sparkfun/SparkFun_Pro_Micro_RP2350/.github/README.md

SparkFun Pro Micro - RP2350
========================================

SparkFun Pro Micro - RP2350 (https://www.sparkfun.com/products/24870)

[*SparkFun Pro Micro - RP2350 (DEV-28470)*](https://www.sparkfun.com/products/24870)

The SparkFun Pro Micro - RP2350 provides a powerful development platform in SparkFun's compact Pro Micro form factor built around the RP2350 from the Raspberry Pi Foundation. This board uses the updated Pro Micro form factor and includes a USB-C connector, Qwiic connector, WS2812B addressable RGB LED, Boot and Reset buttons, resettable PTC fuse as well as PTH and castellated solder pads. The board includes two expanded memory options with 16MB of external Flash and 8MB PSRAM connected to the RP2350's QSPI controller. The RP2350 also features 520kB SRAM in ten banks, a host of peripherals including 2 UARTs, 2 SPI and 2 I<sup>2</sup>C controllers, as well as a USB 1.1 controller that allows for both host and device support. The Pro Micro - RP2350 works with C/C++ using the Pico SDK along with MicroPython development environments. 

Repository Contents
-------------------

* **/Documents** - Data sheets, additional product information 
* **/Examples** - Example code 
* **/Hardware** - Eagle design files (.brd, .sch)
* **/Production** - Production panel files (.brd)
* **/docs** - GitHub Pages documentation files

Documentation
--------------
* **[Hookup Guide](https://sparkfun.github.io/SparkFun_Pro_Micro_RP2350)** - Basic hookup guide for the Pro Micro - RP2350.
* [PSRAM Library and Examples](https://github.com/sparkfun/sparkfun-pico) - A cmake library and examples to use the on-board PSRAM when developing in the Raspberry Pi [pico-sdk](https://github.com/raspberrypi/pico-sdk).

Product Versions
----------------
* [DEV-28470](https://www.sparkfun.com/products/24870) - SparkFun Pro Micro - RP2350 development board.

License Information
-------------------

This product is _**open source**_! 

Please review the LICENSE.md file for license information. 

If you have any questions or concerns on licensing, please contact technical support on our [SparkFun forums](https://forum.sparkfun.com/viewforum.php?f=152).

Distributed as-is; no warranty is given.

- Your friends at SparkFun.
