sparkfun/SparkFun_Pro_Micro_RP2350/docs/hardware_overview.md

---
icon: material/cog
---

Let's take a closer look at the RP2350 and other hardware on this Pro Micro.

## Raspberry Pi RP2350

The RP2350 from Raspberry Pi packs a whole lot of computing punch in a tiny package. The RP2350 is a unique dual-core microcontroller that has <i>four</i> internal processors (two Arm Cortex-M33 and two Hazard3 RISC-V processors @150 MHz), though you can only select any two of these four to run at the same time. 

<figure markdown>
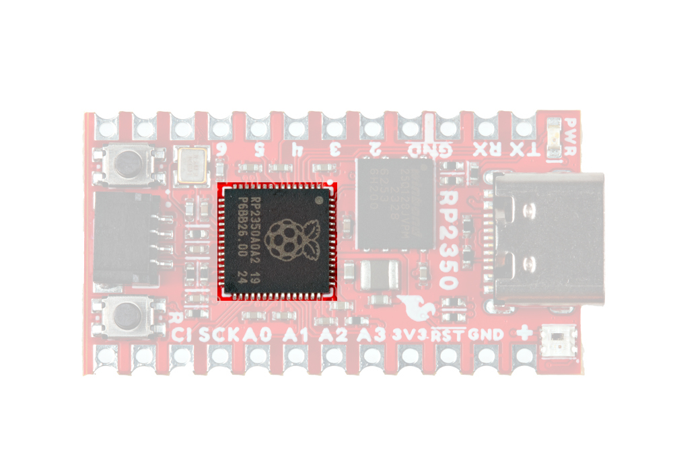
[picture p1: docs/assets/img/Pro_Micro_RP2350-RP2350.jpg]
Photo highlighting RP2350.

</figure>

This internal configuration allows users to customize the chip to their preferred architecture or to use one of each! The RP2350 includes 520kB of on-chip SRAM in ten independent banks and 8kB of one-time-programmable (OTP) storage. It also has an impressive set of security features including optional boot signing with protected OTP storage for the boot decryption key, global bus filtering (based on either Arm or RISC-V security and privilege levels) and more. For a complete overview of the RP2350, refer to the [datasheet](./assets/component_documentation/rp2350-datasheet.pdf).

The Pro Micro - RP2350 uses the "A" version of the microcontroller which has 30 3.3V-tolerant GPIO with 4 analog inputs and also includes the following peripheral options:

* 2x UART
* 2x SPI
* 2x I<sup>2</sup>C
* 24 PWM
* USB 1.1 Controller
* 12 PIO State Machines
* 1x High-Speed Transmit (HSTX) Peripheral for DVI/DSI support (not available on Pro Micro)

!!! note "Pro Micro Footprint Constraints"
	Due to size constraints on the Pro Micro footprint, only 18 GPIO are broken out, including all four analog inputs. Unfortunately, this means HSTX is <b>not</b> supported on the Pro Micro - RP2350.

The RP2350 uses five separate power supplies though this board (and most applications) combines several of them into a single regulated 3.3V supply voltage provided either over the USB-C connector or to the RAW pin. If using the RAW pin, max input voltage is <b>5.3V</b> as RAW connects directly to the WS2812 LED. 

## Memory

### W25Q128 Flash

The W25Q128 Flash IC adds 16MB of extra programming space on the Pro Micro. This connects to the RP2350 over QSPI. 

<figure markdown>
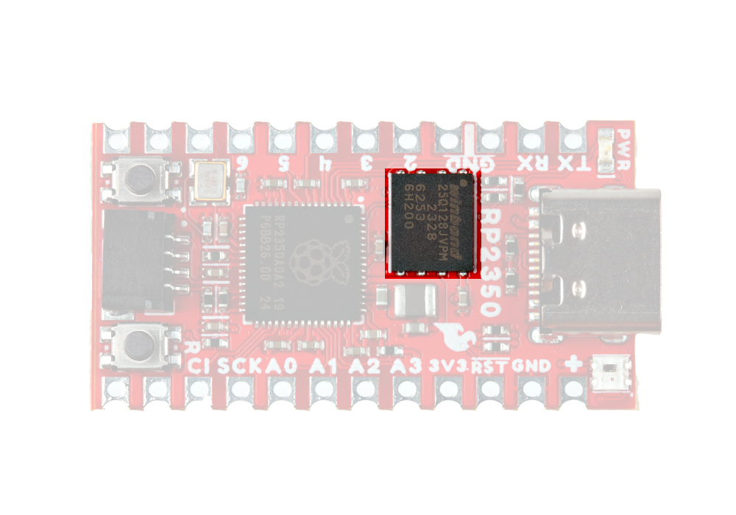
[picture p2: docs/assets/img/Pro_Micro_RP2350-Flash_IC.jpg]
Photo highlighting Flash IC.

</figure>

### PSRAM

The Pro Micro also includes an 8MB PSRAM IC for dynamic storage. This also connects to the RP2350 over QSPI. PSRAM support is included in the SparkFun MicroPython "early release" firmware found later in this guide and on the product page, but is not natively supported in the Pico SDK as of release. Refer to the Arducam Demo section of this guide for information on how to enable and set up PSRAM using the Pico SDK.

<figure markdown>
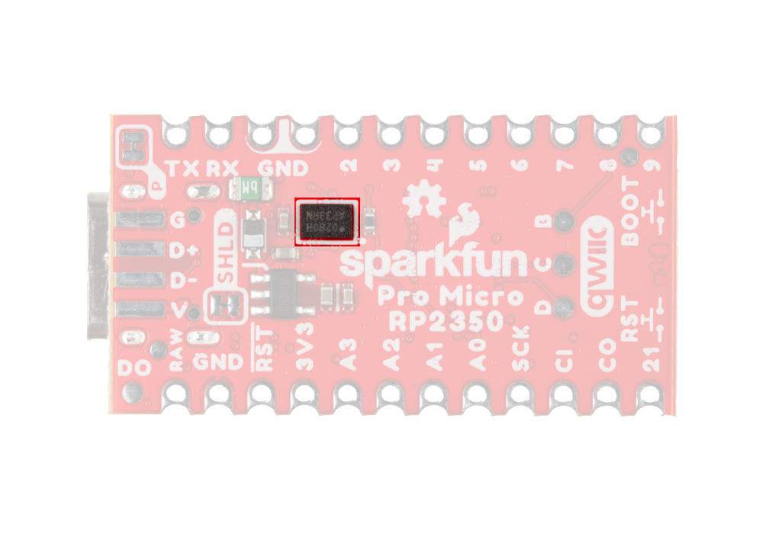
[picture p3: docs/assets/img/Pro_Micro_RP2350-IC_Back.jpg]
Photo highlighting PSRAM IC.

</figure>

For a complete overview of the PSRAM IC, refer to the [datasheet](./assets/component_documentation/APS6404L_3SQR_Datasheet.pdf).

## Connectors & Pinout

### USB-C Connector

The USB-C connector on the board acts as the primary power and programming interface. It also has surface mount solder pads on the bottom of the board for connections to the USB data lines and USB voltage. The USB-C voltage is regulated down to <b>3.3V</b> which powers all components on the board. The board also has a <b>RAW</b> PTH pin to provide a dedicated supply voltage. If using this pin, the maximum voltage allowed is <b>5.3V</b> as RAW connects directly to the WS2812.

<figure markdown>
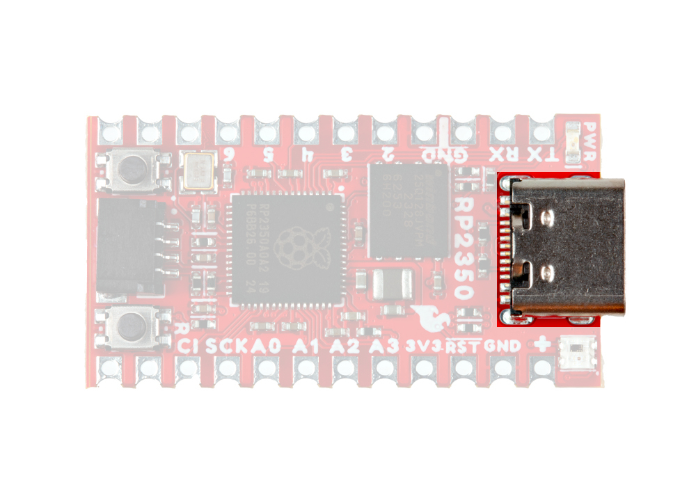
[picture p4: docs/assets/img/Pro_Micro_RP2350-USB.jpg]
Photo highlighting USB-C connector.

</figure>

### Qwiic Connector

The board includes a Qwiic connector connected to GPIO 16 (SCL) and GPIO 17 (SDA) with pull-up resistors to 3.3V.

<figure markdown>
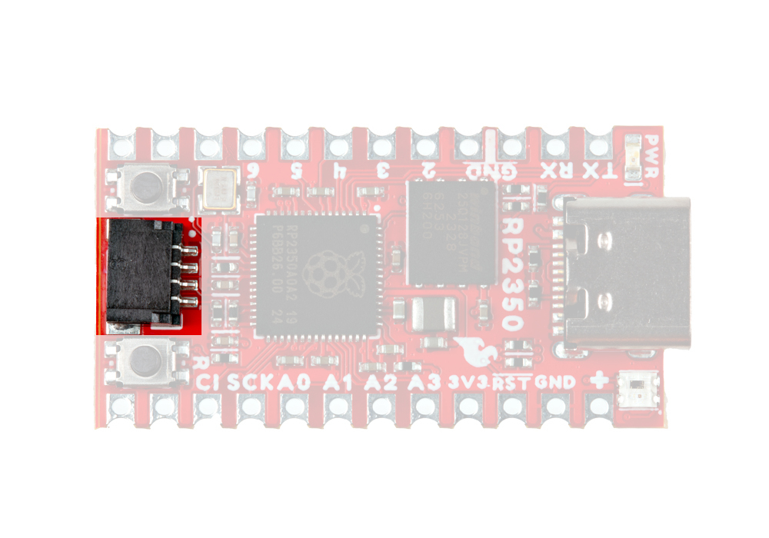
[picture p5: docs/assets/img/Pro_Micro_RP2350-Qwiic.jpg]
Photo highlighting Qwiic connector.

</figure>

### Pinout

This Pro Micro breaks out a total of 28 pins from the RP2350 including four analog pins, two UART interfaces, SPI, and six GPIO. All I/O pins are <b>3.3V</b> tolerant.

<figure markdown>
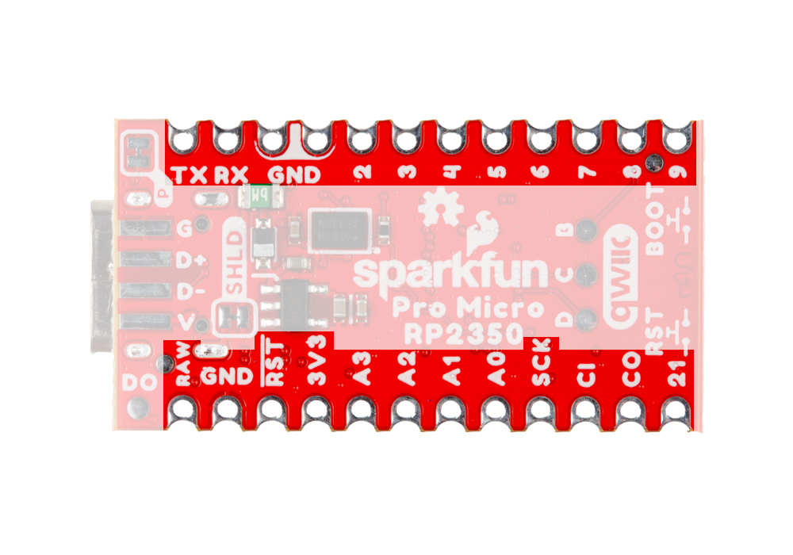
[picture p6: docs/assets/img/Pro_Micro_RP2350-GPIO_Back.jpg]
Photo highlighting PTH pinout.

</figure>

## LEDs

This Pro Micro has two LEDs; a red Power LED tied to the 3.3V line and a a WS2812 RGB LED connected to pin 25 on the RP2350.

<figure markdown>
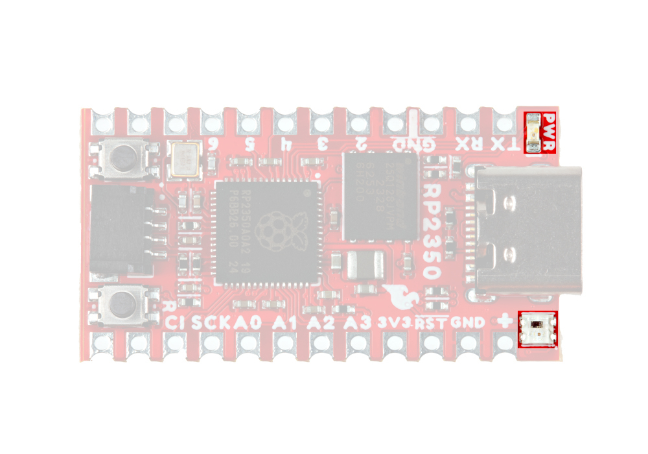
[picture p7: docs/assets/img/Pro_Micro_RP2350-LEDs.jpg]
Photo highlighting LEDs.

</figure>

The board also has a solder pad on the bottom of the board labeled <b>D0</b> that users can solder to if they would like to daisy chain more WS2812 LEDs to the one on the board.

## Buttons

The board has two push buttons connected to the RP2350's Reset and Boot lines.

<figure markdown>
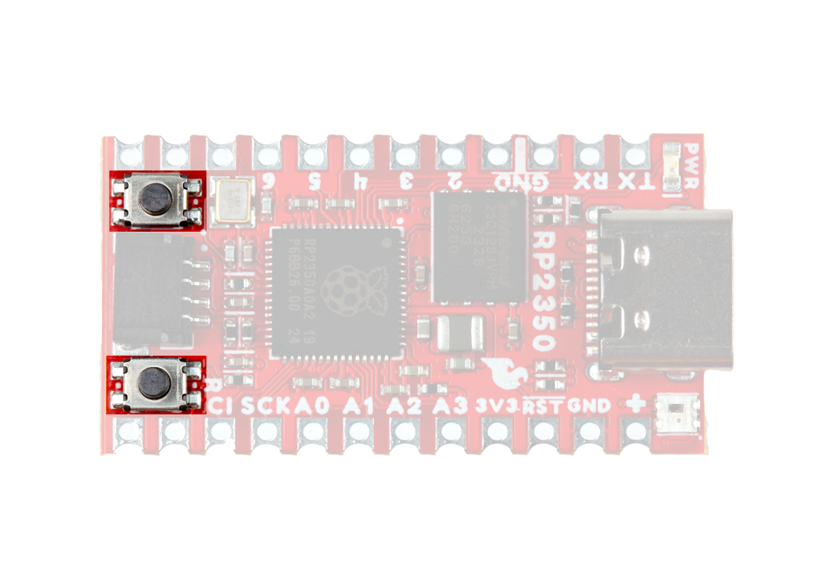
[picture p8: docs/assets/img/Pro_Micro_RP2350-Buttons.jpg]
Photo highlighting Reset and Boot buttons.

</figure>

Holding down the BOOT button during power-up or reset bypasses Flash boot mode and forces the RP2350 into USB boot mode. The buttons are labeled on the back side of the board. If you are looking at them in the orientation of the image above, the BOOT button is on top and the RESET button is on bottom.

## Solder Jumpers

??? note "Never modified a jumper before?"
	Check out our <a href="https://learn.sparkfun.com/tutorials/664">Jumper Pads and PCB Traces tutorial</a> for a quick introduction!
	<p align="center">
		<a href="https://learn.sparkfun.com/tutorials/664">
		Tutorial's thumbnail<br>
        How to Work with Jumper Pads and PCB Traces</a>
	</p>

There are two solder jumpers on the Pro Micro labeled PWR and SHLD.

<figure markdown>
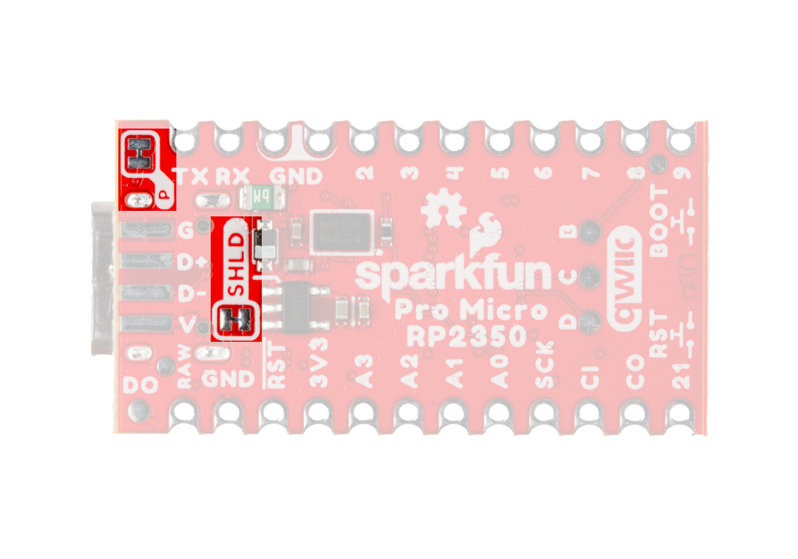
[picture p9: docs/assets/img/Pro_Micro_RP2350-Jumpers_Back.jpg]
Photo highlighting the solder jumpers.

</figure>

The PWR jumper completes the Power LED circuit and is closed by default. Open it to disable the power LED when trying to minimize the total current draw of the board. The SHLD jumper ties the USB-C connector's shield pin to the Pro Micro's ground plane and is closed by default. Open it to isolate this pin from the board's ground.

## Board Dimensions

This board matches the Pro Micro footprint and measures 1.3in x 0.7in (33.02mm x 17.78mm).

<figure markdown>
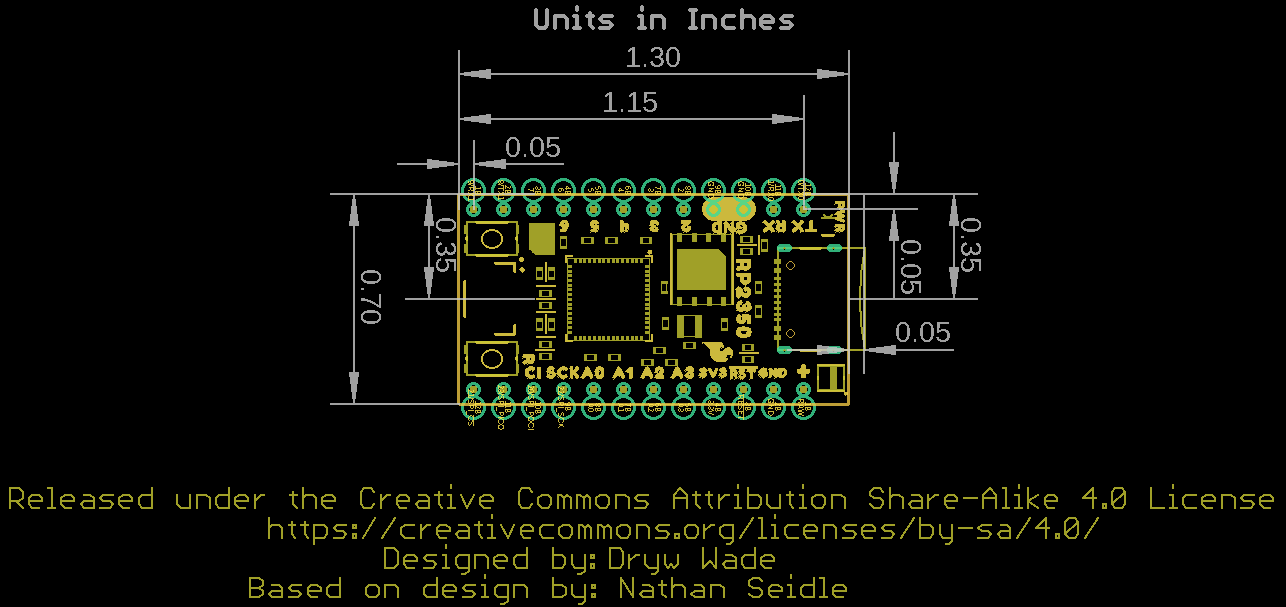
[picture p10: docs/assets/board_files/SparkFun_ProMicro_RP2350-Dimensions.png]
Board Dimensions

</figure>

??? tip "Need more measurements?"
	For more information about the board's dimensions, users can download the [Eagle files](../assets/board_files/eagle_files.zip) for the board. These files can be opened in Eagle and additional measurements can be made with the dimensions tool.

	??? info ":octicons-download-16:{ .heart } Eagle - Free Download!"
		Eagle is a [CAD]("computer-aided design") program for electronics that is free to use for hobbyists and students. However, it does require an account registration to utilize the software.

		<center>
		[Download from<br>:autodesk-primary:{ .autodesk }](https://www.autodesk.com/products/eagle/free-download "Go to downloads page"){ .md-button .md-button--primary width="250px" }
		</center>
	
	??? info ":straight_ruler: Dimensions Tool"
		This video from Autodesk demonstrates how to utilize the dimensions tool in Eagle, to include additional measurements:

		<center>
		<div class="video">
		<iframe src="https://www.youtube.com/embed/dZLNd1FtNB8" title="EAGLE Dimension Tool" frameborder="0" allow="accelerometer; autoplay; clipboard-write; encrypted-media; gyroscope; picture-in-picture" allowfullscreen></iframe>
		</div>
		</center>
