sparkfun/SparkFun_Pro_Micro_RP2350/docs/single_page.md

---
hide:
  - navigation
  - toc
icon: fontawesome/solid/scroll
---

--8<-- "./docs/introduction.md:5"

# Hardware Overview
--8<-- "./docs/hardware_overview.md:5"

# Hardware Assembly

## Basic Assembly
--8<-- "./docs/basic_assembly.md:5"

## Arducam Demo Assembly
--8<-- "./docs/camera_assembly.md:5"

# Software Setup

## UF2 Bootloader
--8<-- "./docs/uf2.md:5"

## Pico SDK
--8<-- "./docs/picoSDK_setup.md:5"

## MicroPython
--8<-- "./docs/micropython_setup.md:5"

## CircuitPython
--8<-- "./docs/circuitpython_setup.md:5"

## Arduino
--8<-- "./docs/arduino_setup.md:5"

# Examples

## Arducam Demo
--8<-- "./docs/camera_demo.md:5"

## MicroPython Examples
--8<-- "./docs/micropython_examples.md:5"

# Troubleshooting
--8<-- "./docs/troubleshooting.md:5"

# Resources:
--8<-- "./docs/resources.md"
