sparkfun/SparkFun_Pro_Micro_RP2350/docs/resources.md

For more resources related to the SparkFun Pro Micro RP2350, check out the links listed here: 

* [Product Page](https://www.sparkfun.com/products/28470)
* [Schematic](./assets/board_files/SparkFun_ProMicro_RP2350.pdf) (PDF)
* [Eagle Files](./assets/board_files/SparkFun_ProMicro_RP2350.zip) (ZIP)
* [Board Dimensions](./assets/board_files/SparkFun_ProMicro_RP2350-Dimensions.png) (PDF)
* [RP2350 Datasheet](./assets/component_documentation/rp2350-datasheet.pdf) (PDF)
* [APS6404L PRSAM Datasheet](./assets/component_documentation/APS6404L_3SQR_Datasheet.pdf) (PDF)
* [RP2350 MicroPython Firmware (Beta)](https://github.com/sparkfun/micropython-rp2350/releases)
* [SparkFun Pico SDK Library](https://github.com/sparkfun/sparkfun-pico)
* [Arduino Pico Arduino Core](https://github.com/earlephilhower/arduino-pico)
* [Raspberry Pi RP2350 Microcontroller Documentation](https://www.raspberrypi.com/documentation/microcontrollers/silicon.html#rp2350)
* [Hardware GitHub Respository](https://github.com/sparkfun/SparkFun_Pro_Micro_RP2350)
* [SFE Product Showcase](https://www.youtube.com/watch?v=UnIa2jbEHRk)
