sparkfun/SparkFun_Pro_Micro_RP2350/docs/introduction.md

---
icon: material/book-open-page-variant
---

<div class="grid cards desc" markdown>

-    <a href="https://www.sparkfun.com/products/24870">
    **SparkFun Pro Micro - RP2350**<br>
    **SKU:** DEV-24870

    ---

    <figre markdown>
    Product Thumbnail
    </figure></a>

    <center>
    <article class="video_desc">
    <iframe src="https://www.youtube.com/embed/UnIa2jbEHRk?si=XnEA8HMVTOBFbfAe" title="Product Showcase: Sparkfun Pro Micro - RP2350" frameborder="0" allow="accelerometer; autoplay; clipboard-write;encrypted-media; gyroscope; picture-in-picture" allowfullscreen></iframe>
    </article>
    </center>

-    The SparkFun Pro Micro - RP2350 provides a powerful development platform in SparkFun's compact Pro Micro form factor built around the RP2350 from the Raspberry Pi Foundation. This board uses the updated Pro Micro form factor and includes a USB-C connector, Qwiic connector, WS2812B addressable RGB LED, Boot and Reset buttons, resettable PTC fuse as well as PTH and castellated solder pads. This board also includes external memory for the RP2350 with 16MB Flash and 8MB PSRAM both tied to the RP2350's QSPI controller. <br><br>
    The RP2350 is a unique dual-core microcontroller with two ARM<sup>&reg;</sup> Cortex<sup>&reg;</sup> M33 processors and two Hazard3 RISC-V processors, all running at up to 150 MHz! Now, this doesn't mean the RP2350 is a quad-core microcontroller. Instead, users can select which two processors to run on boot instead. You can run two processors of the same type or one of each. The RP2350 also features 520kB SRAM in ten banks, a host of peripherals including two UARTs, two SPI and two I<sup>2</sup>C controllers, and a USB 1.1 controller for host and device support.

    <center>
    [Purchase from SparkFun :fontawesome-solid-cart-plus:{ .heart }](https://www.sparkfun.com/products/24870){ .md-button .md-button--primary }
    </center>

</div>

## Required Materials

For basic use of the Pro Micro - RP2350 all you'll need is a USB-C cable like the ones listed below:

<div class="grid cards" markdown>

-   <a href="https://www.sparkfun.com/products/14743">

    <figure markdown>
    USB 3.1 Cable A to C - 3 Foot
    </figure>
    </a>
    ---
    <a href="https://www.sparkfun.com/products/14743">
    **USB 3.1 Cable A to C - 3 Foot**<br>
    CAB-14743
    </a>

-   <a href="https://www.sparkfun.com/products/15424">
    
    <figure markdown>
    Reversible USB A to C Cable - 2m
    </figure>
    </a>
    ---
    <a href="https://www.sparkfun.com/products/15424">
    **Reversible USB A to C Cable - 2m**<br>
    CAB-15424
    </a>
</div>

You may also want to get a Qwiic cable or kit to connect the Pro Micro - RP2350 to other Qwiic devices:

<div class="grid cards" markdown>

-   <a href="https://www.sparkfun.com/products/17260">
    
    <figure markdown>
    Qwiic Cable - 50mm
    </figure>
    </a>
    ---
    <a href="https://www.sparkfun.com/products/17260">
    **Flexible Qwiic Cable - 50mm**<br>
    PRT-17260
    </a>

-   <a href="https://www.sparkfun.com/products/17257">
    
    <figure markdown>
    Flexible Qwiic Cable - 500mm
    </figure>
    </a>
    ---
    <a href="https://www.sparkfun.com/products/17257">
    **Flexible Qwiic Cable - 500mm**<br>
    PRT-17257
    </a>

-   <a href="https://www.sparkfun.com/products/17261">

    <figure markdown>
    Flexible Qwiic Cable - Female Jumper (4-pin)
    </figure>
    </a>
    ---
    <a href="https://www.sparkfun.com/products/17261">**Flexible Qwiic Cable - Female Jumper (4-pin)**<br>
    CAB-17261
    </a>

-   <a href="https://www.sparkfun.com/products/15081">

    <figure markdown>
    SparkFun Qwiic Cable Kit
    </figure>
    </a>
    ---
    <a href="https://www.sparkfun.com/products/15081">
    **SparkFun Qwiic Cable Kit**<br>
    PRT-15081
    </a>

</div>

### Tools

If you prefer a soldered connection or want to modify the solder jumpers on this board, you may need some of the products listed below:

<div class="grid cards" markdown align="center">

-   <a href="https://www.sparkfun.com/products/9507">
    
    <figure markdown>
    PINECIL - Smart Mini Portable Soldering Iron
    </figure>
    </a>
    ---
    <a href="https://www.sparkfun.com/products/23913">
    **PINECIL - Smart Mini Portable Soldering Iron**<br>
    TOL-23913
    </a>

-   <a href="https://www.sparkfun.com/products/9200">
    
    <figure markdown>
    Hobby Knife
    </figure>
    </a>
    ---
    <a href="https://www.sparkfun.com/products/9200">
    **Hobby Knife**<br>
    TOL-09200
    </a>

-   <a href="https://www.sparkfun.com/products/14579">

    <figure markdown>
    Chip Quik No-Clean Flux Pen - 10mL
    </figure>
    </a>
    ---
    <a href="https://www.sparkfun.com/products/14579">**Chip Quik No-Clean Flux Pen - 10mL**<br>
    TOL-14579
    </a>
</div>

### Camera PSRAM Example Materials

This guide includes a detailed example on how to use the PSRAM included on the Pro Micro - RP2350 using a camera connected to the board. If you'd like to follow along with that example, you'll need the following materials. You'll certainly need the camera linked below along with optionaly headers, a breadboard, and jumper wire for prototyping the circuit.

<div class="grid cards" markdown>

-   <a href="https://www.sparkfun.com/products/18440">
    <figure markdown>
    Product Thumbnail
    </figure>

    ---

    **Arducam 5MP Plus OV5642 Mini Camera Module**</br>
    DEV-18440</a>

-   <a href="https://www.sparkfun.com/products/116">
    <figure markdown>
    Product Thumbnail
    </figure>

    ---

    **Break Away Headers - Straight**</br>
    PRT-00116</a>

-   <a href="https://www.sparkfun.com/products/12615">
    <figure markdown>
    Product Thumbnail
    </figure>

    ---

    **Breadboard - Full-Size (Bare)**</br>
    PRT-12615</a>

-   <a href="https://www.sparkfun.com/products/124">
    <figure markdown>
    Product Thumbnail
    </figure>

    ---

    **Jumper Wire Kit - 140pcs**</br>
    PRT-00124</a>

</div>

## Suggested Reading

We designed this board for integration into SparkFun's Qwiic connect system.  Click on the banner below to learn more about the [SparkFun Qwiic Connect System](https://www.sparkfun.com/qwiic).

<div style="text-align: center">
<table>
  <tr>
   <td>
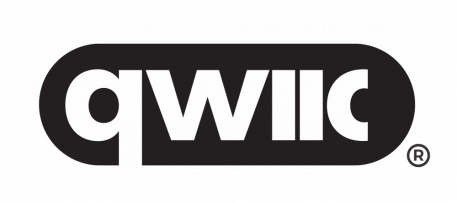
[picture p11: docs/assets/img/Qwiic-registered-updated.png]
Qwiic Connect System Click to learn more about the Qwiic Connect System!
   <div style="text-align: center"></div>
   </td>
  </tr>
  <tr>
    <td><div style="text-align: center"><i><a href="https://www.sparkfun.com/qwiic">Qwiic Connect System</a></i></div></td>
  </tr>
</table>
</div>

Before getting started with this Hookup Guide, you may want to read through the tutorials below if you are not familiar with the concepts covered in them or want a refresher. If you are using either of the Qwiic Shields linked above, we recommend reading through their respective Hookup Guides before continuing with this tutorial:

<div class="grid cards hide col-4" markdown align="center">

-   <a href="https://learn.sparkfun.com/tutorials/8">
    <figure markdown>
    Serial Communication
    </figure>
    </a>
    <a href="https://learn.sparkfun.com/tutorials/8">**Serial Communication**
    </a>

-   <a href="https://learn.sparkfun.com/tutorials/82">
    <figure markdown>
    I2C
    </figure>
    </a>
    <a href="https://learn.sparkfun.com/tutorials/82">**I2C**
    </a>

-   <a href="https://learn.sparkfun.com/tutorials/62">
    <figure markdown>
    Logic Levels
    </figure>
    </a>
    <a href="https://learn.sparkfun.com/tutorials/62">**Logic Levels**
    </a>

-   <a href="https://learn.sparkfun.com/tutorials/112">
    <figure markdown>
    Serial Terminal Basics
    </figure>
    </a>
    <a href="https://learn.sparkfun.com/tutorials/112">**Serial Terminal Basics**
    </a>

-   <a href="https://learn.sparkfun.com/tutorials/664">
    <figure markdown>
    How to Work with Jumper Pads and PCB Traces
    </figure>
    </a>
    <a href="https://learn.sparkfun.com/tutorials/664">**How to Work with Jumper Pads and PCB Traces**
    </a>
</div>
