sparkfun/SparkFun_Pro_Micro_RP2350/docs/assets/img/DEV-24870-Pro-Micro-RP2350-Feature.jpg

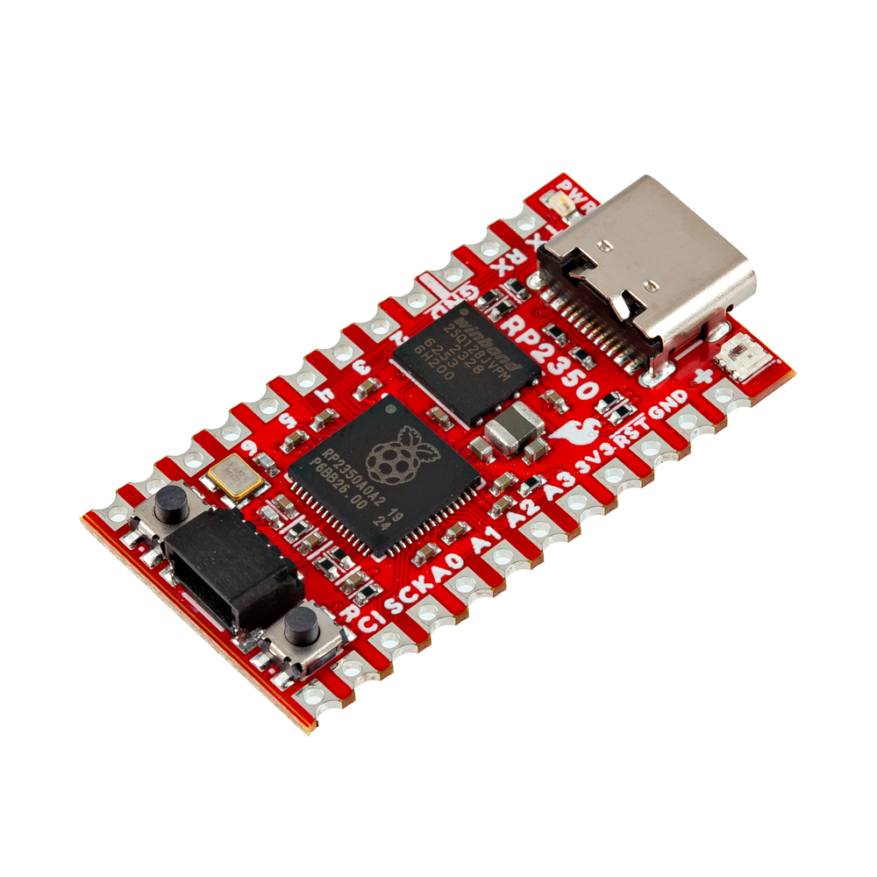
docs/assets/img/DEV-24870-Pro-Micro-RP2350-Feature.jpg
