sparkfun/SparkFun_Pro_Micro_RP2350/docs/assets/img/Pro_Micro_Boot3.jpg

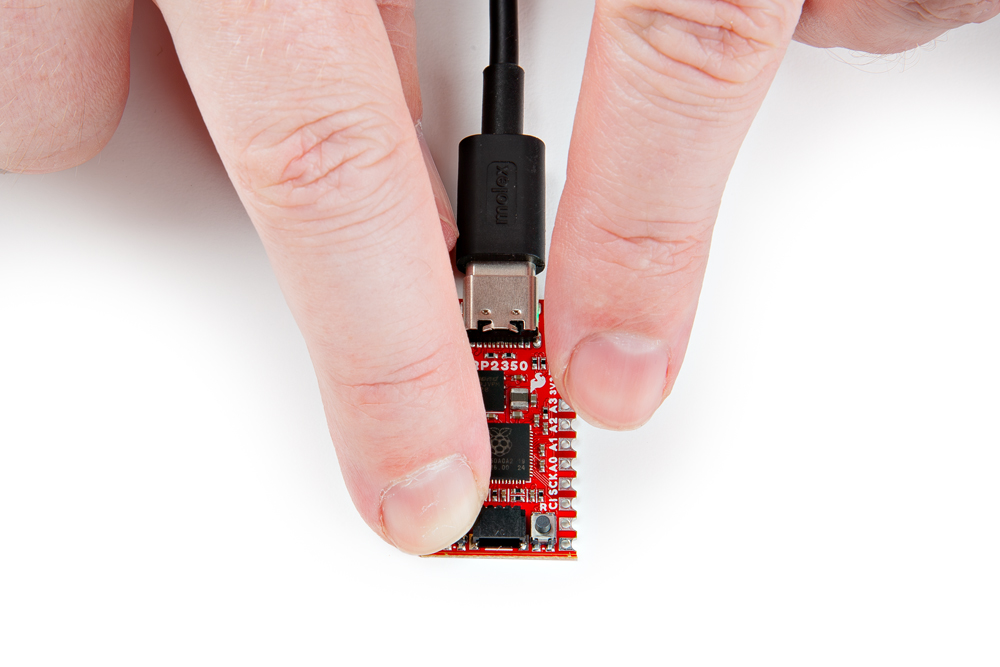
docs/assets/img/Pro_Micro_Boot3.jpg
