sparkfun/SparkFun_Pro_Micro_RP2350/docs/assets/img/Pro_Micro_RP2350-Power.jpg

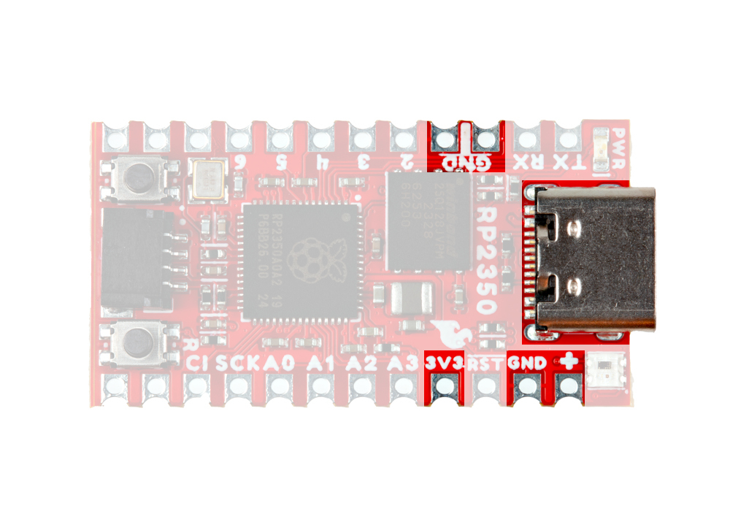
docs/assets/img/Pro_Micro_RP2350-Power.jpg
