sparkfun/SparkFun_Pro_Micro_RP2350/docs/circuitpython_setup.md

## Setup

The Pro Micro - RP2350 is included in the [latest release](https://github.com/adafruit/circuitpython/releases/tag/9.2.1) of CircuitPython. If you've never used CircuitPython before, take a read through their tutorial [here](https://learn.adafruit.com/welcome-to-circuitpython) or click the button below:

<center>
    [Welcome to CircuitPython](https://learn.adafruit.com/welcome-to-circuitpython){ .md-button .md-button--primary}
</center>

## Thing Plus - RP2350 Firmware

Download the latest firmware for the Pro Micro - RP2350 from the [CircuitPython downloads page](https://circuitpython.org/downloads) and search for "Pro Micro RP2350".
