sparkfun/SparkFun_Pro_Micro_RP2350/docs/picoSDK_setup.md

## Raspberry Pi Pico SDK

The Pico C SDK is a C/C++ development kit for Raspberry Pi microcontrollers including the RP2350. Click on the links below for complete documentation on installing and using the SDK.

<center>
    [Pico C SDK Documentation](https://www.raspberrypi.com/documentation/pico-sdk/){ .md-button .md-button--primary }
</center>

<center>
    [Pico C SDK GitHub Repository](https://github.com/raspberrypi/pico-sdk){ .md-button .md-button--primary }
</center>

### Pro Micro - RP2350 Board Definition

With the release of Pico SDK v2.1, the Pro Micro - RP2350 is included with it's on board definition. When uploading, select `sparkfun_promicro_rp2350`.
