sparkfun/SparkFun_Pro_Micro_RP2350/Production/ordering_instructions.txt

panel size, 201x138mm
PCB thickness, 0.8mm
number of layers, 4
controlled impedance, JLC7628
soldermask color, Red
silkscreen color, White
oz copper, 1oz
finish, HASL lead free
stencils, top+bottom
pcs per panel, 24
min trace width, 0.1270mm / 0.0050in
min drill size, 0.2000mm / 0.0079in
filename to layer stackup 1/2/3/4: GTL, GL2, GL3, GBL
