sparkfun/SparkFun_Pro_Micro_RP2350/docs/troubleshooting.md

!!! info
    <p><span class="glyphicon glyphicon-question-sign" aria-hidden="true"></span> <strong>Not working as expected and need help? </strong></p>
    <p>If you need technical assistance and more information on a product that is not working as you expected, we recommend heading on over to the <a href="https://www.sparkfun.com/technical_assistance">SparkFun Technical Assistance</a> page for some initial troubleshooting.</p>
    <center>
    [SparkFun Technical Assistance Page](https://www.sparkfun.com/technical_assistance){ .md-button .md-button--primary }
    </center>
    <p>If you can't find what you need there, head over to the <a href="https://community.sparkfun.com/">SparkFun Support Forum</a> to create an account, search product forums, and post questions.<p>
