sparkfun/SparkFun_Pro_Micro_RP2350/(threads)

Thread 1 (2024-08-13):

HSTX pins not available

leo60228, 2024-08-13:
The 8 HSTX pins are not included in the pinout, so the new HSTX functionality in the RP2350 cannot be used.

This is despite the HSTX peripheral being mentioned in the documentation, without a caveat that it isn't usable on this board: https://docs.sparkfun.com/SparkFun_Pro_Micro_RP2350/hardware_overview/#raspberry-pi-rp2350

sfe-SparkFro, 2024-08-19:
Thanks for pointing this out! We've updated that with a mention that it's not available on the Pro Micro.

Thread 2 (2024-08-17):

micropython example is wrong

vruumllc, 2024-08-17:
It should be:

led[0]=(255,0,0)
led.write()

not:

n[0]=(255,0,0)
n.write()

SFEMark, 2024-08-19:
Fixed in the latest commit. Thanks!

vruumllc, 2024-08-24:
Thank you!

Closed 2024-08-19.

Thread 3 (2024-08-17):

Please add example to restore shipping configuration

vruumllc, 2024-08-17:
Hi,
Could you please add the program that ships with the Pro_Micro_RP2350 to the examples (it cycles through all the neopixel colors).
Thanks

sfe-SparkFro, 2024-08-19:
Hi there, just pushed the compiled UF2 file for you. It's just a derivate of this example: https://github.com/raspberrypi/pico-examples/tree/master/pio/ws2812

vruumllc, 2024-08-24:
Thanks!

znmeb, 2024-08-25:
Where is the source for that? I can add it to my development environment. I have a script that builds all the examples for all the boards I have, including the SparkFun Pro Micro RP2350.

Closed 2024-08-19.
