sparkfun/SparkFun_Pro_Micro_RP2350/docs/assets/board_files/SparkFun_ProMicro_RP2350.pdf

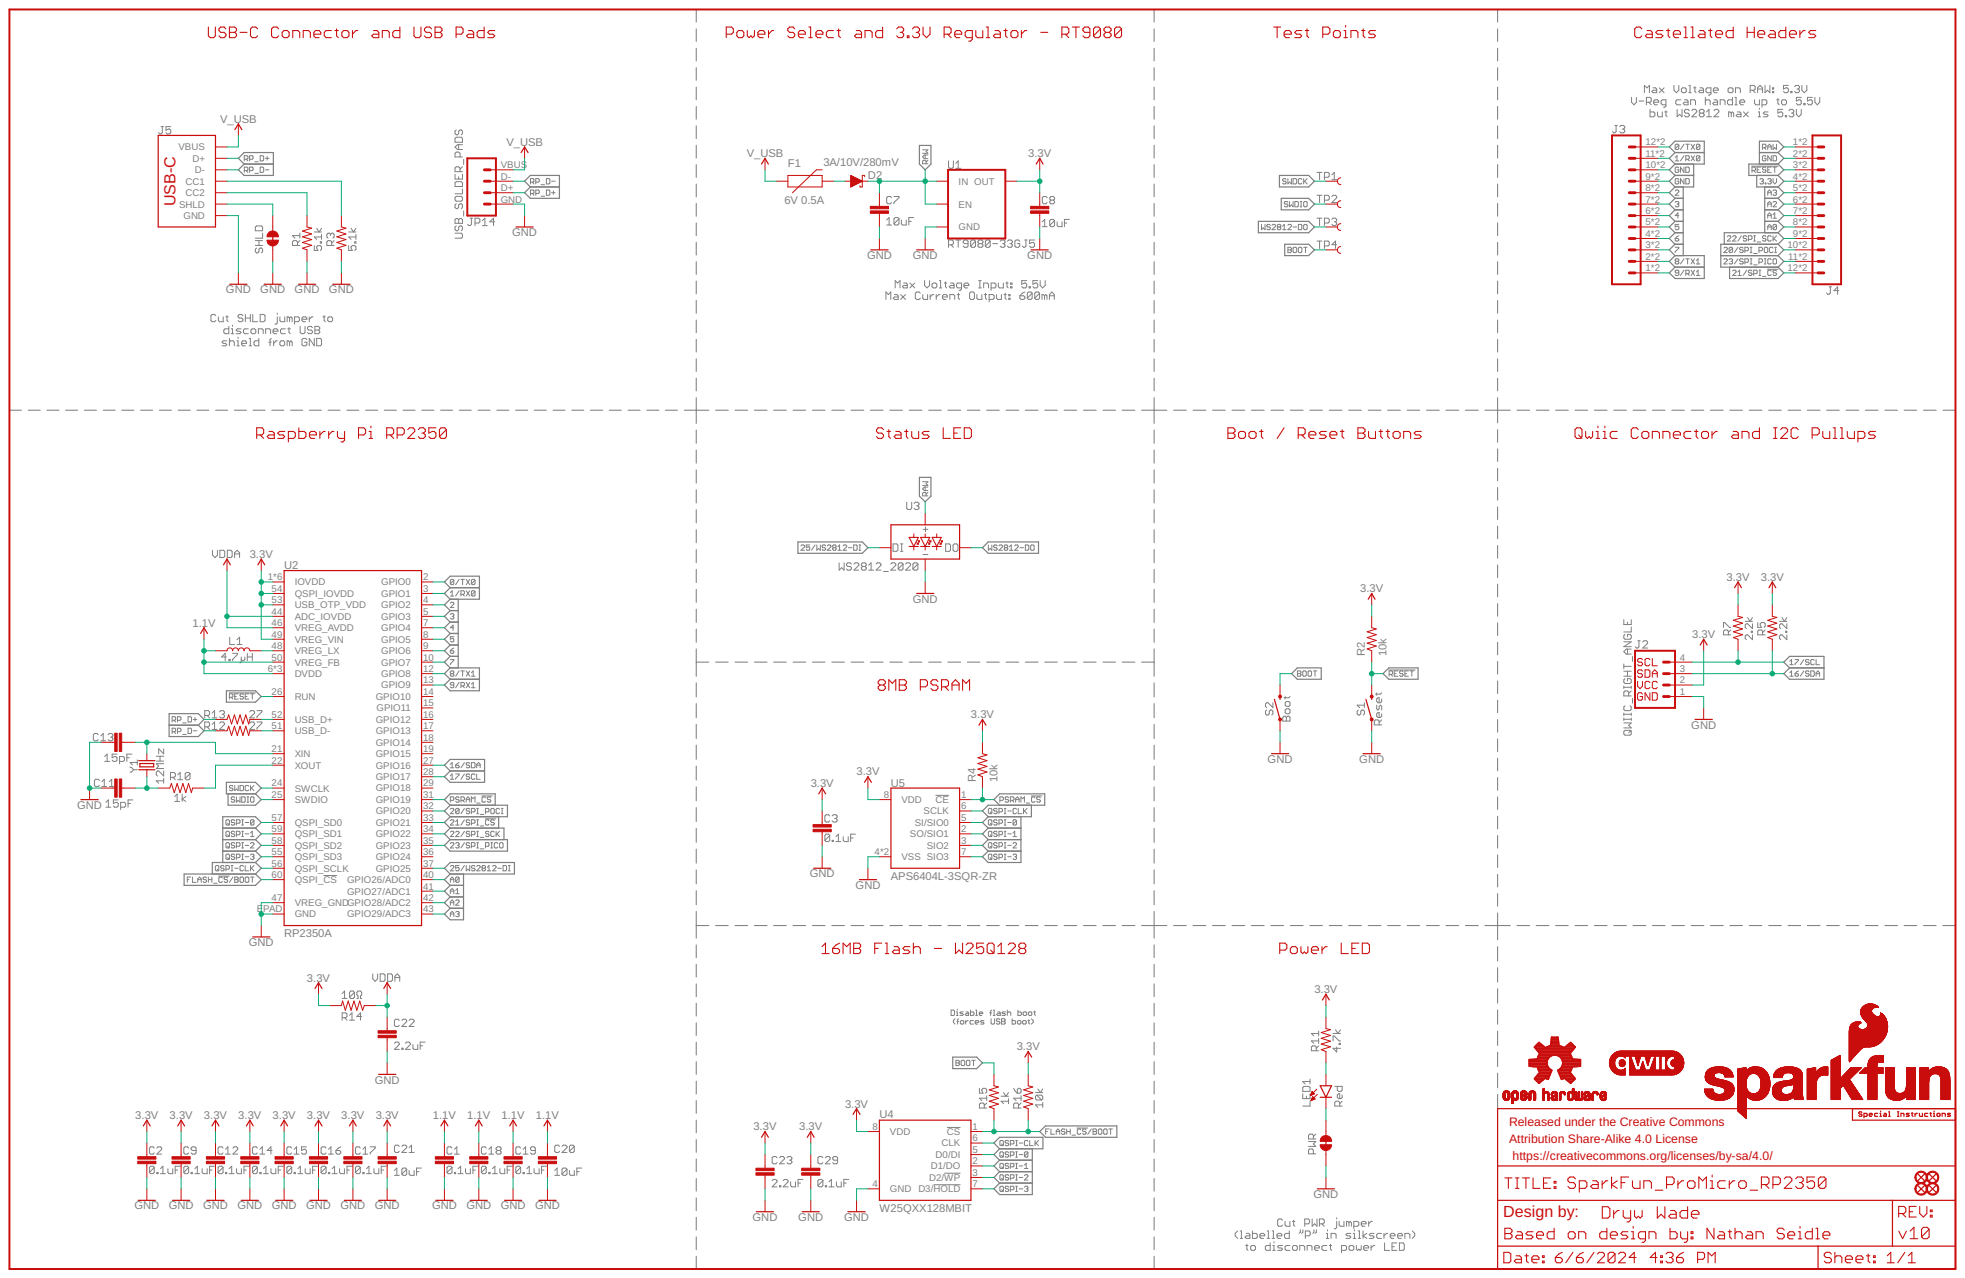
[picture p29: page 1]

10k 6V 0.5A3A/10V/280mV GND GND GND GND GND GND GND GND V_USB V_USB GND 3.3V 3.3V 3.3V 3.3V GND GND 3.3V GND 3.3V GND 3.3V GND 3.3V GND 3.3V GND 3.3V GND 3.3V GND GND 1.1V 3.3V 1.1V 1.1V 1.1V GND GND 3.3V GND GND GND W25QXX128MBIT GND 3.3V 3.3V 3.3V 3.3V GND 3.3V GND RP2350A GND 1.1V GND 3.3V GND V_USB GND 3.3V APS6404L-3SQR-ZR GND 3.3V 10k 3.3V GND 3.3V R2 F1 D2 INGNDOUT EN 1234 1*2 2*2 3*2 4*2 5*2 6*2 7*2 8*2 9*2 10*2 11*2 12*2 1*2 2*2 3*2 4*2 5*2 6*2 7*2 8*2 9*2 10*2 11*2 12*2 VBUS D- D+GND GND VBUS CC1 D+D- CC2 SHLD VDD 8 GND 4 D3/HOLD 7 D2/WP 3 D1/DO 2 D0/DI 5 CLK 6 CS 1 U4 RUN 26 DVDD 6*3 USB_D+ 52 USB_D- 51 GND EPAD USB_OTP_VDD 53 GPIO0 2 ADC_IOVDD 44 SWDIO 25 SWCLK 24 IOVDD 1*6 XIN 21 XOUT 22 GPIO1 3 GPIO2 4 GPIO3 5 GPIO4 7 GPIO5 8 GPIO6 9 GPIO7 10 GPIO8 12 GPIO9 13 GPIO10 14 GPIO11 15 GPIO12 16 GPIO13 17 GPIO14 18 GPIO15 19 GPIO16 27 GPIO17 28 GPIO18 29 GPIO19 31 GPIO20 32 GPIO21 33 GPIO22 34 GPIO23 35 GPIO24 36 GPIO25 37 GPIO26/ADC0 40 GPIO27/ADC1 41 GPIO28/ADC2 42 GPIO29/ADC3 43 VREG_VIN 49 VREG_AVDD 46 QSPI_SD3 55 QSPI_SCLK 56 QSPI_SD0 57 QSPI_SD2 58 QSPI_SD1 59 QSPI_CS 60 VREG_GND 47 VREG_LX 48 VREG_FB 50 QSPI_IOVDD 54 U2 VDD 8 VSS 4*2 CE 1 SCLK 6 SI/SIO0 5 SO/SIO1 2 SIO2 3 SIO3 7 U5 R4 USB-C Released under the Creative Commons Attribution Share-Alike 4.0 License https://creativecommons.org/licenses/by-sa/4.0/ Design by:
