sparkfun/SparkFun_Pro_Micro_RP2350/Hardware/SparkFun_ProMicro_RP2350.brd

## EAGLE design Hardware/SparkFun_ProMicro_RP2350.brd (2024-06-06)

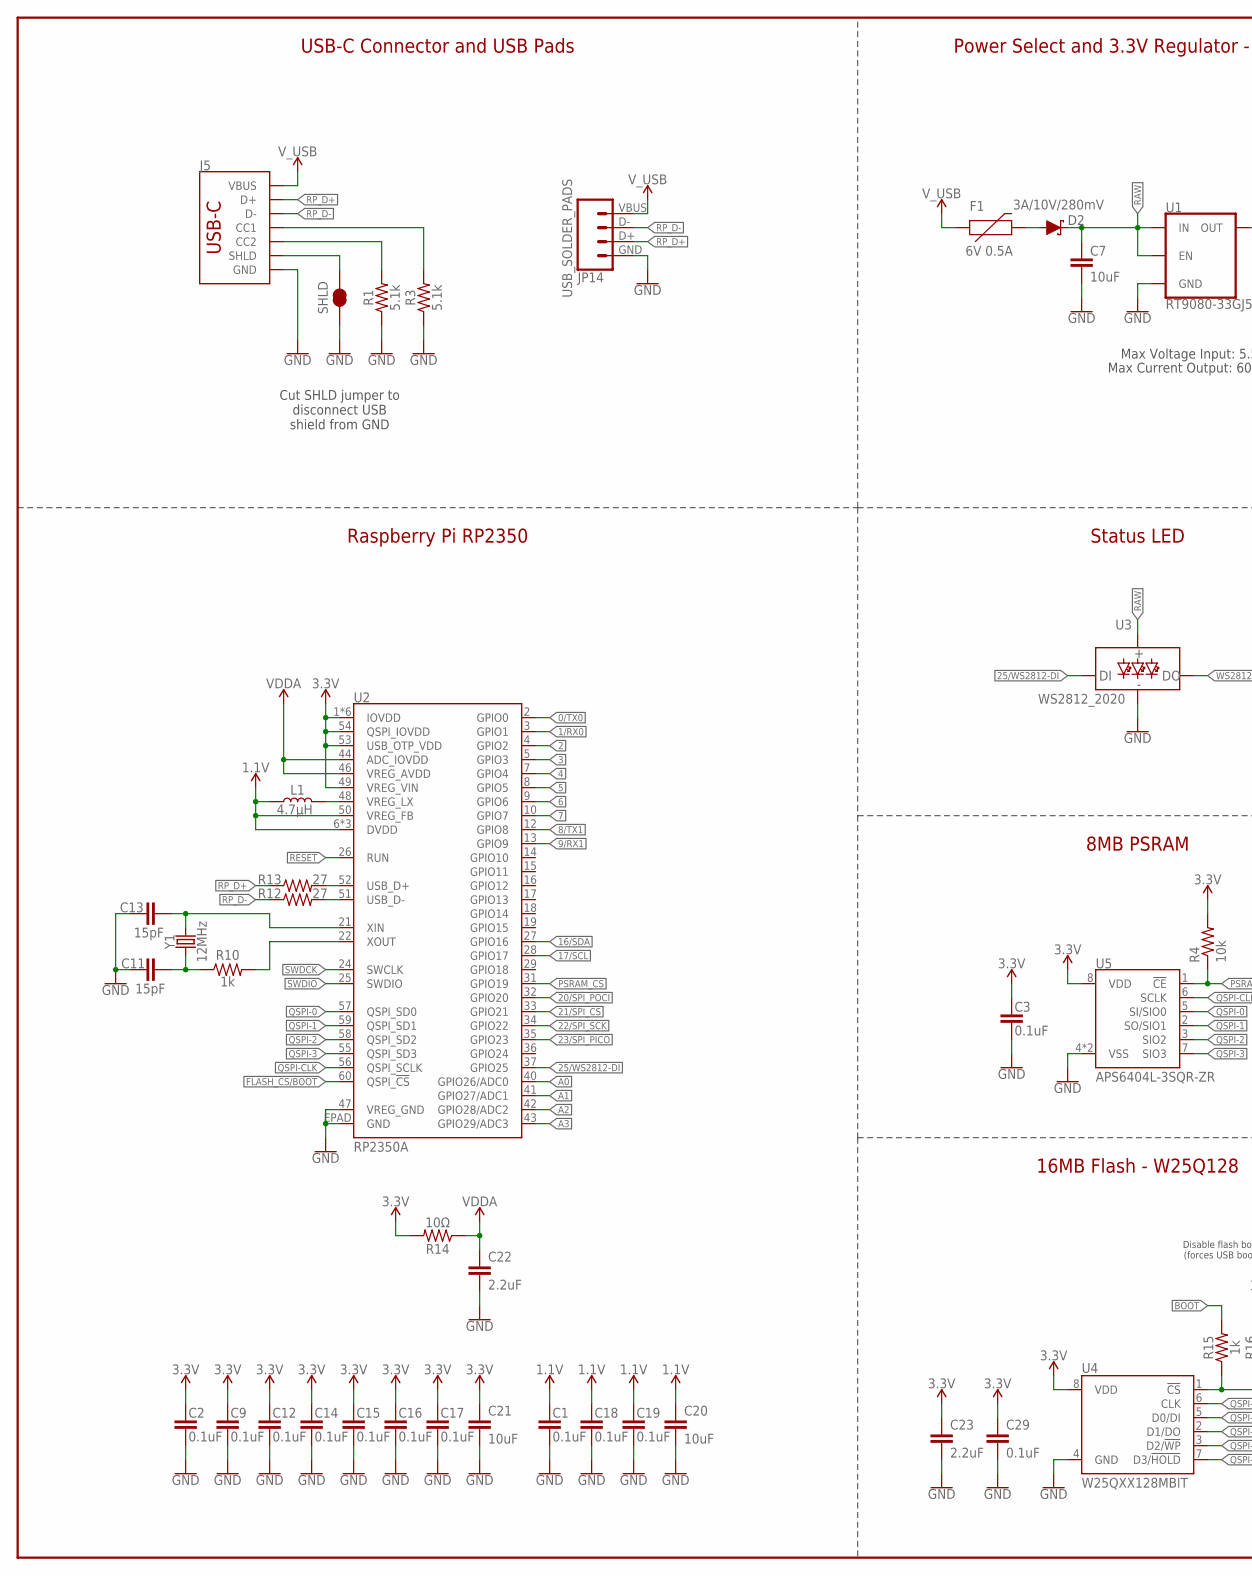
[picture p30: schematic SparkFun_ProMicro_RP2350.sch, part in row 1, column 1]

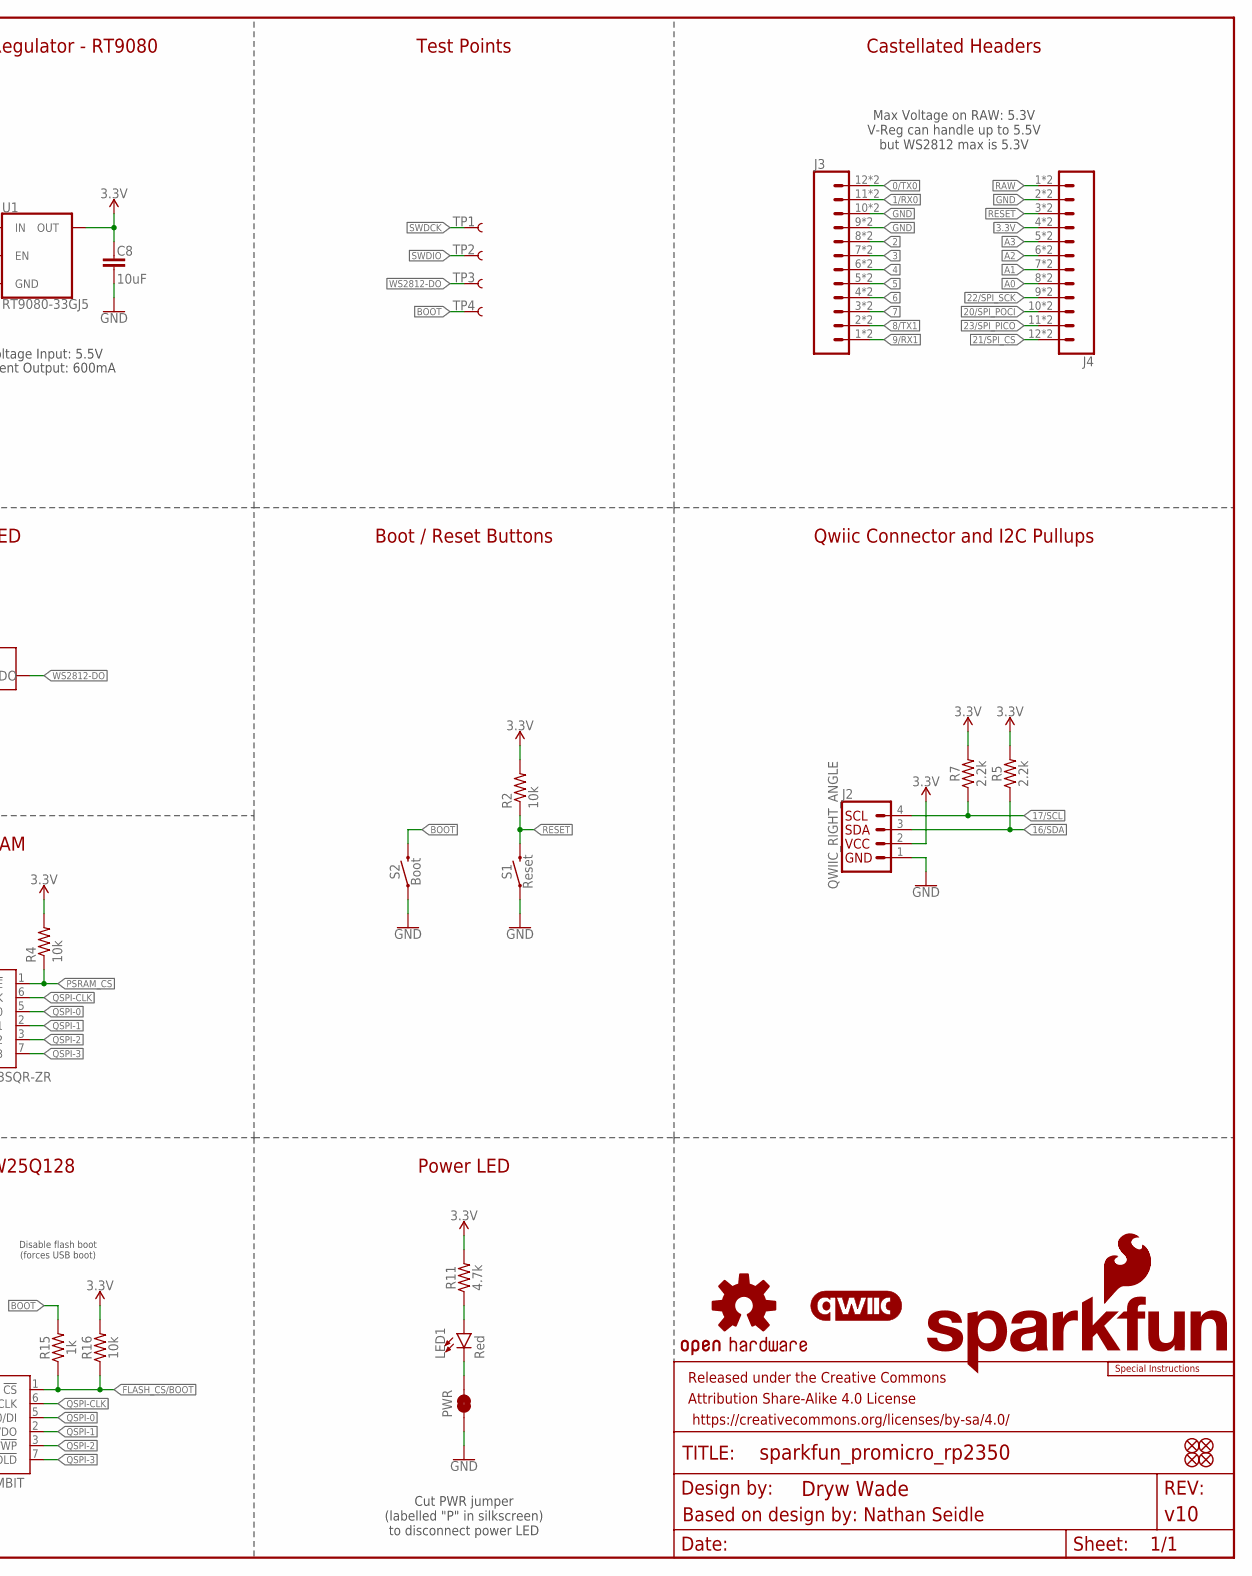
[picture p31: schematic SparkFun_ProMicro_RP2350.sch, part in row 1, column 2]

Parts:
C1, C2, C3, C9, C12, C14, C15, C16, C17, C18, C19, C29: 0.1uF; 0402-TIGHT
C7, C8, C20, C21: 10uF; 0402-TIGHT
C11, C13: 15pF; 0402-TIGHT
C22, C23: 2.2uF; 0402-TIGHT
D2: 3A/10V/280mV; SOD-323
F1: 6V 0.5A; 0805
FRAME2: FRAME-LEDGER; CREATIVE_COMMONS
J2: QWIIC_RIGHT_ANGLE; JST04_1MM_RA
J3, J4: CONN_12CASTELLATED; 1X12_CASTELLATED
J5: USB Female Type C Connector; USB-C-16P_4LAYER-PADS
JP1, JP2, JP3, JP4: FIDUCIAL1X2; FIDUCIAL-1X2
JP14: USB_SOLDER_PADS; USB-SOLDER-PADS
L1: 4.7μH; 1008(2520)
LED1: Red; LED-0603
LOGO1: SFE_LOGO_NAME_FLAME.1_INCH; SFE_LOGO_NAME_FLAME_.1
LOGO3: QWIIC_LOGO_6MM; QWIIC_6MM
LOGO4: SFE_LOGO_FLAME.1_INCH; SFE_LOGO_FLAME_.1
LOGO5: SPECIAL_INSTRUCTIONS-ORDERING; ORDERING_INSTRUCTIONS
PWR: JUMPER-SMT_2_NC_TRACE_SILK; SMT-JUMPER_2_NC_TRACE_SILK
R1, R3: 5.1k; 0402-TIGHT
R2, R4, R16: 10k; 0402-TIGHT
R5, R7: 2.2k; 0402-TIGHT
R10, R15: 1k; 0402-TIGHT
R11: 4.7k; 0402-TIGHT
R12, R13: 27; 0402-TIGHT
R14: 10Ω; 0402-TIGHT
S1: Reset; TACTILE_SWITCH_SMD_4.6X2.8MM
S2: Boot; TACTILE_SWITCH_SMD_4.6X2.8MM
SHLD: JUMPER-SMT_2_NC_TRACE_SILK; SMT-JUMPER_2_NC_TRACE_SILK
TP1, TP2, TP3, TP4: TEST-POINT3X5; PAD.03X.05
U1: RT9080-33GJ5; SOT23-5
U2: RP2350A
U3: WS2812_2020; WS2812-2020
U4: W25QXX128MBIT; WSON-8-6X5-SKINNY_CENTERPAD
U5: APS6404L-3SQR-ZR
U$3: OSHW-LOGOMINI; OSHW-LOGO-MINI
Y1: 12MHz; CRYSTAL-SMD-2X2.5MM

Connections:
0/TX0: J3.12, J3.12B (12), U2.2 (GPIO0)
1.1V: C1.1, C18.1, C19.1, C20.1, L1.1, U2.6 (DVDD), U2.23 (DVDD), U2.39 (DVDD), U2.50 (VREG_FB)
1/RX0: J3.11, J3.11B (11), U2.3 (GPIO1)
2: J3.8, J3.8B (8), U2.4 (GPIO2)
3: J3.7, J3.7B (7), U2.5 (GPIO3)
3.3V: C2.1, C3.1, C8.2, C9.1, C12.1, C14.1, C15.1, C16.1, C17.1, C21.1, C23.1, C29.1, J2.2, J4.4, J4.4B (4), R2.2, R4.2, R5.2, R7.2, R11.2, R14.2, R16.2, U1.5 (OUT), U2.1 (IOVDD), U2.11 (IOVDD), U2.20 (IOVDD), U2.30 (IOVDD), U2.38 (IOVDD), U2.45 (IOVDD), U2.49 (VREG_VIN), U2.53 (USB_OTP_VDD), U2.54 (QSPI_IOVDD), U4.8 (VDD), U5.8 (VDD)
4: J3.6, J3.6B (6), U2.7 (GPIO4)
5: J3.5, J3.5B (5), U2.8 (GPIO5)
6: J3.4, J3.4B (4), U2.9 (GPIO6)
7: J3.3, J3.3B (3), U2.10 (GPIO7)
8/TX1: J3.2, J3.2B (2), U2.12 (GPIO8)
9/RX1: J3.1, J3.1B (1), U2.13 (GPIO9)
16/SDA: J2.3, R5.1, U2.27 (GPIO16)
17/SCL: J2.4, R7.1, U2.28 (GPIO17)
20/SPI_POCI: J4.10, J4.10B (10), U2.32 (GPIO20)
21/SPI_!CS!: J4.12, J4.12B (12), U2.33 (GPIO21)
22/SPI_SCK: J4.9, J4.9B (9), U2.34 (GPIO22)
23/SPI_PICO: J4.11, J4.11B (11), U2.35 (GPIO23)
25/WS2812-DI: U2.37 (GPIO25), U3.DI
!RESET!: J4.3, J4.3B (3), R2.1, S1.3 (2), S1.4 (2), U2.26 (RUN)
A0: J4.8, J4.8B (8), U2.40 (GPIO26/ADC0)
A1: J4.7, J4.7B (7), U2.41 (GPIO27/ADC1)
A2: J4.6, J4.6B (6), U2.42 (GPIO28/ADC2)
A3: J4.5, J4.5B (5), U2.43 (GPIO29/ADC3)
BOOT: R15.2, S2.3 (2), S2.4 (2), TP4.1
FLASH_!CS!/BOOT: R15.1, R16.1, U2.60 (QSPI_!CS!), U4.1 (!CS!)
GND: C1.2, C2.2, C3.2, C7.1, C8.1, C9.2, C11.1, C12.2, C13.1, C14.2, C15.2, C16.2, C17.2, C18.2, C19.2, C20.2, C21.2, C22.2, C23.2, C29.2, J2.1, J3.9, J3.9B (9), J3.10, J3.10B (10), J4.2, J4.2B (2), J5.GND, J5.GND2 (GND), JP14.GND (4), PWR.1, R1.1, R3.1, S1.1, S1.2 (1), S2.1, S2.2 (1), SHLD.2, U1.2 (GND), U2.47 (VREG_GND), U2.EPAD (GND), U3.GND, U4.4 (GND), U5.4 (VSS), U5.9 (VSS)
unnamed: L1.2, U2.48 (VREG_LX)
unnamed: LED1.C, PWR.2
unnamed: J5.A5 (CC1), R3.2
unnamed: J5.B5 (CC2), R1.2
unnamed: LED1.A, R11.1
PSRAM_!CS!: R4.1, U2.31 (GPIO19), U5.1 (!CE!)
QSPI-0: U2.57 (QSPI_SD0), U4.5 (D0/DI), U5.5 (SI/SIO0)
QSPI-1: U2.59 (QSPI_SD1), U4.2 (D1/DO), U5.2 (SO/SIO1)
QSPI-2: U2.58 (QSPI_SD2), U4.3 (D2/!WP!), U5.3 (SIO2)
QSPI-3: U2.55 (QSPI_SD3), U4.7 (D3/!HOLD!), U5.7 (SIO3)
QSPI-CLK: U2.56 (QSPI_SCLK), U4.6 (CLK), U5.6 (SCLK)
RAW: C7.2, D2.C, J4.1, J4.1B (1), U1.1 (IN), U1.3 (EN), U3.VCC
RP_D1+: R13.2, U2.52 (USB_D+)
RP_D1-: R12.2, U2.51 (USB_D-)
RP_D+: J5.A6 (D+), J5.B6 (D+), JP14.D+ (3), R13.1
RP_D-: J5.A7 (D-), J5.B7 (D-), JP14.D- (2), R12.1
SHLD: J5.SHLD1 (SHLD), J5.SHLD2 (SHLD), J5.SHLD3 (SHLD), J5.SHLD4 (SHLD), SHLD.1
SWDCK: TP1.1, U2.24 (SWCLK)
SWDIO: TP2.1, U2.25 (SWDIO)
USB_RAW: D2.A, F1.2
VDDA: C22.1, R14.1, U2.44 (ADC_IOVDD), U2.46 (VREG_AVDD)
V_USB: F1.1, J5.VBUS1 (VBUS), J5.VBUS2 (VBUS), JP14.VBUS (1)
WS2812-DO: TP3.1, U3.DO
X1A: R10.2, U2.22 (XOUT)
X1B: C11.2, R10.1, Y1.P1 (1)
X2: C13.2, U2.21 (XIN), Y1.P3 (2)

Notes on the sheet:
Max Voltage Input: 5.5V
Max Current Output: 600mA
Raspberry Pi RP2350
16MB Flash - W25Q128
Disable flash boot (forces USB boot)
Status LED
Power Select and 3.3V Regulator - RT9080
USB-C Connector and USB Pads
Castellated Headers
Boot / Reset Buttons
Max Voltage on RAW: 5.3V V-Reg can handle up to 5.5V but WS2812 max is 5.3V
Based on design by: Nathan Seidle
Cut SHLD jumper to disconnect USB shield from GND
Cut PWR jumper (labelled "P" in silkscreen) to disconnect power LED
Power LED
Qwiic Connector and I2C Pullups
Test Points
8MB PSRAM

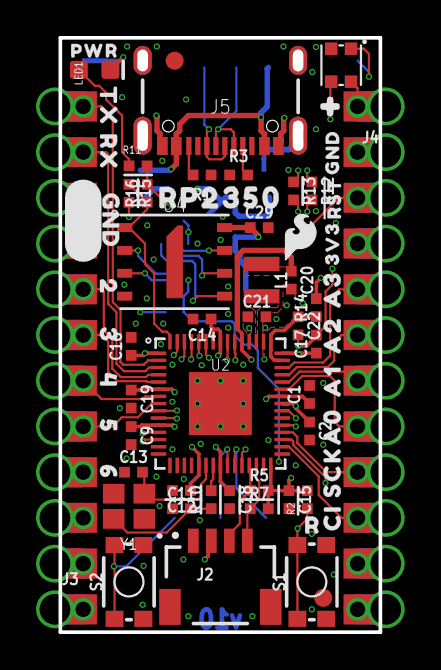
[picture p32: board SparkFun_ProMicro_RP2350.brd from above]

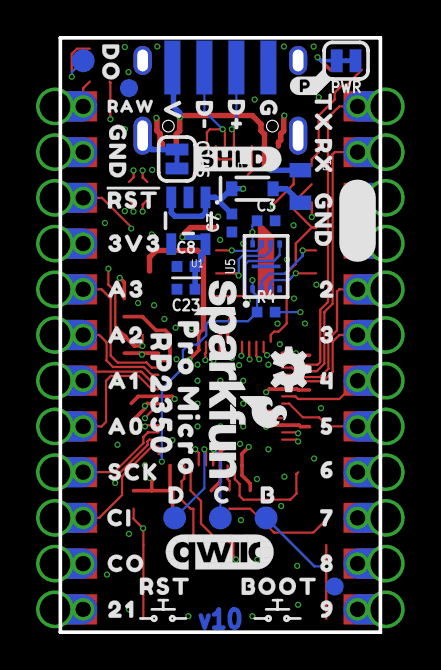
[picture p33: board SparkFun_ProMicro_RP2350.brd from below]

Board: 4 copper layers, 17.8 x 33.0 mm, 124 parts (58 on the bottom side), 53 nets.

Other parts of the board:
U$1, U$11: A00
U$2: GND_0
U$4: PRO_MICRO0
U$5: #0
U$6: 70
U$7: 81
U$8: 92
U$9, U$64: CI4
U$10, U$67: SCK3
U$12, U$20: A10
U$13, U$33: A21
U$14, U$39: A32
U$15, U$22, U$74: GND2
U$16: 3V3_0
U$17: RAW0
U$18: C0
U$19, U$76: TX0
U$21, U$75: RX1
U$23, U$53: 20
U$24, U$54: 31
U$25, U$55: 42
U$26, U$56: 53
U$27, U$57: 64
U$28: D#1
U$29: D#2
U$30: G0
U$31: V3
U$32: 210
U$34: #RST#0
U$35: D1
U$36: #P#0
U$37: R0
U$38: B0
U$40: DO0
U$41: BOOT0
U$42, U$45: RP23500
U$43: #SHLD#0
U$44: RST0
U$66: CO5
U$68: #RST#1
U$69: 3V30
U$73: PWR0
