sparkfun/SparkFun_Pro_Micro_RP2350/Production/SparkFun_ProMicro_RP2350-Panel.brd

## EAGLE design Production/SparkFun_ProMicro_RP2350-Panel.brd (2024-06-06)

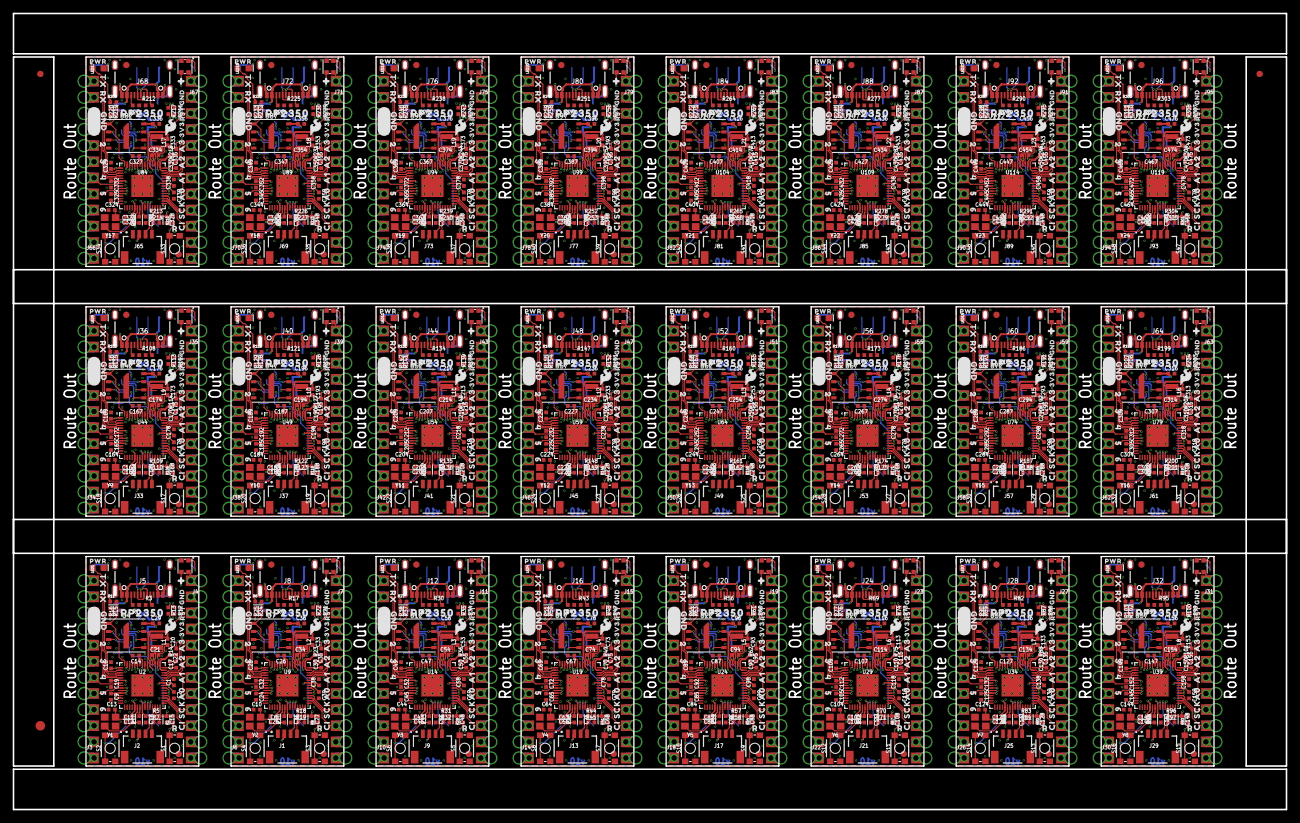
[picture p34: board SparkFun_ProMicro_RP2350-Panel.brd from above]

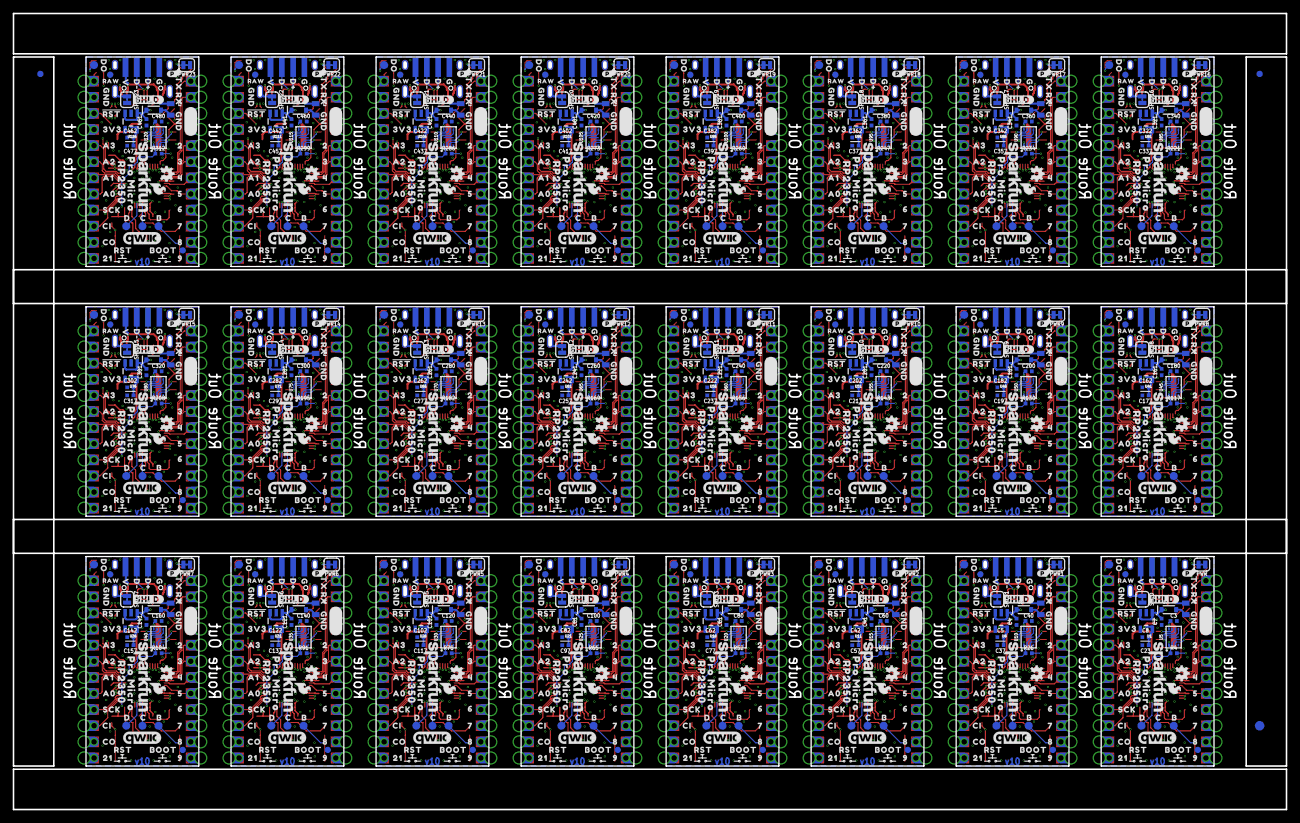
[picture p35: board SparkFun_ProMicro_RP2350-Panel.brd from below]

Board: 4 copper layers, 200.7 x 125.5 mm, 2934 parts (1395 on the bottom side), 1272 nets.

Parts:
C1, C2, C3, C9, C12, C14, C15, C16, C17, C18, C19, C24, C25, C26, C27, C28, C29, C30, C31, C32, C36, C38, C39, C40, C45, C46, C47, C48, C49, C50, C51, C52, C56, C58, C59, C60, C65, C66, C67, C68, C69, C70, C71, C72, C76, C78, C79, C80, C85, C86, C87, C88, C89, C90, C91, C92, C96, C98, C99, C100, C105, C106, C107, C108, C109, C110, C111, C112, C116, C118, C119, C120, C125, C126, C127, C128, C129, C130, C131, C132, C136, C138, C139, C140, C145, C146, C147, C148, C149, C150, C151, C152, C156, C158, C159, C160, C165, C166, C167, C168, C169, C170, C171, C172, C176, C178, C179, C180, C185, C186, C187, C188, C189, C190, C191, C192, C196, C198, C199, C200, C205, C206, C207, C208, C209, C210, C211, C212, C216, C218, C219, C220, C225, C226, C227, C228, C229, C230, C231, C232, C236, C238, C239, C240, C245, C246, C247, C248, C249, C250, C251, C252, C256, C258, C259, C260, C265, C266, C267, C268, C269, C270, C271, C272, C276, C278, C279, C280, C285, C286, C287, C288, C289, C290, C291, C292, C296, C298, C299, C300, C305, C306, C307, C308, C309, C310, C311, C312, C316, C318, C319, C320, C325, C326, C327, C328, C329, C330, C331, C332, C336, C338, C339, C340, C345, C346, C347, C348, C349, C350, C351, C352, C356, C358, C359, C360, C365, C366, C367, C368, C369, C370, C371, C372, C376, C378, C379, C380, C385, C386, C387, C388, C389, C390, C391, C392, C396, C398, C399, C400, C405, C406, C407, C408, C409, C410, C411, C412, C416, C418, C419, C420, C425, C426, C427, C428, C429, C430, C431, C432, C436, C438, C439, C440, C445, C446, C447, C448, C449, C450, C451, C452, C456, C458, C459, C460, C465, C466, C467, C468, C469, C470, C471, C472, C476, C478, C479, C480: 0.1uF; 0402-TIGHT
C4, C5, C7, C8, C20, C21, C33, C34, C41, C42, C53, C54, C61, C62, C73, C74, C81, C82, C93, C94, C101, C102, C113, C114, C121, C122, C133, C134, C141, C142, C153, C154, C161, C162, C173, C174, C181, C182, C193, C194, C201, C202, C213, C214, C221, C222, C233, C234, C241, C242, C253, C254, C261, C262, C273, C274, C281, C282, C293, C294, C301, C302, C313, C314, C321, C322, C333, C334, C341, C342, C353, C354, C361, C362, C373, C374, C381, C382, C393, C394, C401, C402, C413, C414, C421, C422, C433, C434, C441, C442, C453, C454, C461, C462, C473, C474: 10uF; 0402-TIGHT
C6, C10, C11, C13, C43, C44, C63, C64, C83, C84, C103, C104, C123, C124, C143, C144, C163, C164, C183, C184, C203, C204, C223, C224, C243, C244, C263, C264, C283, C284, C303, C304, C323, C324, C343, C344, C363, C364, C383, C384, C403, C404, C423, C424, C443, C444, C463, C464: 15pF; 0402-TIGHT
C22, C23, C35, C37, C55, C57, C75, C77, C95, C97, C115, C117, C135, C137, C155, C157, C175, C177, C195, C197, C215, C217, C235, C237, C255, C257, C275, C277, C295, C297, C315, C317, C335, C337, C355, C357, C375, C377, C395, C397, C415, C417, C435, C437, C455, C457, C475, C477: 2.2uF; 0402-TIGHT
D1, D2, D3, D4, D5, D6, D7, D8, D9, D10, D11, D12, D13, D14, D15, D16, D17, D18, D19, D20, D21, D22, D23, D24: 3A/10V/280mV; SOD-323
E$1, E$2, E$3, E$4: FIDUCIAL-1X2
E$5, E$6: FIDUCIAL-1.5X3
F1, F2, F3, F4, F5, F6, F7, F8, F9, F10, F11, F12, F13, F14, F15, F16, F17, F18, F19, F20, F21, F22, F23, F24: 6V 0.5A; 0805
J1, J2, J9, J13, J17, J21, J25, J29, J33, J37, J41, J45, J49, J53, J57, J61, J65, J69, J73, J77, J81, J85, J89, J93: QWIIC_RIGHT_ANGLE; JST04_1MM_RA
J3, J4, J6, J7, J10, J11, J14, J15, J18, J19, J22, J23, J26, J27, J30, J31, J34, J35, J38, J39, J42, J43, J46, J47, J50, J51, J54, J55, J58, J59, J62, J63, J66, J67, J70, J71, J74, J75, J78, J79, J82, J83, J86, J87, J90, J91, J94, J95: 1X12_CASTELLATED
J5, J8, J12, J16, J20, J24, J28, J32, J36, J40, J44, J48, J52, J56, J60, J64, J68, J72, J76, J80, J84, J88, J92, J96: USB Female Type C Connector; USB-C-16P_4LAYER-PADS
JP1, JP2, JP3, JP4, JP5, JP6, JP8, JP9, JP10, JP11, JP13, JP15, JP16, JP17, JP19, JP20, JP21, JP22, JP24, JP25, JP26, JP27, JP29, JP30, JP31, JP32, JP34, JP35, JP36, JP37, JP39, JP40, JP41, JP42, JP44, JP45, JP46, JP47, JP49, JP50, JP51, JP52, JP54, JP55, JP56, JP57, JP59, JP60, JP61, JP62, JP64, JP65, JP66, JP67, JP69, JP70, JP71, JP72, JP74, JP75, JP76, JP77, JP79, JP80, JP81, JP82, JP84, JP85, JP86, JP87, JP89, JP90, JP91, JP92, JP94, JP95, JP96, JP97, JP99, JP100, JP101, JP102, JP104, JP105, JP106, JP107, JP109, JP110, JP111, JP112, JP114, JP115, JP116, JP117, JP119, JP120: FIDUCIAL1X2; FIDUCIAL-1X2
JP7, JP12, JP14, JP18, JP23, JP28, JP33, JP38, JP43, JP48, JP53, JP58, JP63, JP68, JP73, JP78, JP83, JP88, JP93, JP98, JP103, JP108, JP113, JP118: USB_SOLDER_PADS; USB-SOLDER-PADS
L1, L2, L3, L4, L5, L6, L7, L8, L9, L10, L11, L12, L13, L14, L15, L16, L17, L18, L19, L20, L21, L22, L23, L24: 4.7μH; 1008(2520)
LED1, LED2, LED3, LED4, LED5, LED6, LED7, LED8, LED9, LED10, LED11, LED12, LED13, LED14, LED15, LED16, LED17, LED18, LED19, LED20, LED21, LED22, LED23, LED24: Red; LED-0603
LOGO1, LOGO2, LOGO7, LOGO10, LOGO13, LOGO16, LOGO19, LOGO22, LOGO25, LOGO28, LOGO31, LOGO34, LOGO37, LOGO40, LOGO43, LOGO46, LOGO49, LOGO52, LOGO55, LOGO58, LOGO61, LOGO64, LOGO67, LOGO70: SFE_LOGO_NAME_FLAME.1_INCH; SFE_LOGO_NAME_FLAME_.1
LOGO3, LOGO5, LOGO8, LOGO11, LOGO14, LOGO17, LOGO20, LOGO23, LOGO26, LOGO29, LOGO32, LOGO35, LOGO38, LOGO41, LOGO44, LOGO47, LOGO50, LOGO53, LOGO56, LOGO59, LOGO62, LOGO65, LOGO68, LOGO71: QWIIC_LOGO_6MM; QWIIC_6MM
LOGO4, LOGO6, LOGO9, LOGO12, LOGO15, LOGO18, LOGO21, LOGO24, LOGO27, LOGO30, LOGO33, LOGO36, LOGO39, LOGO42, LOGO45, LOGO48, LOGO51, LOGO54, LOGO57, LOGO60, LOGO63, LOGO66, LOGO69, LOGO72: SFE_LOGO_FLAME.1_INCH; SFE_LOGO_FLAME_.1
PWR, PWR1, PWR2, PWR3, PWR4, PWR5, PWR6, PWR7, PWR8, PWR9, PWR10, PWR11, PWR12, PWR13, PWR14, PWR15, PWR16, PWR17, PWR18, PWR19, PWR20, PWR21, PWR22, PWR23: JUMPER-SMT_2_NC_TRACE_SILK; SMT-JUMPER_2_NC_TRACE_SILK
R1, R3, R9, R17, R29, R30, R42, R43, R55, R56, R68, R69, R81, R82, R94, R95, R107, R108, R120, R121, R133, R134, R146, R147, R159, R160, R172, R173, R185, R186, R198, R199, R211, R212, R224, R225, R237, R238, R250, R251, R263, R264, R276, R277, R289, R290, R302, R303: 5.1k; 0402-TIGHT
R2, R4, R8, R16, R25, R26, R28, R38, R39, R41, R51, R52, R54, R64, R65, R67, R77, R78, R80, R90, R91, R93, R103, R104, R106, R116, R117, R119, R129, R130, R132, R142, R143, R145, R155, R156, R158, R168, R169, R171, R181, R182, R184, R194, R195, R197, R207, R208, R210, R220, R221, R223, R233, R234, R236, R246, R247, R249, R259, R260, R262, R272, R273, R275, R285, R286, R288, R298, R299, R301, R311, R312: 10k; 0402-TIGHT
R5, R7, R18, R19, R31, R32, R44, R45, R57, R58, R70, R71, R83, R84, R96, R97, R109, R110, R122, R123, R135, R136, R148, R149, R161, R162, R174, R175, R187, R188, R200, R201, R213, R214, R226, R227, R239, R240, R252, R253, R265, R266, R278, R279, R291, R292, R304, R305: 2.2k; 0402-TIGHT
R6, R11, R27, R40, R53, R66, R79, R92, R105, R118, R131, R144, R157, R170, R183, R196, R209, R222, R235, R248, R261, R274, R287, R300: 4.7k; 0402-TIGHT
R10, R15, R20, R24, R33, R37, R46, R50, R59, R63, R72, R76, R85, R89, R98, R102, R111, R115, R124, R128, R137, R141, R150, R154, R163, R167, R176, R180, R189, R193, R202, R206, R215, R219, R228, R232, R241, R245, R254, R258, R267, R271, R280, R284, R293, R297, R306, R310: 1k; 0402-TIGHT
R12, R13, R21, R22, R34, R35, R47, R48, R60, R61, R73, R74, R86, R87, R99, R100, R112, R113, R125, R126, R138, R139, R151, R152, R164, R165, R177, R178, R190, R191, R203, R204, R216, R217, R229, R230, R242, R243, R255, R256, R268, R269, R281, R282, R294, R295, R307, R308: 27; 0402-TIGHT
R14, R23, R36, R49, R62, R75, R88, R101, R114, R127, R140, R153, R166, R179, R192, R205, R218, R231, R244, R257, R270, R283, R296, R309: 10Ω; 0402-TIGHT
S1, S3, S5, S7, S9, S11, S13, S15, S17, S19, S21, S23, S25, S27, S29, S31, S33, S35, S37, S39, S41, S43, S45, S47: Reset; TACTILE_SWITCH_SMD_4.6X2.8MM
S2, S4, S6, S8, S10, S12, S14, S16, S18, S20, S22, S24, S26, S28, S30, S32, S34, S36, S38, S40, S42, S44, S46, S48: Boot; TACTILE_SWITCH_SMD_4.6X2.8MM
SHLD, SHLD1, SHLD2, SHLD3, SHLD4, SHLD5, SHLD6, SHLD7, SHLD8, SHLD9, SHLD10, SHLD11, SHLD12, SHLD13, SHLD14, SHLD15, SHLD16, SHLD17, SHLD18, SHLD19, SHLD20, SHLD21, SHLD22, SHLD23: JUMPER-SMT_2_NC_TRACE_SILK; SMT-JUMPER_2_NC_TRACE_SILK
TP1, TP2, TP3, TP4, TP5, TP6, TP7, TP8, TP9, TP10, TP11, TP12, TP13, TP14, TP15, TP16, TP17, TP18, TP19, TP20, TP21, TP22, TP23, TP24, TP25, TP26, TP27, TP28, TP29, TP30, TP31, TP32, TP33, TP34, TP35, TP36, TP37, TP38, TP39, TP40, TP41, TP42, TP43, TP44, TP45, TP46, TP47, TP48, TP49, TP50, TP51, TP52, TP53, TP54, TP55, TP56, TP57, TP58, TP59, TP60, TP61, TP62, TP63, TP64, TP65, TP66, TP67, TP68, TP69, TP70, TP71, TP72, TP73, TP74, TP75, TP76, TP77, TP78, TP79, TP80, TP81, TP82, TP83, TP84, TP85, TP86, TP87, TP88, TP89, TP90, TP91, TP92, TP93, TP94, TP95, TP96: TEST-POINT3X5; PAD.03X.05
U1, U6, U11, U16, U21, U26, U31, U36, U41, U46, U51, U56, U61, U66, U71, U76, U81, U86, U91, U96, U101, U106, U111, U116: RT9080-33GJ5; SOT23-5
U2, U9, U14, U19, U24, U29, U34, U39, U44, U49, U54, U59, U64, U69, U74, U79, U84, U89, U94, U99, U104, U109, U114, U119: RP2350A
U3, U8, U13, U18, U23, U28, U33, U38, U43, U48, U53, U58, U63, U68, U73, U78, U83, U88, U93, U98, U103, U108, U113, U118: WS2812_2020; WS2812-2020
U4, U7, U12, U17, U22, U27, U32, U37, U42, U47, U52, U57, U62, U67, U72, U77, U82, U87, U92, U97, U102, U107, U112, U117: W25QXX128MBIT; WSON-8-6X5-SKINNY_CENTERPAD
U5, U10, U15, U20, U25, U30, U35, U40, U45, U50, U55, U60, U65, U70, U75, U80, U85, U90, U95, U100, U105, U110, U115, U120: APS6404L-3SQR-ZR
U$1, U$11, U$47, U$85, U$120, U$144, U$179, U$203, U$238, U$262, U$297, U$321, U$356, U$380, U$415, U$439, U$474, U$498, U$533, U$557, U$592, U$616, U$651, U$675, U$710, U$734, U$769, U$793, U$828, U$852, U$887, U$911, U$946, U$970, U$1005, U$1029, U$1064, U$1088, U$1123, U$1147, U$1182, U$1206, U$1241, U$1265, U$1300, U$1324, U$1359, U$1383: A00
U$2, U$79, U$138, U$197, U$256, U$315, U$374, U$433, U$492, U$551, U$610, U$669, U$728, U$787, U$846, U$905, U$964, U$1023, U$1082, U$1141, U$1200, U$1259, U$1318, U$1377: GND_0
U$3, U$46, U$119, U$178, U$237, U$296, U$355, U$414, U$473, U$532, U$591, U$650, U$709, U$768, U$827, U$886, U$945, U$1004, U$1063, U$1122, U$1181, U$1240, U$1299, U$1358: OSHW-LOGOMINI; OSHW-LOGO-MINI
U$4, U$108, U$167, U$226, U$285, U$344, U$403, U$462, U$521, U$580, U$639, U$698, U$757, U$816, U$875, U$934, U$993, U$1052, U$1111, U$1170, U$1229, U$1288, U$1347, U$1406: PRO_MICRO0
U$5, U$107, U$166, U$225, U$284, U$343, U$402, U$461, U$520, U$579, U$638, U$697, U$756, U$815, U$874, U$933, U$992, U$1051, U$1110, U$1169, U$1228, U$1287, U$1346, U$1405: #0
U$6, U$80, U$139, U$198, U$257, U$316, U$375, U$434, U$493, U$552, U$611, U$670, U$729, U$788, U$847, U$906, U$965, U$1024, U$1083, U$1142, U$1201, U$1260, U$1319, U$1378: 70
U$7, U$81, U$140, U$199, U$258, U$317, U$376, U$435, U$494, U$553, U$612, U$671, U$730, U$789, U$848, U$907, U$966, U$1025, U$1084, U$1143, U$1202, U$1261, U$1320, U$1379: 81
U$8, U$82, U$141, U$200, U$259, U$318, U$377, U$436, U$495, U$554, U$613, U$672, U$731, U$790, U$849, U$908, U$967, U$1026, U$1085, U$1144, U$1203, U$1262, U$1321, U$1380: 92
U$9, U$51, U$64, U$83, U$124, U$142, U$183, U$201, U$242, U$260, U$301, U$319, U$360, U$378, U$419, U$437, U$478, U$496, U$537, U$555, U$596, U$614, U$655, U$673, U$714, U$732, U$773, U$791, U$832, U$850, U$891, U$909, U$950, U$968, U$1009, U$1027, U$1068, U$1086, U$1127, U$1145, U$1186, U$1204, U$1245, U$1263, U$1304, U$1322, U$1363, U$1381: CI4
U$10, U$58, U$67, U$84, U$126, U$143, U$185, U$202, U$244, U$261, U$303, U$320, U$362, U$379, U$421, U$438, U$480, U$497, U$539, U$556, U$598, U$615, U$657, U$674, U$716, U$733, U$775, U$792, U$834, U$851, U$893, U$910, U$952, U$969, U$1011, U$1028, U$1070, U$1087, U$1129, U$1146, U$1188, U$1205, U$1247, U$1264, U$1306, U$1323, U$1365, U$1382: SCK3
U$12, U$20, U$48, U$86, U$121, U$145, U$180, U$204, U$239, U$263, U$298, U$322, U$357, U$381, U$416, U$440, U$475, U$499, U$534, U$558, U$593, U$617, U$652, U$676, U$711, U$735, U$770, U$794, U$829, U$853, U$888, U$912, U$947, U$971, U$1006, U$1030, U$1065, U$1089, U$1124, U$1148, U$1183, U$1207, U$1242, U$1266, U$1301, U$1325, U$1360, U$1384: A10
U$13, U$33, U$49, U$87, U$122, U$146, U$181, U$205, U$240, U$264, U$299, U$323, U$358, U$382, U$417, U$441, U$476, U$500, U$535, U$559, U$594, U$618, U$653, U$677, U$712, U$736, U$771, U$795, U$830, U$854, U$889, U$913, U$948, U$972, U$1007, U$1031, U$1066, U$1090, U$1125, U$1149, U$1184, U$1208, U$1243, U$1267, U$1302, U$1326, U$1361, U$1385: A21
U$14, U$39, U$50, U$88, U$123, U$147, U$182, U$206, U$241, U$265, U$300, U$324, U$359, U$383, U$418, U$442, U$477, U$501, U$536, U$560, U$595, U$619, U$654, U$678, U$713, U$737, U$772, U$796, U$831, U$855, U$890, U$914, U$949, U$973, U$1008, U$1032, U$1067, U$1091, U$1126, U$1150, U$1185, U$1209, U$1244, U$1268, U$1303, U$1327, U$1362, U$1386: A32
U$15, U$22, U$72, U$74, U$91, U$104, U$135, U$150, U$163, U$194, U$209, U$222, U$253, U$268, U$281, U$312, U$327, U$340, U$371, U$386, U$399, U$430, U$445, U$458, U$489, U$504, U$517, U$548, U$563, U$576, U$607, U$622, U$635, U$666, U$681, U$694, U$725, U$740, U$753, U$784, U$799, U$812, U$843, U$858, U$871, U$902, U$917, U$930, U$961, U$976, U$989, U$1020, U$1035, U$1048, U$1079, U$1094, U$1107, U$1138, U$1153, U$1166, U$1197, U$1212, U$1225, U$1256, U$1271, U$1284, U$1315, U$1330, U$1343, U$1374, U$1389, U$1402: GND2
U$16, U$103, U$162, U$221, U$280, U$339, U$398, U$457, U$516, U$575, U$634, U$693, U$752, U$811, U$870, U$929, U$988, U$1047, U$1106, U$1165, U$1224, U$1283, U$1342, U$1401: 3V3_0
U$17, U$105, U$164, U$223, U$282, U$341, U$400, U$459, U$518, U$577, U$636, U$695, U$754, U$813, U$872, U$931, U$990, U$1049, U$1108, U$1167, U$1226, U$1285, U$1344, U$1403: RAW0
U$18, U$109, U$168, U$227, U$286, U$345, U$404, U$463, U$522, U$581, U$640, U$699, U$758, U$817, U$876, U$935, U$994, U$1053, U$1112, U$1171, U$1230, U$1289, U$1348, U$1407: C0
U$19, U$76, U$78, U$89, U$137, U$148, U$196, U$207, U$255, U$266, U$314, U$325, U$373, U$384, U$432, U$443, U$491, U$502, U$550, U$561, U$609, U$620, U$668, U$679, U$727, U$738, U$786, U$797, U$845, U$856, U$904, U$915, U$963, U$974, U$1022, U$1033, U$1081, U$1092, U$1140, U$1151, U$1199, U$1210, U$1258, U$1269, U$1317, U$1328, U$1376, U$1387: TX0
U$21, U$75, U$77, U$90, U$136, U$149, U$195, U$208, U$254, U$267, U$313, U$326, U$372, U$385, U$431, U$444, U$490, U$503, U$549, U$562, U$608, U$621, U$667, U$680, U$726, U$739, U$785, U$798, U$844, U$857, U$903, U$916, U$962, U$975, U$1021, U$1034, U$1080, U$1093, U$1139, U$1152, U$1198, U$1211, U$1257, U$1270, U$1316, U$1329, U$1375, U$1388: RX1
U$23, U$53, U$59, U$92, U$127, U$151, U$186, U$210, U$245, U$269, U$304, U$328, U$363, U$387, U$422, U$446, U$481, U$505, U$540, U$564, U$599, U$623, U$658, U$682, U$717, U$741, U$776, U$800, U$835, U$859, U$894, U$918, U$953, U$977, U$1012, U$1036, U$1071, U$1095, U$1130, U$1154, U$1189, U$1213, U$1248, U$1272, U$1307, U$1331, U$1366, U$1390: 20
U$24, U$54, U$60, U$93, U$128, U$152, U$187, U$211, U$246, U$270, U$305, U$329, U$364, U$388, U$423, U$447, U$482, U$506, U$541, U$565, U$600, U$624, U$659, U$683, U$718, U$742, U$777, U$801, U$836, U$860, U$895, U$919, U$954, U$978, U$1013, U$1037, U$1072, U$1096, U$1131, U$1155, U$1190, U$1214, U$1249, U$1273, U$1308, U$1332, U$1367, U$1391: 31
U$25, U$55, U$61, U$94, U$129, U$153, U$188, U$212, U$247, U$271, U$306, U$330, U$365, U$389, U$424, U$448, U$483, U$507, U$542, U$566, U$601, U$625, U$660, U$684, U$719, U$743, U$778, U$802, U$837, U$861, U$896, U$920, U$955, U$979, U$1014, U$1038, U$1073, U$1097, U$1132, U$1156, U$1191, U$1215, U$1250, U$1274, U$1309, U$1333, U$1368, U$1392: 42
U$26, U$56, U$62, U$95, U$130, U$154, U$189, U$213, U$248, U$272, U$307, U$331, U$366, U$390, U$425, U$449, U$484, U$508, U$543, U$567, U$602, U$626, U$661, U$685, U$720, U$744, U$779, U$803, U$838, U$862, U$897, U$921, U$956, U$980, U$1015, U$1039, U$1074, U$1098, U$1133, U$1157, U$1192, U$1216, U$1251, U$1275, U$1310, U$1334, U$1369, U$1393: 53
U$27, U$57, U$63, U$96, U$131, U$155, U$190, U$214, U$249, U$273, U$308, U$332, U$367, U$391, U$426, U$450, U$485, U$509, U$544, U$568, U$603, U$627, U$662, U$686, U$721, U$745, U$780, U$804, U$839, U$863, U$898, U$922, U$957, U$981, U$1016, U$1040, U$1075, U$1099, U$1134, U$1158, U$1193, U$1217, U$1252, U$1276, U$1311, U$1335, U$1370, U$1394: 64
U$28, U$97, U$156, U$215, U$274, U$333, U$392, U$451, U$510, U$569, U$628, U$687, U$746, U$805, U$864, U$923, U$982, U$1041, U$1100, U$1159, U$1218, U$1277, U$1336, U$1395: D#1
U$29, U$98, U$157, U$216, U$275, U$334, U$393, U$452, U$511, U$570, U$629, U$688, U$747, U$806, U$865, U$924, U$983, U$1042, U$1101, U$1160, U$1219, U$1278, U$1337, U$1396: D#2
U$30, U$99, U$158, U$217, U$276, U$335, U$394, U$453, U$512, U$571, U$630, U$689, U$748, U$807, U$866, U$925, U$984, U$1043, U$1102, U$1161, U$1220, U$1279, U$1338, U$1397: G0
U$31, U$100, U$159, U$218, U$277, U$336, U$395, U$454, U$513, U$572, U$631, U$690, U$749, U$808, U$867, U$926, U$985, U$1044, U$1103, U$1162, U$1221, U$1280, U$1339, U$1398: V3
U$32, U$101, U$160, U$219, U$278, U$337, U$396, U$455, U$514, U$573, U$632, U$691, U$750, U$809, U$868, U$927, U$986, U$1045, U$1104, U$1163, U$1222, U$1281, U$1340, U$1399: 210
U$34, U$102, U$161, U$220, U$279, U$338, U$397, U$456, U$515, U$574, U$633, U$692, U$751, U$810, U$869, U$928, U$987, U$1046, U$1105, U$1164, U$1223, U$1282, U$1341, U$1400: #RST#0
U$35, U$110, U$169, U$228, U$287, U$346, U$405, U$464, U$523, U$582, U$641, U$700, U$759, U$818, U$877, U$936, U$995, U$1054, U$1113, U$1172, U$1231, U$1290, U$1349, U$1408: D1
U$36, U$115, U$174, U$233, U$292, U$351, U$410, U$469, U$528, U$587, U$646, U$705, U$764, U$823, U$882, U$941, U$1000, U$1059, U$1118, U$1177, U$1236, U$1295, U$1354, U$1413: #P#0
U$37, U$106, U$165, U$224, U$283, U$342, U$401, U$460, U$519, U$578, U$637, U$696, U$755, U$814, U$873, U$932, U$991, U$1050, U$1109, U$1168, U$1227, U$1286, U$1345, U$1404: R0
U$38, U$113, U$172, U$231, U$290, U$349, U$408, U$467, U$526, U$585, U$644, U$703, U$762, U$821, U$880, U$939, U$998, U$1057, U$1116, U$1175, U$1234, U$1293, U$1352, U$1411: B0
U$40, U$111, U$170, U$229, U$288, U$347, U$406, U$465, U$524, U$583, U$642, U$701, U$760, U$819, U$878, U$937, U$996, U$1055, U$1114, U$1173, U$1232, U$1291, U$1350, U$1409: DO0
U$41, U$116, U$175, U$234, U$293, U$352, U$411, U$470, U$529, U$588, U$647, U$706, U$765, U$824, U$883, U$942, U$1001, U$1060, U$1119, U$1178, U$1237, U$1296, U$1355, U$1414: BOOT0
U$42, U$45, U$112, U$118, U$171, U$177, U$230, U$236, U$289, U$295, U$348, U$354, U$407, U$413, U$466, U$472, U$525, U$531, U$584, U$590, U$643, U$649, U$702, U$708, U$761, U$767, U$820, U$826, U$879, U$885, U$938, U$944, U$997, U$1003, U$1056, U$1062, U$1115, U$1121, U$1174, U$1180, U$1233, U$1239, U$1292, U$1298, U$1351, U$1357, U$1410, U$1416: RP23500
U$43, U$114, U$173, U$232, U$291, U$350, U$409, U$468, U$527, U$586, U$645, U$704, U$763, U$822, U$881, U$940, U$999, U$1058, U$1117, U$1176, U$1235, U$1294, U$1353, U$1412: #SHLD#0
U$44, U$117, U$176, U$235, U$294, U$353, U$412, U$471, U$530, U$589, U$648, U$707, U$766, U$825, U$884, U$943, U$1002, U$1061, U$1120, U$1179, U$1238, U$1297, U$1356, U$1415: RST0
U$52, U$66, U$125, U$184, U$243, U$302, U$361, U$420, U$479, U$538, U$597, U$656, U$715, U$774, U$833, U$892, U$951, U$1010, U$1069, U$1128, U$1187, U$1246, U$1305, U$1364: CO5
U$65, U$68, U$132, U$191, U$250, U$309, U$368, U$427, U$486, U$545, U$604, U$663, U$722, U$781, U$840, U$899, U$958, U$1017, U$1076, U$1135, U$1194, U$1253, U$1312, U$1371: #RST#1
U$69, U$70, U$133, U$192, U$251, U$310, U$369, U$428, U$487, U$546, U$605, U$664, U$723, U$782, U$841, U$900, U$959, U$1018, U$1077, U$1136, U$1195, U$1254, U$1313, U$1372: 3V30
U$71, U$73, U$134, U$193, U$252, U$311, U$370, U$429, U$488, U$547, U$606, U$665, U$724, U$783, U$842, U$901, U$960, U$1019, U$1078, U$1137, U$1196, U$1255, U$1314, U$1373: PWR0
Y1, Y2, Y3, Y4, Y5, Y6, Y7, Y8, Y9, Y10, Y11, Y12, Y13, Y14, Y15, Y16, Y17, Y18, Y19, Y20, Y21, Y22, Y23, Y24: 12MHz; CRYSTAL-SMD-2X2.5MM

Connections:
0/TX0: J3.12, J3.12B, U2.2
0/TX1: J6.12, J6.12B, U9.2
0/TX2: J10.12, J10.12B, U14.2
0/TX3: J14.12, J14.12B, U19.2
0/TX4: J18.12, J18.12B, U24.2
0/TX5: J22.12, J22.12B, U29.2
0/TX6: J26.12, J26.12B, U34.2
0/TX7: J30.12, J30.12B, U39.2
0/TX8: J34.12, J34.12B, U44.2
0/TX9: J38.12, J38.12B, U49.2
0/TX10: J42.12, J42.12B, U54.2
0/TX11: J46.12, J46.12B, U59.2
0/TX12: J50.12, J50.12B, U64.2
0/TX13: J54.12, J54.12B, U69.2
0/TX14: J58.12, J58.12B, U74.2
0/TX15: J62.12, J62.12B, U79.2
0/TX16: J66.12, J66.12B, U84.2
0/TX17: J70.12, J70.12B, U89.2
0/TX18: J74.12, J74.12B, U94.2
0/TX19: J78.12, J78.12B, U99.2
0/TX20: J82.12, J82.12B, U104.2
0/TX21: J86.12, J86.12B, U109.2
0/TX22: J90.12, J90.12B, U114.2
0/TX23: J94.12, J94.12B, U119.2
1: J6.5, J6.5B, U9.8
1.1V: C1.1, C18.1, C19.1, C20.1, L1.1, U2.6, U2.23, U2.39, U2.50
1.1V1: C31.1, C32.1, C33.1, C38.1, L2.1, U9.6, U9.23, U9.39, U9.50
1.1V2: C51.1, C52.1, C53.1, C58.1, L3.1, U14.6, U14.23, U14.39, U14.50
1.1V3: C71.1, C72.1, C73.1, C78.1, L4.1, U19.6, U19.23, U19.39, U19.50
1.1V4: C91.1, C92.1, C93.1, C98.1, L5.1, U24.6, U24.23, U24.39, U24.50
1.1V5: C111.1, C112.1, C113.1, C118.1, L6.1, U29.6, U29.23, U29.39, U29.50
1.1V6: C131.1, C132.1, C133.1, C138.1, L7.1, U34.6, U34.23, U34.39, U34.50
1.1V7: C151.1, C152.1, C153.1, C158.1, L8.1, U39.6, U39.23, U39.39, U39.50
1.1V8: C171.1, C172.1, C173.1, C178.1, L9.1, U44.6, U44.23, U44.39, U44.50
1.1V9: C191.1, C192.1, C193.1, C198.1, L10.1, U49.6, U49.23, U49.39, U49.50
1.1V10: C211.1, C212.1, C213.1, C218.1, L11.1, U54.6, U54.23, U54.39, U54.50
1.1V11: C231.1, C232.1, C233.1, C238.1, L12.1, U59.6, U59.23, U59.39, U59.50
1.1V12: C251.1, C252.1, C253.1, C258.1, L13.1, U64.6, U64.23, U64.39, U64.50
1.1V13: C271.1, C272.1, C273.1, C278.1, L14.1, U69.6, U69.23, U69.39, U69.50
1.1V14: C291.1, C292.1, C293.1, C298.1, L15.1, U74.6, U74.23, U74.39, U74.50
1.1V15: C311.1, C312.1, C313.1, C318.1, L16.1, U79.6, U79.23, U79.39, U79.50
1.1V16: C331.1, C332.1, C333.1, C338.1, L17.1, U84.6, U84.23, U84.39, U84.50
1.1V17: C351.1, C352.1, C353.1, C358.1, L18.1, U89.6, U89.23, U89.39, U89.50
1.1V18: C371.1, C372.1, C373.1, C378.1, L19.1, U94.6, U94.23, U94.39, U94.50
1.1V19: C391.1, C392.1, C393.1, C398.1, L20.1, U99.6, U99.23, U99.39, U99.50
1.1V20: C411.1, C412.1, C413.1, C418.1, L21.1, U104.6, U104.23, U104.39, U104.50
1.1V21: C431.1, C432.1, C433.1, C438.1, L22.1, U109.6, U109.23, U109.39, U109.50
1.1V22: C451.1, C452.1, C453.1, C458.1, L23.1, U114.6, U114.23, U114.39, U114.50
1.1V23: C471.1, C472.1, C473.1, C478.1, L24.1, U119.6, U119.23, U119.39, U119.50
1/RX0: J3.11, J3.11B, U2.3
1/RX1: J6.11, J6.11B, U9.3
1/RX2: J10.11, J10.11B, U14.3
1/RX3: J14.11, J14.11B, U19.3
1/RX4: J18.11, J18.11B, U24.3
1/RX5: J22.11, J22.11B, U29.3
1/RX6: J26.11, J26.11B, U34.3
1/RX7: J30.11, J30.11B, U39.3
1/RX8: J34.11, J34.11B, U44.3
1/RX9: J38.11, J38.11B, U49.3
1/RX10: J42.11, J42.11B, U54.3
1/RX11: J46.11, J46.11B, U59.3
1/RX12: J50.11, J50.11B, U64.3
1/RX13: J54.11, J54.11B, U69.3
1/RX14: J58.11, J58.11B, U74.3
1/RX15: J62.11, J62.11B, U79.3
1/RX16: J66.11, J66.11B, U84.3
1/RX17: J70.11, J70.11B, U89.3
1/RX18: J74.11, J74.11B, U94.3
1/RX19: J78.11, J78.11B, U99.3
1/RX20: J82.11, J82.11B, U104.3
1/RX21: J86.11, J86.11B, U109.3
1/RX22: J90.11, J90.11B, U114.3
1/RX23: J94.11, J94.11B, U119.3
2: J3.8, J3.8B, U2.4
3: J3.7, J3.7B, U2.5
3.3V: C2.1, C3.1, C8.2, C9.1, C12.1, C14.1, C15.1, C16.1, C17.1, C21.1, C23.1, C29.1, J2.2, J4.4, J4.4B, R2.2, R4.2, R5.2, R7.2, R11.2, R14.2, R16.2, U1.5, U2.1, U2.11, U2.20, U2.30, U2.38, U2.45, U2.49, U2.53, U2.54, U4.8, U5.8
3.3V1: C5.2, C24.1, C25.1, C26.1, C27.1, C28.1, C30.1, C34.1, C36.1, C37.1, C39.1, C40.1, J1.2, J7.4, J7.4B, R6.2, R8.2, R18.2, R19.2, R23.2, R25.2, R26.2, U6.5, U7.8, U9.1, U9.11, U9.20, U9.30, U9.38, U9.45, U9.49, U9.53, U9.54, U10.8
3.3V2: C42.2, C45.1, C46.1, C47.1, C48.1, C49.1, C50.1, C54.1, C56.1, C57.1, C59.1, C60.1, J9.2, J11.4, J11.4B, R27.2, R28.2, R31.2, R32.2, R36.2, R38.2, R39.2, U11.5, U12.8, U14.1, U14.11, U14.20, U14.30, U14.38, U14.45, U14.49, U14.53, U14.54, U15.8
3.3V3: C62.2, C65.1, C66.1, C67.1, C68.1, C69.1, C70.1, C74.1, C76.1, C77.1, C79.1, C80.1, J13.2, J15.4, J15.4B, R40.2, R41.2, R44.2, R45.2, R49.2, R51.2, R52.2, U16.5, U17.8, U19.1, U19.11, U19.20, U19.30, U19.38, U19.45, U19.49, U19.53, U19.54, U20.8
3.3V4: C82.2, C85.1, C86.1, C87.1, C88.1, C89.1, C90.1, C94.1, C96.1, C97.1, C99.1, C100.1, J17.2, J19.4, J19.4B, R53.2, R54.2, R57.2, R58.2, R62.2, R64.2, R65.2, U21.5, U22.8, U24.1, U24.11, U24.20, U24.30, U24.38, U24.45, U24.49, U24.53, U24.54, U25.8
3.3V5: C102.2, C105.1, C106.1, C107.1, C108.1, C109.1, C110.1, C114.1, C116.1, C117.1, C119.1, C120.1, J21.2, J23.4, J23.4B, R66.2, R67.2, R70.2, R71.2, R75.2, R77.2, R78.2, U26.5, U27.8, U29.1, U29.11, U29.20, U29.30, U29.38, U29.45, U29.49, U29.53, U29.54, U30.8
3.3V6: C122.2, C125.1, C126.1, C127.1, C128.1, C129.1, C130.1, C134.1, C136.1, C137.1, C139.1, C140.1, J25.2, J27.4, J27.4B, R79.2, R80.2, R83.2, R84.2, R88.2, R90.2, R91.2, U31.5, U32.8, U34.1, U34.11, U34.20, U34.30, U34.38, U34.45, U34.49, U34.53, U34.54, U35.8
3.3V7: C142.2, C145.1, C146.1, C147.1, C148.1, C149.1, C150.1, C154.1, C156.1, C157.1, C159.1, C160.1, J29.2, J31.4, J31.4B, R92.2, R93.2, R96.2, R97.2, R101.2, R103.2, R104.2, U36.5, U37.8, U39.1, U39.11, U39.20, U39.30, U39.38, U39.45, U39.49, U39.53, U39.54, U40.8
3.3V8: C162.2, C165.1, C166.1, C167.1, C168.1, C169.1, C170.1, C174.1, C176.1, C177.1, C179.1, C180.1, J33.2, J35.4, J35.4B, R105.2, R106.2, R109.2, R110.2, R114.2, R116.2, R117.2, U41.5, U42.8, U44.1, U44.11, U44.20, U44.30, U44.38, U44.45, U44.49, U44.53, U44.54, U45.8
3.3V9: C182.2, C185.1, C186.1, C187.1, C188.1, C189.1, C190.1, C194.1, C196.1, C197.1, C199.1, C200.1, J37.2, J39.4, J39.4B, R118.2, R119.2, R122.2, R123.2, R127.2, R129.2, R130.2, U46.5, U47.8, U49.1, U49.11, U49.20, U49.30, U49.38, U49.45, U49.49, U49.53, U49.54, U50.8
3.3V10: C202.2, C205.1, C206.1, C207.1, C208.1, C209.1, C210.1, C214.1, C216.1, C217.1, C219.1, C220.1, J41.2, J43.4, J43.4B, R131.2, R132.2, R135.2, R136.2, R140.2, R142.2, R143.2, U51.5, U52.8, U54.1, U54.11, U54.20, U54.30, U54.38, U54.45, U54.49, U54.53, U54.54, U55.8
3.3V11: C222.2, C225.1, C226.1, C227.1, C228.1, C229.1, C230.1, C234.1, C236.1, C237.1, C239.1, C240.1, J45.2, J47.4, J47.4B, R144.2, R145.2, R148.2, R149.2, R153.2, R155.2, R156.2, U56.5, U57.8, U59.1, U59.11, U59.20, U59.30, U59.38, U59.45, U59.49, U59.53, U59.54, U60.8
3.3V12: C242.2, C245.1, C246.1, C247.1, C248.1, C249.1, C250.1, C254.1, C256.1, C257.1, C259.1, C260.1, J49.2, J51.4, J51.4B, R157.2, R158.2, R161.2, R162.2, R166.2, R168.2, R169.2, U61.5, U62.8, U64.1, U64.11, U64.20, U64.30, U64.38, U64.45, U64.49, U64.53, U64.54, U65.8
3.3V13: C262.2, C265.1, C266.1, C267.1, C268.1, C269.1, C270.1, C274.1, C276.1, C277.1, C279.1, C280.1, J53.2, J55.4, J55.4B, R170.2, R171.2, R174.2, R175.2, R179.2, R181.2, R182.2, U66.5, U67.8, U69.1, U69.11, U69.20, U69.30, U69.38, U69.45, U69.49, U69.53, U69.54, U70.8
3.3V14: C282.2, C285.1, C286.1, C287.1, C288.1, C289.1, C290.1, C294.1, C296.1, C297.1, C299.1, C300.1, J57.2, J59.4, J59.4B, R183.2, R184.2, R187.2, R188.2, R192.2, R194.2, R195.2, U71.5, U72.8, U74.1, U74.11, U74.20, U74.30, U74.38, U74.45, U74.49, U74.53, U74.54, U75.8
3.3V15: C302.2, C305.1, C306.1, C307.1, C308.1, C309.1, C310.1, C314.1, C316.1, C317.1, C319.1, C320.1, J61.2, J63.4, J63.4B, R196.2, R197.2, R200.2, R201.2, R205.2, R207.2, R208.2, U76.5, U77.8, U79.1, U79.11, U79.20, U79.30, U79.38, U79.45, U79.49, U79.53, U79.54, U80.8
3.3V16: C322.2, C325.1, C326.1, C327.1, C328.1, C329.1, C330.1, C334.1, C336.1, C337.1, C339.1, C340.1, J65.2, J67.4, J67.4B, R209.2, R210.2, R213.2, R214.2, R218.2, R220.2, R221.2, U81.5, U82.8, U84.1, U84.11, U84.20, U84.30, U84.38, U84.45, U84.49, U84.53, U84.54, U85.8
3.3V17: C342.2, C345.1, C346.1, C347.1, C348.1, C349.1, C350.1, C354.1, C356.1, C357.1, C359.1, C360.1, J69.2, J71.4, J71.4B, R222.2, R223.2, R226.2, R227.2, R231.2, R233.2, R234.2, U86.5, U87.8, U89.1, U89.11, U89.20, U89.30, U89.38, U89.45, U89.49, U89.53, U89.54, U90.8
3.3V18: C362.2, C365.1, C366.1, C367.1, C368.1, C369.1, C370.1, C374.1, C376.1, C377.1, C379.1, C380.1, J73.2, J75.4, J75.4B, R235.2, R236.2, R239.2, R240.2, R244.2, R246.2, R247.2, U91.5, U92.8, U94.1, U94.11, U94.20, U94.30, U94.38, U94.45, U94.49, U94.53, U94.54, U95.8
3.3V19: C382.2, C385.1, C386.1, C387.1, C388.1, C389.1, C390.1, C394.1, C396.1, C397.1, C399.1, C400.1, J77.2, J79.4, J79.4B, R248.2, R249.2, R252.2, R253.2, R257.2, R259.2, R260.2, U96.5, U97.8, U99.1, U99.11, U99.20, U99.30, U99.38, U99.45, U99.49, U99.53, U99.54, U100.8
3.3V20: C402.2, C405.1, C406.1, C407.1, C408.1, C409.1, C410.1, C414.1, C416.1, C417.1, C419.1, C420.1, J81.2, J83.4, J83.4B, R261.2, R262.2, R265.2, R266.2, R270.2, R272.2, R273.2, U101.5, U102.8, U104.1, U104.11, U104.20, U104.30, U104.38, U104.45, U104.49, U104.53, U104.54, U105.8
3.3V21: C422.2, C425.1, C426.1, C427.1, C428.1, C429.1, C430.1, C434.1, C436.1, C437.1, C439.1, C440.1, J85.2, J87.4, J87.4B, R274.2, R275.2, R278.2, R279.2, R283.2, R285.2, R286.2, U106.5, U107.8, U109.1, U109.11, U109.20, U109.30, U109.38, U109.45, U109.49, U109.53, U109.54, U110.8
3.3V22: C442.2, C445.1, C446.1, C447.1, C448.1, C449.1, C450.1, C454.1, C456.1, C457.1, C459.1, C460.1, J89.2, J91.4, J91.4B, R287.2, R288.2, R291.2, R292.2, R296.2, R298.2, R299.2, U111.5, U112.8, U114.1, U114.11, U114.20, U114.30, U114.38, U114.45, U114.49, U114.53, U114.54, U115.8
3.3V23: C462.2, C465.1, C466.1, C467.1, C468.1, C469.1, C470.1, C474.1, C476.1, C477.1, C479.1, C480.1, J93.2, J95.4, J95.4B, R300.2, R301.2, R304.2, R305.2, R309.2, R311.2, R312.2, U116.5, U117.8, U119.1, U119.11, U119.20, U119.30, U119.38, U119.45, U119.49, U119.53, U119.54, U120.8
4: J3.6, J3.6B, U2.7
5: J3.5, J3.5B, U2.8
6: J3.4, J3.4B, U2.9
7: J3.3, J3.3B, U2.10
8: J6.6, J6.6B, U9.7
8/TX1: J3.2, J3.2B, U2.12
8/TX2: J6.2, J6.2B, U9.12
8/TX3: J10.2, J10.2B, U14.12
8/TX4: J14.2, J14.2B, U19.12
8/TX5: J18.2, J18.2B, U24.12
8/TX6: J22.2, J22.2B, U29.12
8/TX7: J26.2, J26.2B, U34.12
8/TX8: J30.2, J30.2B, U39.12
8/TX9: J34.2, J34.2B, U44.12
8/TX10: J38.2, J38.2B, U49.12
8/TX11: J42.2, J42.2B, U54.12
8/TX12: J46.2, J46.2B, U59.12
8/TX13: J50.2, J50.2B, U64.12
8/TX14: J54.2, J54.2B, U69.12
8/TX15: J58.2, J58.2B, U74.12
8/TX16: J62.2, J62.2B, U79.12
8/TX17: J66.2, J66.2B, U84.12
8/TX18: J70.2, J70.2B, U89.12
8/TX19: J74.2, J74.2B, U94.12
8/TX20: J78.2, J78.2B, U99.12
8/TX21: J82.2, J82.2B, U104.12
8/TX22: J86.2, J86.2B, U109.12
8/TX23: J90.2, J90.2B, U114.12
8/TX24: J94.2, J94.2B, U119.12
9: J6.4, J6.4B, U9.9
9/RX1: J3.1, J3.1B, U2.13
9/RX2: J6.1, J6.1B, U9.13
9/RX3: J10.1, J10.1B, U14.13
9/RX4: J14.1, J14.1B, U19.13
9/RX5: J18.1, J18.1B, U24.13
9/RX6: J22.1, J22.1B, U29.13
9/RX7: J26.1, J26.1B, U34.13
9/RX8: J30.1, J30.1B, U39.13
9/RX9: J34.1, J34.1B, U44.13
9/RX10: J38.1, J38.1B, U49.13
9/RX11: J42.1, J42.1B, U54.13
9/RX12: J46.1, J46.1B, U59.13
9/RX13: J50.1, J50.1B, U64.13
9/RX14: J54.1, J54.1B, U69.13
9/RX15: J58.1, J58.1B, U74.13
9/RX16: J62.1, J62.1B, U79.13
9/RX17: J66.1, J66.1B, U84.13
9/RX18: J70.1, J70.1B, U89.13
9/RX19: J74.1, J74.1B, U94.13
9/RX20: J78.1, J78.1B, U99.13
9/RX21: J82.1, J82.1B, U104.13
9/RX22: J86.1, J86.1B, U109.13
9/RX23: J90.1, J90.1B, U114.13
9/RX24: J94.1, J94.1B, U119.13
10: J6.3, J6.3B, U9.10
11: J6.8, J6.8B, U9.4
12: J6.7, J6.7B, U9.5
13: J10.5, J10.5B, U14.8
14: J10.6, J10.6B, U14.7
15: J10.4, J10.4B, U14.9
16: J10.3, J10.3B, U14.10
16/SDA: J2.3, R5.1, U2.27
16/SDA1: J1.3, R18.1, U9.27
16/SDA2: J9.3, R31.1, U14.27
16/SDA3: J13.3, R44.1, U19.27
16/SDA4: J17.3, R57.1, U24.27
16/SDA5: J21.3, R70.1, U29.27
16/SDA6: J25.3, R83.1, U34.27
16/SDA7: J29.3, R96.1, U39.27
16/SDA8: J33.3, R109.1, U44.27
16/SDA9: J37.3, R122.1, U49.27
16/SDA10: J41.3, R135.1, U54.27
16/SDA11: J45.3, R148.1, U59.27
16/SDA12: J49.3, R161.1, U64.27
16/SDA13: J53.3, R174.1, U69.27
16/SDA14: J57.3, R187.1, U74.27
16/SDA15: J61.3, R200.1, U79.27
16/SDA16: J65.3, R213.1, U84.27
16/SDA17: J69.3, R226.1, U89.27
16/SDA18: J73.3, R239.1, U94.27
16/SDA19: J77.3, R252.1, U99.27
16/SDA20: J81.3, R265.1, U104.27
16/SDA21: J85.3, R278.1, U109.27
16/SDA22: J89.3, R291.1, U114.27
16/SDA23: J93.3, R304.1, U119.27
17: J10.8, J10.8B, U14.4
17/SCL: J2.4, R7.1, U2.28
17/SCL1: J1.4, R19.1, U9.28
17/SCL2: J9.4, R32.1, U14.28
17/SCL3: J13.4, R45.1, U19.28
17/SCL4: J17.4, R58.1, U24.28
17/SCL5: J21.4, R71.1, U29.28
17/SCL6: J25.4, R84.1, U34.28
17/SCL7: J29.4, R97.1, U39.28
17/SCL8: J33.4, R110.1, U44.28
17/SCL9: J37.4, R123.1, U49.28
17/SCL10: J41.4, R136.1, U54.28
17/SCL11: J45.4, R149.1, U59.28
17/SCL12: J49.4, R162.1, U64.28
17/SCL13: J53.4, R175.1, U69.28
17/SCL14: J57.4, R188.1, U74.28
17/SCL15: J61.4, R201.1, U79.28
17/SCL16: J65.4, R214.1, U84.28
17/SCL17: J69.4, R227.1, U89.28
17/SCL18: J73.4, R240.1, U94.28
17/SCL19: J77.4, R253.1, U99.28
17/SCL20: J81.4, R266.1, U104.28
17/SCL21: J85.4, R279.1, U109.28
17/SCL22: J89.4, R292.1, U114.28
17/SCL23: J93.4, R305.1, U119.28
18: J10.7, J10.7B, U14.5
19: J14.5, J14.5B, U19.8
20: J14.6, J14.6B, U19.7
20/SPI_POCI: J4.10, J4.10B, U2.32
20/SPI_POCI1: J7.10, J7.10B, U9.32
20/SPI_POCI2: J11.10, J11.10B, U14.32
20/SPI_POCI3: J15.10, J15.10B, U19.32
20/SPI_POCI4: J19.10, J19.10B, U24.32
20/SPI_POCI5: J23.10, J23.10B, U29.32
20/SPI_POCI6: J27.10, J27.10B, U34.32
20/SPI_POCI7: J31.10, J31.10B, U39.32
20/SPI_POCI8: J35.10, J35.10B, U44.32
20/SPI_POCI9: J39.10, J39.10B, U49.32
20/SPI_POCI10: J43.10, J43.10B, U54.32
20/SPI_POCI11: J47.10, J47.10B, U59.32
20/SPI_POCI12: J51.10, J51.10B, U64.32
20/SPI_POCI13: J55.10, J55.10B, U69.32
20/SPI_POCI14: J59.10, J59.10B, U74.32
20/SPI_POCI15: J63.10, J63.10B, U79.32
20/SPI_POCI16: J67.10, J67.10B, U84.32
20/SPI_POCI17: J71.10, J71.10B, U89.32
20/SPI_POCI18: J75.10, J75.10B, U94.32
20/SPI_POCI19: J79.10, J79.10B, U99.32
20/SPI_POCI20: J83.10, J83.10B, U104.32
20/SPI_POCI21: J87.10, J87.10B, U109.32
20/SPI_POCI22: J91.10, J91.10B, U114.32
20/SPI_POCI23: J95.10, J95.10B, U119.32
21: J14.4, J14.4B, U19.9
21/SPI_!CS!: J4.12, J4.12B, U2.33
21/SPI_!CS!1: J7.12, J7.12B, U9.33
21/SPI_!CS!2: J11.12, J11.12B, U14.33
21/SPI_!CS!3: J15.12, J15.12B, U19.33
21/SPI_!CS!4: J19.12, J19.12B, U24.33
21/SPI_!CS!5: J23.12, J23.12B, U29.33
21/SPI_!CS!6: J27.12, J27.12B, U34.33
21/SPI_!CS!7: J31.12, J31.12B, U39.33
21/SPI_!CS!8: J35.12, J35.12B, U44.33
21/SPI_!CS!9: J39.12, J39.12B, U49.33
21/SPI_!CS!10: J43.12, J43.12B, U54.33
21/SPI_!CS!11: J47.12, J47.12B, U59.33
21/SPI_!CS!12: J51.12, J51.12B, U64.33
21/SPI_!CS!13: J55.12, J55.12B, U69.33
21/SPI_!CS!14: J59.12, J59.12B, U74.33
21/SPI_!CS!15: J63.12, J63.12B, U79.33
21/SPI_!CS!16: J67.12, J67.12B, U84.33
21/SPI_!CS!17: J71.12, J71.12B, U89.33
21/SPI_!CS!18: J75.12, J75.12B, U94.33
21/SPI_!CS!19: J79.12, J79.12B, U99.33
21/SPI_!CS!20: J83.12, J83.12B, U104.33
21/SPI_!CS!21: J87.12, J87.12B, U109.33
21/SPI_!CS!22: J91.12, J91.12B, U114.33
21/SPI_!CS!23: J95.12, J95.12B, U119.33
22: J14.3, J14.3B, U19.10
22/SPI_SCK: J4.9, J4.9B, U2.34
22/SPI_SCK1: J7.9, J7.9B, U9.34
22/SPI_SCK2: J11.9, J11.9B, U14.34
22/SPI_SCK3: J15.9, J15.9B, U19.34
22/SPI_SCK4: J19.9, J19.9B, U24.34
22/SPI_SCK5: J23.9, J23.9B, U29.34
22/SPI_SCK6: J27.9, J27.9B, U34.34
22/SPI_SCK7: J31.9, J31.9B, U39.34
22/SPI_SCK8: J35.9, J35.9B, U44.34
22/SPI_SCK9: J39.9, J39.9B, U49.34
22/SPI_SCK10: J43.9, J43.9B, U54.34
22/SPI_SCK11: J47.9, J47.9B, U59.34
22/SPI_SCK12: J51.9, J51.9B, U64.34
22/SPI_SCK13: J55.9, J55.9B, U69.34
22/SPI_SCK14: J59.9, J59.9B, U74.34
22/SPI_SCK15: J63.9, J63.9B, U79.34
22/SPI_SCK16: J67.9, J67.9B, U84.34
22/SPI_SCK17: J71.9, J71.9B, U89.34
22/SPI_SCK18: J75.9, J75.9B, U94.34
22/SPI_SCK19: J79.9, J79.9B, U99.34
22/SPI_SCK20: J83.9, J83.9B, U104.34
22/SPI_SCK21: J87.9, J87.9B, U109.34
22/SPI_SCK22: J91.9, J91.9B, U114.34
22/SPI_SCK23: J95.9, J95.9B, U119.34
23: J14.8, J14.8B, U19.4
23/SPI_PICO: J4.11, J4.11B, U2.35
23/SPI_PICO1: J7.11, J7.11B, U9.35
23/SPI_PICO2: J11.11, J11.11B, U14.35
23/SPI_PICO3: J15.11, J15.11B, U19.35
23/SPI_PICO4: J19.11, J19.11B, U24.35
23/SPI_PICO5: J23.11, J23.11B, U29.35
23/SPI_PICO6: J27.11, J27.11B, U34.35
23/SPI_PICO7: J31.11, J31.11B, U39.35
23/SPI_PICO8: J35.11, J35.11B, U44.35
23/SPI_PICO9: J39.11, J39.11B, U49.35
23/SPI_PICO10: J43.11, J43.11B, U54.35
23/SPI_PICO11: J47.11, J47.11B, U59.35
23/SPI_PICO12: J51.11, J51.11B, U64.35
23/SPI_PICO13: J55.11, J55.11B, U69.35
23/SPI_PICO14: J59.11, J59.11B, U74.35
23/SPI_PICO15: J63.11, J63.11B, U79.35
23/SPI_PICO16: J67.11, J67.11B, U84.35
23/SPI_PICO17: J71.11, J71.11B, U89.35
23/SPI_PICO18: J75.11, J75.11B, U94.35
23/SPI_PICO19: J79.11, J79.11B, U99.35
23/SPI_PICO20: J83.11, J83.11B, U104.35
23/SPI_PICO21: J87.11, J87.11B, U109.35
23/SPI_PICO22: J91.11, J91.11B, U114.35
23/SPI_PICO23: J95.11, J95.11B, U119.35
24: J14.7, J14.7B, U19.5
25: J18.5, J18.5B, U24.8
25/WS2812-DI: U2.37, U3.DI
25/WS2812-DI1: U8.DI, U9.37
25/WS2812-DI2: U13.DI, U14.37
25/WS2812-DI3: U18.DI, U19.37
25/WS2812-DI4: U23.DI, U24.37
25/WS2812-DI5: U28.DI, U29.37
25/WS2812-DI6: U33.DI, U34.37
25/WS2812-DI7: U38.DI, U39.37
25/WS2812-DI8: U43.DI, U44.37
25/WS2812-DI9: U48.DI, U49.37
25/WS2812-DI10: U53.DI, U54.37
25/WS2812-DI11: U58.DI, U59.37
25/WS2812-DI12: U63.DI, U64.37
25/WS2812-DI13: U68.DI, U69.37
25/WS2812-DI14: U73.DI, U74.37
25/WS2812-DI15: U78.DI, U79.37
25/WS2812-DI16: U83.DI, U84.37
25/WS2812-DI17: U88.DI, U89.37
25/WS2812-DI18: U93.DI, U94.37
25/WS2812-DI19: U98.DI, U99.37
25/WS2812-DI20: U103.DI, U104.37
25/WS2812-DI21: U108.DI, U109.37
25/WS2812-DI22: U113.DI, U114.37
25/WS2812-DI23: U118.DI, U119.37
26: J18.6, J18.6B, U24.7
27: J18.4, J18.4B, U24.9
28: J18.3, J18.3B, U24.10
29: J18.8, J18.8B, U24.4
30: J18.7, J18.7B, U24.5
31: J22.5, J22.5B, U29.8
32: J22.6, J22.6B, U29.7
33: J22.4, J22.4B, U29.9
34: J22.3, J22.3B, U29.10
35: J22.8, J22.8B, U29.4
36: J22.7, J22.7B, U29.5
37: J26.5, J26.5B, U34.8
38: J26.6, J26.6B, U34.7
39: J26.4, J26.4B, U34.9
40: J26.3, J26.3B, U34.10
41: J26.8, J26.8B, U34.4
42: J26.7, J26.7B, U34.5
43: J30.5, J30.5B, U39.8
44: J30.6, J30.6B, U39.7
45: J30.4, J30.4B, U39.9
46: J30.3, J30.3B, U39.10
47: J30.8, J30.8B, U39.4
48: J30.7, J30.7B, U39.5
49: J34.5, J34.5B, U44.8
50: J34.6, J34.6B, U44.7
51: J34.4, J34.4B, U44.9
52: J34.3, J34.3B, U44.10
53: J34.8, J34.8B, U44.4
54: J34.7, J34.7B, U44.5
55: J38.5, J38.5B, U49.8
56: J38.6, J38.6B, U49.7
57: J38.4, J38.4B, U49.9
58: J38.3, J38.3B, U49.10
59: J38.8, J38.8B, U49.4
60: J38.7, J38.7B, U49.5
61: J42.5, J42.5B, U54.8
62: J42.6, J42.6B, U54.7
63: J42.4, J42.4B, U54.9
64: J42.3, J42.3B, U54.10
65: J42.8, J42.8B, U54.4
66: J42.7, J42.7B, U54.5
67: J46.5, J46.5B, U59.8
68: J46.6, J46.6B, U59.7
69: J46.4, J46.4B, U59.9
70: J46.3, J46.3B, U59.10
71: J46.8, J46.8B, U59.4
72: J46.7, J46.7B, U59.5
73: J50.5, J50.5B, U64.8
74: J50.6, J50.6B, U64.7
75: J50.4, J50.4B, U64.9
76: J50.3, J50.3B, U64.10
77: J50.8, J50.8B, U64.4
78: J50.7, J50.7B, U64.5
79: J54.5, J54.5B, U69.8
80: J54.6, J54.6B, U69.7
81: J54.4, J54.4B, U69.9
82: J54.3, J54.3B, U69.10
83: J54.8, J54.8B, U69.4
84: J54.7, J54.7B, U69.5
85: J58.5, J58.5B, U74.8
86: J58.6, J58.6B, U74.7
87: J58.4, J58.4B, U74.9
88: J58.3, J58.3B, U74.10
89: J58.8, J58.8B, U74.4
90: J58.7, J58.7B, U74.5
91: J62.5, J62.5B, U79.8
92: J62.6, J62.6B, U79.7
93: J62.4, J62.4B, U79.9
94: J62.3, J62.3B, U79.10
95: J62.8, J62.8B, U79.4
96: J62.7, J62.7B, U79.5
97: J66.5, J66.5B, U84.8
98: J66.6, J66.6B, U84.7
99: J66.4, J66.4B, U84.9
100: J66.3, J66.3B, U84.10
101: J66.8, J66.8B, U84.4
102: J66.7, J66.7B, U84.5
103: J70.5, J70.5B, U89.8
104: J70.6, J70.6B, U89.7
105: J70.4, J70.4B, U89.9
106: J70.3, J70.3B, U89.10
107: J70.8, J70.8B, U89.4
108: J70.7, J70.7B, U89.5
109: J74.5, J74.5B, U94.8
110: J74.6, J74.6B, U94.7
111: J74.4, J74.4B, U94.9
112: J74.3, J74.3B, U94.10
113: J74.8, J74.8B, U94.4
114: J74.7, J74.7B, U94.5
115: J78.5, J78.5B, U99.8
116: J78.6, J78.6B, U99.7
117: J78.4, J78.4B, U99.9
118: J78.3, J78.3B, U99.10
119: J78.8, J78.8B, U99.4
120: J78.7, J78.7B, U99.5
121: J82.5, J82.5B, U104.8
122: J82.6, J82.6B, U104.7
123: J82.4, J82.4B, U104.9
124: J82.3, J82.3B, U104.10
125: J82.8, J82.8B, U104.4
126: J82.7, J82.7B, U104.5
127: J86.5, J86.5B, U109.8
128: J86.6, J86.6B, U109.7
129: J86.4, J86.4B, U109.9
130: J86.3, J86.3B, U109.10
131: J86.8, J86.8B, U109.4
132: J86.7, J86.7B, U109.5
133: J90.5, J90.5B, U114.8
134: J90.6, J90.6B, U114.7
135: J90.4, J90.4B, U114.9
136: J90.3, J90.3B, U114.10
137: J90.8, J90.8B, U114.4
138: J90.7, J90.7B, U114.5
139: J94.5, J94.5B, U119.8
140: J94.6, J94.6B, U119.7
141: J94.4, J94.4B, U119.9
142: J94.3, J94.3B, U119.10
143: J94.8, J94.8B, U119.4
144: J94.7, J94.7B, U119.5
!RESET!: J4.3, J4.3B, R2.1, S1.3, S1.4, U2.26
!RESET!1: J7.3, J7.3B, R8.1, S3.3, S3.4, U9.26
!RESET!2: J11.3, J11.3B, R28.1, S5.3, S5.4, U14.26
!RESET!3: J15.3, J15.3B, R41.1, S7.3, S7.4, U19.26
!RESET!4: J19.3, J19.3B, R54.1, S9.3, S9.4, U24.26
!RESET!5: J23.3, J23.3B, R67.1, S11.3, S11.4, U29.26
!RESET!6: J27.3, J27.3B, R80.1, S13.3, S13.4, U34.26
!RESET!7: J31.3, J31.3B, R93.1, S15.3, S15.4, U39.26
!RESET!8: J35.3, J35.3B, R106.1, S17.3, S17.4, U44.26
!RESET!9: J39.3, J39.3B, R119.1, S19.3, S19.4, U49.26
!RESET!10: J43.3, J43.3B, R132.1, S21.3, S21.4, U54.26
!RESET!11: J47.3, J47.3B, R145.1, S23.3, S23.4, U59.26
!RESET!12: J51.3, J51.3B, R158.1, S25.3, S25.4, U64.26
!RESET!13: J55.3, J55.3B, R171.1, S27.3, S27.4, U69.26
!RESET!14: J59.3, J59.3B, R184.1, S29.3, S29.4, U74.26
!RESET!15: J63.3, J63.3B, R197.1, S31.3, S31.4, U79.26
!RESET!16: J67.3, J67.3B, R210.1, S33.3, S33.4, U84.26
!RESET!17: J71.3, J71.3B, R223.1, S35.3, S35.4, U89.26
!RESET!18: J75.3, J75.3B, R236.1, S37.3, S37.4, U94.26
!RESET!19: J79.3, J79.3B, R249.1, S39.3, S39.4, U99.26
!RESET!20: J83.3, J83.3B, R262.1, S41.3, S41.4, U104.26
!RESET!21: J87.3, J87.3B, R275.1, S43.3, S43.4, U109.26
!RESET!22: J91.3, J91.3B, R288.1, S45.3, S45.4, U114.26
!RESET!23: J95.3, J95.3B, R301.1, S47.3, S47.4, U119.26
A0: J4.8, J4.8B, U2.40
A1: J4.7, J4.7B, U2.41
A2: J4.6, J4.6B, U2.42
A3: J4.5, J4.5B, U2.43
A4: J7.5, J7.5B, U9.43
A5: J7.6, J7.6B, U9.42
A6: J7.7, J7.7B, U9.41
A7: J7.8, J7.8B, U9.40
A8: J11.5, J11.5B, U14.43
A9: J11.6, J11.6B, U14.42
A10: J11.7, J11.7B, U14.41
A11: J11.8, J11.8B, U14.40
A12: J15.5, J15.5B, U19.43
A13: J15.6, J15.6B, U19.42
A14: J15.7, J15.7B, U19.41
A15: J15.8, J15.8B, U19.40
A16: J19.5, J19.5B, U24.43
A17: J19.6, J19.6B, U24.42
A18: J19.7, J19.7B, U24.41
A19: J19.8, J19.8B, U24.40
A20: J23.5, J23.5B, U29.43
A21: J23.6, J23.6B, U29.42
A22: J23.7, J23.7B, U29.41
A23: J23.8, J23.8B, U29.40
A24: J27.5, J27.5B, U34.43
A25: J27.6, J27.6B, U34.42
A26: J27.7, J27.7B, U34.41
A27: J27.8, J27.8B, U34.40
A28: J31.5, J31.5B, U39.43
A29: J31.6, J31.6B, U39.42
A30: J31.7, J31.7B, U39.41
A31: J31.8, J31.8B, U39.40
A32: J35.5, J35.5B, U44.43
A33: J35.6, J35.6B, U44.42
A34: J35.7, J35.7B, U44.41
A35: J35.8, J35.8B, U44.40
A36: J39.5, J39.5B, U49.43
A37: J39.6, J39.6B, U49.42
A38: J39.7, J39.7B, U49.41
A39: J39.8, J39.8B, U49.40
A40: J43.5, J43.5B, U54.43
A41: J43.6, J43.6B, U54.42
A42: J43.7, J43.7B, U54.41
A43: J43.8, J43.8B, U54.40
A44: J47.5, J47.5B, U59.43
A45: J47.6, J47.6B, U59.42
A46: J47.7, J47.7B, U59.41
A47: J47.8, J47.8B, U59.40
A48: J51.5, J51.5B, U64.43
A49: J51.6, J51.6B, U64.42
A50: J51.7, J51.7B, U64.41
A51: J51.8, J51.8B, U64.40
A52: J55.5, J55.5B, U69.43
A53: J55.6, J55.6B, U69.42
A54: J55.7, J55.7B, U69.41
A55: J55.8, J55.8B, U69.40
A56: J59.5, J59.5B, U74.43
A57: J59.6, J59.6B, U74.42
A58: J59.7, J59.7B, U74.41
A59: J59.8, J59.8B, U74.40
A60: J63.5, J63.5B, U79.43
A61: J63.6, J63.6B, U79.42
A62: J63.7, J63.7B, U79.41
A63: J63.8, J63.8B, U79.40
A64: J67.5, J67.5B, U84.43
A65: J67.6, J67.6B, U84.42
A66: J67.7, J67.7B, U84.41
A67: J67.8, J67.8B, U84.40
A68: J71.5, J71.5B, U89.43
A69: J71.6, J71.6B, U89.42
A70: J71.7, J71.7B, U89.41
A71: J71.8, J71.8B, U89.40
A72: J75.5, J75.5B, U94.43
A73: J75.6, J75.6B, U94.42
A74: J75.7, J75.7B, U94.41
A75: J75.8, J75.8B, U94.40
A76: J79.5, J79.5B, U99.43
A77: J79.6, J79.6B, U99.42
A78: J79.7, J79.7B, U99.41
A79: J79.8, J79.8B, U99.40
A80: J83.5, J83.5B, U104.43
A81: J83.6, J83.6B, U104.42
A82: J83.7, J83.7B, U104.41
A83: J83.8, J83.8B, U104.40
A84: J87.5, J87.5B, U109.43
A85: J87.6, J87.6B, U109.42
A86: J87.7, J87.7B, U109.41
A87: J87.8, J87.8B, U109.40
A88: J91.5, J91.5B, U114.43
A89: J91.6, J91.6B, U114.42
A90: J91.7, J91.7B, U114.41
A91: J91.8, J91.8B, U114.40
A92: J95.5, J95.5B, U119.43
A93: J95.6, J95.6B, U119.42
A94: J95.7, J95.7B, U119.41
A95: J95.8, J95.8B, U119.40
BOOT: R15.2, S2.3, S2.4, TP4.1
BOOT1: R24.2, S4.3, S4.4, TP8.1
BOOT2: R37.2, S6.3, S6.4, TP12.1
BOOT3: R50.2, S8.3, S8.4, TP16.1
BOOT4: R63.2, S10.3, S10.4, TP20.1
BOOT5: R76.2, S12.3, S12.4, TP24.1
BOOT6: R89.2, S14.3, S14.4, TP28.1
BOOT7: R102.2, S16.3, S16.4, TP32.1
BOOT8: R115.2, S18.3, S18.4, TP36.1
BOOT9: R128.2, S20.3, S20.4, TP40.1
BOOT10: R141.2, S22.3, S22.4, TP44.1
BOOT11: R154.2, S24.3, S24.4, TP48.1
BOOT12: R167.2, S26.3, S26.4, TP52.1
BOOT13: R180.2, S28.3, S28.4, TP56.1
BOOT14: R193.2, S30.3, S30.4, TP60.1
BOOT15: R206.2, S32.3, S32.4, TP64.1
BOOT16: R219.2, S34.3, S34.4, TP68.1
BOOT17: R232.2, S36.3, S36.4, TP72.1
BOOT18: R245.2, S38.3, S38.4, TP76.1
BOOT19: R258.2, S40.3, S40.4, TP80.1
BOOT20: R271.2, S42.3, S42.4, TP84.1
BOOT21: R284.2, S44.3, S44.4, TP88.1
BOOT22: R297.2, S46.3, S46.4, TP92.1
BOOT23: R310.2, S48.3, S48.4, TP96.1
FLASH_!CS!/BOOT: R15.1, R16.1, U2.60, U4.1
FLASH_!CS!/BOOT1: R24.1, R25.1, U7.1, U9.60
FLASH_!CS!/BOOT2: R37.1, R38.1, U12.1, U14.60
FLASH_!CS!/BOOT3: R50.1, R51.1, U17.1, U19.60
FLASH_!CS!/BOOT4: R63.1, R64.1, U22.1, U24.60
FLASH_!CS!/BOOT5: R76.1, R77.1, U27.1, U29.60
FLASH_!CS!/BOOT6: R89.1, R90.1, U32.1, U34.60
FLASH_!CS!/BOOT7: R102.1, R103.1, U37.1, U39.60
FLASH_!CS!/BOOT8: R115.1, R116.1, U42.1, U44.60
FLASH_!CS!/BOOT9: R128.1, R129.1, U47.1, U49.60
FLASH_!CS!/BOOT10: R141.1, R142.1, U52.1, U54.60
FLASH_!CS!/BOOT11: R154.1, R155.1, U57.1, U59.60
FLASH_!CS!/BOOT12: R167.1, R168.1, U62.1, U64.60
FLASH_!CS!/BOOT13: R180.1, R181.1, U67.1, U69.60
FLASH_!CS!/BOOT14: R193.1, R194.1, U72.1, U74.60
FLASH_!CS!/BOOT15: R206.1, R207.1, U77.1, U79.60
FLASH_!CS!/BOOT16: R219.1, R220.1, U82.1, U84.60
FLASH_!CS!/BOOT17: R232.1, R233.1, U87.1, U89.60
FLASH_!CS!/BOOT18: R245.1, R246.1, U92.1, U94.60
FLASH_!CS!/BOOT19: R258.1, R259.1, U97.1, U99.60
FLASH_!CS!/BOOT20: R271.1, R272.1, U102.1, U104.60
FLASH_!CS!/BOOT21: R284.1, R285.1, U107.1, U109.60
FLASH_!CS!/BOOT22: R297.1, R298.1, U112.1, U114.60
FLASH_!CS!/BOOT23: R310.1, R311.1, U117.1, U119.60
GND: C1.2, C2.2, C3.2, C7.1, C8.1, C9.2, C11.1, C12.2, C13.1, C14.2, C15.2, C16.2, C17.2, C18.2, C19.2, C20.2, C21.2, C22.2, C23.2, C29.2, J2.1, J3.9, J3.9B, J3.10, J3.10B, J4.2, J4.2B, J5.GND, J5.GND2, JP14.GND, PWR.1, R1.1, R3.1, S1.1, S1.2, S2.1, S2.2, SHLD.2, U1.2, U2.47, U2.EPAD, U3.GND, U4.4, U5.4, U5.9
GND1: C4.1, C5.1, C6.1, C10.1, C24.2, C25.2, C26.2, C27.2, C28.2, C30.2, C31.2, C32.2, C33.2, C34.2, C35.2, C36.2, C37.2, C38.2, C39.2, C40.2, J1.1, J6.9, J6.9B, J6.10, J6.10B, J7.2, J7.2B, J8.GND, J8.GND2, JP7.GND, PWR1.1, R9.1, R17.1, S3.1, S3.2, S4.1, S4.2, SHLD1.2, U6.2, U7.4, U8.GND, U9.47, U9.EPAD, U10.4, U10.9
GND2: C41.1, C42.1, C43.1, C44.1, C45.2, C46.2, C47.2, C48.2, C49.2, C50.2, C51.2, C52.2, C53.2, C54.2, C55.2, C56.2, C57.2, C58.2, C59.2, C60.2, J9.1, J10.9, J10.9B, J10.10, J10.10B, J11.2, J11.2B, J12.GND, J12.GND2, JP12.GND, PWR2.1, R29.1, R30.1, S5.1, S5.2, S6.1, S6.2, SHLD2.2, U11.2, U12.4, U13.GND, U14.47, U14.EPAD, U15.4, U15.9
GND3: C61.1, C62.1, C63.1, C64.1, C65.2, C66.2, C67.2, C68.2, C69.2, C70.2, C71.2, C72.2, C73.2, C74.2, C75.2, C76.2, C77.2, C78.2, C79.2, C80.2, J13.1, J14.9, J14.9B, J14.10, J14.10B, J15.2, J15.2B, J16.GND, J16.GND2, JP18.GND, PWR3.1, R42.1, R43.1, S7.1, S7.2, S8.1, S8.2, SHLD3.2, U16.2, U17.4, U18.GND, U19.47, U19.EPAD, U20.4, U20.9
GND4: C81.1, C82.1, C83.1, C84.1, C85.2, C86.2, C87.2, C88.2, C89.2, C90.2, C91.2, C92.2, C93.2, C94.2, C95.2, C96.2, C97.2, C98.2, C99.2, C100.2, J17.1, J18.9, J18.9B, J18.10, J18.10B, J19.2, J19.2B, J20.GND, J20.GND2, JP23.GND, PWR4.1, R55.1, R56.1, S9.1, S9.2, S10.1, S10.2, SHLD4.2, U21.2, U22.4, U23.GND, U24.47, U24.EPAD, U25.4, U25.9
GND5: C101.1, C102.1, C103.1, C104.1, C105.2, C106.2, C107.2, C108.2, C109.2, C110.2, C111.2, C112.2, C113.2, C114.2, C115.2, C116.2, C117.2, C118.2, C119.2, C120.2, J21.1, J22.9, J22.9B, J22.10, J22.10B, J23.2, J23.2B, J24.GND, J24.GND2, JP28.GND, PWR5.1, R68.1, R69.1, S11.1, S11.2, S12.1, S12.2, SHLD5.2, U26.2, U27.4, U28.GND, U29.47, U29.EPAD, U30.4, U30.9
GND6: C121.1, C122.1, C123.1, C124.1, C125.2, C126.2, C127.2, C128.2, C129.2, C130.2, C131.2, C132.2, C133.2, C134.2, C135.2, C136.2, C137.2, C138.2, C139.2, C140.2, J25.1, J26.9, J26.9B, J26.10, J26.10B, J27.2, J27.2B, J28.GND, J28.GND2, JP33.GND, PWR6.1, R81.1, R82.1, S13.1, S13.2, S14.1, S14.2, SHLD6.2, U31.2, U32.4, U33.GND, U34.47, U34.EPAD, U35.4, U35.9
GND7: C141.1, C142.1, C143.1, C144.1, C145.2, C146.2, C147.2, C148.2, C149.2, C150.2, C151.2, C152.2, C153.2, C154.2, C155.2, C156.2, C157.2, C158.2, C159.2, C160.2, J29.1, J30.9, J30.9B, J30.10, J30.10B, J31.2, J31.2B, J32.GND, J32.GND2, JP38.GND, PWR7.1, R94.1, R95.1, S15.1, S15.2, S16.1, S16.2, SHLD7.2, U36.2, U37.4, U38.GND, U39.47, U39.EPAD, U40.4, U40.9
GND8: C161.1, C162.1, C163.1, C164.1, C165.2, C166.2, C167.2, C168.2, C169.2, C170.2, C171.2, C172.2, C173.2, C174.2, C175.2, C176.2, C177.2, C178.2, C179.2, C180.2, J33.1, J34.9, J34.9B, J34.10, J34.10B, J35.2, J35.2B, J36.GND, J36.GND2, JP43.GND, PWR8.1, R107.1, R108.1, S17.1, S17.2, S18.1, S18.2, SHLD8.2, U41.2, U42.4, U43.GND, U44.47, U44.EPAD, U45.4, U45.9
GND9: C181.1, C182.1, C183.1, C184.1, C185.2, C186.2, C187.2, C188.2, C189.2, C190.2, C191.2, C192.2, C193.2, C194.2, C195.2, C196.2, C197.2, C198.2, C199.2, C200.2, J37.1, J38.9, J38.9B, J38.10, J38.10B, J39.2, J39.2B, J40.GND, J40.GND2, JP48.GND, PWR9.1, R120.1, R121.1, S19.1, S19.2, S20.1, S20.2, SHLD9.2, U46.2, U47.4, U48.GND, U49.47, U49.EPAD, U50.4, U50.9
GND10: C201.1, C202.1, C203.1, C204.1, C205.2, C206.2, C207.2, C208.2, C209.2, C210.2, C211.2, C212.2, C213.2, C214.2, C215.2, C216.2, C217.2, C218.2, C219.2, C220.2, J41.1, J42.9, J42.9B, J42.10, J42.10B, J43.2, J43.2B, J44.GND, J44.GND2, JP53.GND, PWR10.1, R133.1, R134.1, S21.1, S21.2, S22.1, S22.2, SHLD10.2, U51.2, U52.4, U53.GND, U54.47, U54.EPAD, U55.4, U55.9
GND11: C221.1, C222.1, C223.1, C224.1, C225.2, C226.2, C227.2, C228.2, C229.2, C230.2, C231.2, C232.2, C233.2, C234.2, C235.2, C236.2, C237.2, C238.2, C239.2, C240.2, J45.1, J46.9, J46.9B, J46.10, J46.10B, J47.2, J47.2B, J48.GND, J48.GND2, JP58.GND, PWR11.1, R146.1, R147.1, S23.1, S23.2, S24.1, S24.2, SHLD11.2, U56.2, U57.4, U58.GND, U59.47, U59.EPAD, U60.4, U60.9
GND12: C241.1, C242.1, C243.1, C244.1, C245.2, C246.2, C247.2, C248.2, C249.2, C250.2, C251.2, C252.2, C253.2, C254.2, C255.2, C256.2, C257.2, C258.2, C259.2, C260.2, J49.1, J50.9, J50.9B, J50.10, J50.10B, J51.2, J51.2B, J52.GND, J52.GND2, JP63.GND, PWR12.1, R159.1, R160.1, S25.1, S25.2, S26.1, S26.2, SHLD12.2, U61.2, U62.4, U63.GND, U64.47, U64.EPAD, U65.4, U65.9
GND13: C261.1, C262.1, C263.1, C264.1, C265.2, C266.2, C267.2, C268.2, C269.2, C270.2, C271.2, C272.2, C273.2, C274.2, C275.2, C276.2, C277.2, C278.2, C279.2, C280.2, J53.1, J54.9, J54.9B, J54.10, J54.10B, J55.2, J55.2B, J56.GND, J56.GND2, JP68.GND, PWR13.1, R172.1, R173.1, S27.1, S27.2, S28.1, S28.2, SHLD13.2, U66.2, U67.4, U68.GND, U69.47, U69.EPAD, U70.4, U70.9
GND14: C281.1, C282.1, C283.1, C284.1, C285.2, C286.2, C287.2, C288.2, C289.2, C290.2, C291.2, C292.2, C293.2, C294.2, C295.2, C296.2, C297.2, C298.2, C299.2, C300.2, J57.1, J58.9, J58.9B, J58.10, J58.10B, J59.2, J59.2B, J60.GND, J60.GND2, JP73.GND, PWR14.1, R185.1, R186.1, S29.1, S29.2, S30.1, S30.2, SHLD14.2, U71.2, U72.4, U73.GND, U74.47, U74.EPAD, U75.4, U75.9
GND15: C301.1, C302.1, C303.1, C304.1, C305.2, C306.2, C307.2, C308.2, C309.2, C310.2, C311.2, C312.2, C313.2, C314.2, C315.2, C316.2, C317.2, C318.2, C319.2, C320.2, J61.1, J62.9, J62.9B, J62.10, J62.10B, J63.2, J63.2B, J64.GND, J64.GND2, JP78.GND, PWR15.1, R198.1, R199.1, S31.1, S31.2, S32.1, S32.2, SHLD15.2, U76.2, U77.4, U78.GND, U79.47, U79.EPAD, U80.4, U80.9
GND16: C321.1, C322.1, C323.1, C324.1, C325.2, C326.2, C327.2, C328.2, C329.2, C330.2, C331.2, C332.2, C333.2, C334.2, C335.2, C336.2, C337.2, C338.2, C339.2, C340.2, J65.1, J66.9, J66.9B, J66.10, J66.10B, J67.2, J67.2B, J68.GND, J68.GND2, JP83.GND, PWR16.1, R211.1, R212.1, S33.1, S33.2, S34.1, S34.2, SHLD16.2, U81.2, U82.4, U83.GND, U84.47, U84.EPAD, U85.4, U85.9
GND17: C341.1, C342.1, C343.1, C344.1, C345.2, C346.2, C347.2, C348.2, C349.2, C350.2, C351.2, C352.2, C353.2, C354.2, C355.2, C356.2, C357.2, C358.2, C359.2, C360.2, J69.1, J70.9, J70.9B, J70.10, J70.10B, J71.2, J71.2B, J72.GND, J72.GND2, JP88.GND, PWR17.1, R224.1, R225.1, S35.1, S35.2, S36.1, S36.2, SHLD17.2, U86.2, U87.4, U88.GND, U89.47, U89.EPAD, U90.4, U90.9
GND18: C361.1, C362.1, C363.1, C364.1, C365.2, C366.2, C367.2, C368.2, C369.2, C370.2, C371.2, C372.2, C373.2, C374.2, C375.2, C376.2, C377.2, C378.2, C379.2, C380.2, J73.1, J74.9, J74.9B, J74.10, J74.10B, J75.2, J75.2B, J76.GND, J76.GND2, JP93.GND, PWR18.1, R237.1, R238.1, S37.1, S37.2, S38.1, S38.2, SHLD18.2, U91.2, U92.4, U93.GND, U94.47, U94.EPAD, U95.4, U95.9
GND19: C381.1, C382.1, C383.1, C384.1, C385.2, C386.2, C387.2, C388.2, C389.2, C390.2, C391.2, C392.2, C393.2, C394.2, C395.2, C396.2, C397.2, C398.2, C399.2, C400.2, J77.1, J78.9, J78.9B, J78.10, J78.10B, J79.2, J79.2B, J80.GND, J80.GND2, JP98.GND, PWR19.1, R250.1, R251.1, S39.1, S39.2, S40.1, S40.2, SHLD19.2, U96.2, U97.4, U98.GND, U99.47, U99.EPAD, U100.4, U100.9
GND20: C401.1, C402.1, C403.1, C404.1, C405.2, C406.2, C407.2, C408.2, C409.2, C410.2, C411.2, C412.2, C413.2, C414.2, C415.2, C416.2, C417.2, C418.2, C419.2, C420.2, J81.1, J82.9, J82.9B, J82.10, J82.10B, J83.2, J83.2B, J84.GND, J84.GND2, JP103.GND, PWR20.1, R263.1, R264.1, S41.1, S41.2, S42.1, S42.2, SHLD20.2, U101.2, U102.4, U103.GND, U104.47, U104.EPAD, U105.4, U105.9
GND21: C421.1, C422.1, C423.1, C424.1, C425.2, C426.2, C427.2, C428.2, C429.2, C430.2, C431.2, C432.2, C433.2, C434.2, C435.2, C436.2, C437.2, C438.2, C439.2, C440.2, J85.1, J86.9, J86.9B, J86.10, J86.10B, J87.2, J87.2B, J88.GND, J88.GND2, JP108.GND, PWR21.1, R276.1, R277.1, S43.1, S43.2, S44.1, S44.2, SHLD21.2, U106.2, U107.4, U108.GND, U109.47, U109.EPAD, U110.4, U110.9
GND22: C441.1, C442.1, C443.1, C444.1, C445.2, C446.2, C447.2, C448.2, C449.2, C450.2, C451.2, C452.2, C453.2, C454.2, C455.2, C456.2, C457.2, C458.2, C459.2, C460.2, J89.1, J90.9, J90.9B, J90.10, J90.10B, J91.2, J91.2B, J92.GND, J92.GND2, JP113.GND, PWR22.1, R289.1, R290.1, S45.1, S45.2, S46.1, S46.2, SHLD22.2, U111.2, U112.4, U113.GND, U114.47, U114.EPAD, U115.4, U115.9
GND23: C461.1, C462.1, C463.1, C464.1, C465.2, C466.2, C467.2, C468.2, C469.2, C470.2, C471.2, C472.2, C473.2, C474.2, C475.2, C476.2, C477.2, C478.2, C479.2, C480.2, J93.1, J94.9, J94.9B, J94.10, J94.10B, J95.2, J95.2B, J96.GND, J96.GND2, JP118.GND, PWR23.1, R302.1, R303.1, S47.1, S47.2, S48.1, S48.2, SHLD23.2, U116.2, U117.4, U118.GND, U119.47, U119.EPAD, U120.4, U120.9
unnamed: LED2.A, R6.1
unnamed: L1.2, U2.48
unnamed: LED1.C, PWR.2
unnamed: J8.A5, R17.2
unnamed: J8.B5, R9.2
unnamed: L2.2, U9.48
unnamed: LED2.C, PWR1.2
unnamed: LED3.A, R27.1
unnamed: J5.A5, R3.2
unnamed: J5.B5, R1.2
unnamed: J12.A5, R30.2
unnamed: J12.B5, R29.2
unnamed: L3.2, U14.48
unnamed: LED3.C, PWR2.2
unnamed: LED4.A, R40.1
unnamed: J16.A5, R43.2
unnamed: J16.B5, R42.2
unnamed: L4.2, U19.48
unnamed: LED4.C, PWR3.2
unnamed: LED5.A, R53.1
unnamed: J20.A5, R56.2
unnamed: J20.B5, R55.2
unnamed: L5.2, U24.48
unnamed: LED5.C, PWR4.2
unnamed: LED6.A, R66.1
unnamed: J24.A5, R69.2
unnamed: J24.B5, R68.2
unnamed: L6.2, U29.48
unnamed: LED6.C, PWR5.2
unnamed: LED7.A, R79.1
unnamed: J28.A5, R82.2
unnamed: J28.B5, R81.2
unnamed: L7.2, U34.48
unnamed: LED7.C, PWR6.2
unnamed: LED8.A, R92.1
unnamed: J32.A5, R95.2
unnamed: J32.B5, R94.2
unnamed: LED1.A, R11.1
unnamed: L8.2, U39.48
unnamed: LED8.C, PWR7.2
unnamed: LED9.A, R105.1
unnamed: J36.A5, R108.2
unnamed: J36.B5, R107.2
unnamed: L9.2, U44.48
unnamed: LED9.C, PWR8.2
unnamed: LED10.A, R118.1
unnamed: J40.A5, R121.2
unnamed: J40.B5, R120.2
unnamed: L10.2, U49.48
unnamed: LED10.C, PWR9.2
unnamed: LED11.A, R131.1
unnamed: J44.A5, R134.2
unnamed: J44.B5, R133.2
unnamed: L11.2, U54.48
unnamed: LED11.C, PWR10.2
unnamed: LED12.A, R144.1
unnamed: J48.A5, R147.2
unnamed: J48.B5, R146.2
unnamed: L12.2, U59.48
unnamed: LED12.C, PWR11.2
unnamed: LED13.A, R157.1
unnamed: J52.A5, R160.2
unnamed: J52.B5, R159.2
unnamed: L13.2, U64.48
unnamed: LED13.C, PWR12.2
unnamed: LED14.A, R170.1
unnamed: J56.A5, R173.2
unnamed: J56.B5, R172.2
unnamed: L14.2, U69.48
unnamed: LED14.C, PWR13.2
unnamed: LED15.A, R183.1
unnamed: J60.A5, R186.2
unnamed: J60.B5, R185.2
unnamed: L15.2, U74.48
unnamed: LED15.C, PWR14.2
unnamed: LED16.A, R196.1
unnamed: J64.A5, R199.2
unnamed: J64.B5, R198.2
unnamed: L16.2, U79.48
unnamed: LED16.C, PWR15.2
unnamed: LED17.A, R209.1
unnamed: J68.A5, R212.2
unnamed: J68.B5, R211.2
unnamed: L17.2, U84.48
unnamed: LED17.C, PWR16.2
unnamed: LED18.A, R222.1
unnamed: J72.A5, R225.2
unnamed: J72.B5, R224.2
unnamed: L18.2, U89.48
unnamed: LED18.C, PWR17.2
unnamed: LED19.A, R235.1
unnamed: J76.A5, R238.2
unnamed: J76.B5, R237.2
unnamed: L19.2, U94.48
unnamed: LED19.C, PWR18.2
unnamed: LED20.A, R248.1
unnamed: J80.A5, R251.2
unnamed: J80.B5, R250.2
unnamed: L20.2, U99.48
unnamed: LED20.C, PWR19.2
unnamed: LED21.A, R261.1
unnamed: J84.A5, R264.2
unnamed: J84.B5, R263.2
unnamed: L21.2, U104.48
unnamed: LED21.C, PWR20.2
unnamed: LED22.A, R274.1
unnamed: J88.A5, R277.2
unnamed: J88.B5, R276.2
unnamed: L22.2, U109.48
unnamed: LED22.C, PWR21.2
unnamed: LED23.A, R287.1
unnamed: J92.A5, R290.2
unnamed: J92.B5, R289.2
unnamed: L23.2, U114.48
unnamed: LED23.C, PWR22.2
unnamed: LED24.A, R300.1
unnamed: J96.A5, R303.2
unnamed: J96.B5, R302.2
unnamed: L24.2, U119.48
unnamed: LED24.C, PWR23.2
PSRAM_!CS!: R4.1, U2.31, U5.1
PSRAM_!CS!1: R26.1, U9.31, U10.1
PSRAM_!CS!2: R39.1, U14.31, U15.1
PSRAM_!CS!3: R52.1, U19.31, U20.1
PSRAM_!CS!4: R65.1, U24.31, U25.1
PSRAM_!CS!5: R78.1, U29.31, U30.1
PSRAM_!CS!6: R91.1, U34.31, U35.1
PSRAM_!CS!7: R104.1, U39.31, U40.1
PSRAM_!CS!8: R117.1, U44.31, U45.1
PSRAM_!CS!9: R130.1, U49.31, U50.1
PSRAM_!CS!10: R143.1, U54.31, U55.1
PSRAM_!CS!11: R156.1, U59.31, U60.1
PSRAM_!CS!12: R169.1, U64.31, U65.1
PSRAM_!CS!13: R182.1, U69.31, U70.1
PSRAM_!CS!14: R195.1, U74.31, U75.1
PSRAM_!CS!15: R208.1, U79.31, U80.1
PSRAM_!CS!16: R221.1, U84.31, U85.1
PSRAM_!CS!17: R234.1, U89.31, U90.1
PSRAM_!CS!18: R247.1, U94.31, U95.1
PSRAM_!CS!19: R260.1, U99.31, U100.1
PSRAM_!CS!20: R273.1, U104.31, U105.1
PSRAM_!CS!21: R286.1, U109.31, U110.1
PSRAM_!CS!22: R299.1, U114.31, U115.1
PSRAM_!CS!23: R312.1, U119.31, U120.1
QSPI-0: U2.57, U4.5, U5.5
QSPI-1: U2.59, U4.2, U5.2
QSPI-2: U2.58, U4.3, U5.3
QSPI-3: U2.55, U4.7, U5.7
QSPI-4: U7.5, U9.57, U10.5
QSPI-5: U7.7, U9.55, U10.7
QSPI-6: U7.2, U9.59, U10.2
QSPI-7: U7.3, U9.58, U10.3
QSPI-8: U12.5, U14.57, U15.5
QSPI-9: U12.7, U14.55, U15.7
QSPI-10: U12.2, U14.59, U15.2
QSPI-11: U12.3, U14.58, U15.3
QSPI-12: U17.5, U19.57, U20.5
QSPI-13: U17.7, U19.55, U20.7
QSPI-14: U17.2, U19.59, U20.2
QSPI-15: U17.3, U19.58, U20.3
QSPI-16: U22.5, U24.57, U25.5
QSPI-17: U22.7, U24.55, U25.7
QSPI-18: U22.2, U24.59, U25.2
QSPI-19: U22.3, U24.58, U25.3
QSPI-20: U27.5, U29.57, U30.5
QSPI-21: U27.7, U29.55, U30.7
QSPI-22: U27.2, U29.59, U30.2
QSPI-23: U27.3, U29.58, U30.3
QSPI-24: U32.5, U34.57, U35.5
QSPI-25: U32.7, U34.55, U35.7
QSPI-26: U32.2, U34.59, U35.2
QSPI-27: U32.3, U34.58, U35.3
QSPI-28: U37.5, U39.57, U40.5
QSPI-29: U37.7, U39.55, U40.7
QSPI-30: U37.2, U39.59, U40.2
QSPI-31: U37.3, U39.58, U40.3
QSPI-32: U42.5, U44.57, U45.5
QSPI-33: U42.7, U44.55, U45.7
QSPI-34: U42.2, U44.59, U45.2
QSPI-35: U42.3, U44.58, U45.3
QSPI-36: U47.5, U49.57, U50.5
QSPI-37: U47.7, U49.55, U50.7
QSPI-38: U47.2, U49.59, U50.2
QSPI-39: U47.3, U49.58, U50.3
QSPI-40: U52.5, U54.57, U55.5
QSPI-41: U52.7, U54.55, U55.7
QSPI-42: U52.2, U54.59, U55.2
QSPI-43: U52.3, U54.58, U55.3
QSPI-44: U57.5, U59.57, U60.5
QSPI-45: U57.7, U59.55, U60.7
QSPI-46: U57.2, U59.59, U60.2
QSPI-47: U57.3, U59.58, U60.3
QSPI-48: U62.5, U64.57, U65.5
QSPI-49: U62.7, U64.55, U65.7
QSPI-50: U62.2, U64.59, U65.2
QSPI-51: U62.3, U64.58, U65.3
QSPI-52: U67.5, U69.57, U70.5
QSPI-53: U67.7, U69.55, U70.7
QSPI-54: U67.2, U69.59, U70.2
QSPI-55: U67.3, U69.58, U70.3
QSPI-56: U72.5, U74.57, U75.5
QSPI-57: U72.7, U74.55, U75.7
QSPI-58: U72.2, U74.59, U75.2
QSPI-59: U72.3, U74.58, U75.3
QSPI-60: U77.5, U79.57, U80.5
QSPI-61: U77.7, U79.55, U80.7
QSPI-62: U77.2, U79.59, U80.2
QSPI-63: U77.3, U79.58, U80.3
QSPI-64: U82.5, U84.57, U85.5
QSPI-65: U82.7, U84.55, U85.7
QSPI-66: U82.2, U84.59, U85.2
QSPI-67: U82.3, U84.58, U85.3
QSPI-68: U87.5, U89.57, U90.5
QSPI-69: U87.7, U89.55, U90.7
QSPI-70: U87.2, U89.59, U90.2
QSPI-71: U87.3, U89.58, U90.3
QSPI-72: U92.5, U94.57, U95.5
QSPI-73: U92.7, U94.55, U95.7
QSPI-74: U92.2, U94.59, U95.2
QSPI-75: U92.3, U94.58, U95.3
QSPI-76: U97.5, U99.57, U100.5
QSPI-77: U97.7, U99.55, U100.7
QSPI-78: U97.2, U99.59, U100.2
QSPI-79: U97.3, U99.58, U100.3
QSPI-80: U102.5, U104.57, U105.5
QSPI-81: U102.7, U104.55, U105.7
QSPI-82: U102.2, U104.59, U105.2
QSPI-83: U102.3, U104.58, U105.3
QSPI-84: U107.5, U109.57, U110.5
QSPI-85: U107.7, U109.55, U110.7
QSPI-86: U107.2, U109.59, U110.2
QSPI-87: U107.3, U109.58, U110.3
QSPI-88: U112.5, U114.57, U115.5
QSPI-89: U112.7, U114.55, U115.7
QSPI-90: U112.2, U114.59, U115.2
QSPI-91: U112.3, U114.58, U115.3
QSPI-92: U117.5, U119.57, U120.5
QSPI-93: U117.7, U119.55, U120.7
QSPI-94: U117.2, U119.59, U120.2
QSPI-95: U117.3, U119.58, U120.3
QSPI-CLK: U2.56, U4.6, U5.6
QSPI-CLK1: U7.6, U9.56, U10.6
QSPI-CLK2: U12.6, U14.56, U15.6
QSPI-CLK3: U17.6, U19.56, U20.6
QSPI-CLK4: U22.6, U24.56, U25.6
QSPI-CLK5: U27.6, U29.56, U30.6
QSPI-CLK6: U32.6, U34.56, U35.6
QSPI-CLK7: U37.6, U39.56, U40.6
QSPI-CLK8: U42.6, U44.56, U45.6
QSPI-CLK9: U47.6, U49.56, U50.6
QSPI-CLK10: U52.6, U54.56, U55.6
QSPI-CLK11: U57.6, U59.56, U60.6
QSPI-CLK12: U62.6, U64.56, U65.6
QSPI-CLK13: U67.6, U69.56, U70.6
QSPI-CLK14: U72.6, U74.56, U75.6
QSPI-CLK15: U77.6, U79.56, U80.6
QSPI-CLK16: U82.6, U84.56, U85.6
QSPI-CLK17: U87.6, U89.56, U90.6
QSPI-CLK18: U92.6, U94.56, U95.6
QSPI-CLK19: U97.6, U99.56, U100.6
QSPI-CLK20: U102.6, U104.56, U105.6
QSPI-CLK21: U107.6, U109.56, U110.6
QSPI-CLK22: U112.6, U114.56, U115.6
QSPI-CLK23: U117.6, U119.56, U120.6
RAW: C7.2, D2.C, J4.1, J4.1B, U1.1, U1.3, U3.VCC
RAW1: C4.2, D1.C, J7.1, J7.1B, U6.1, U6.3, U8.VCC
RAW2: C41.2, D3.C, J11.1, J11.1B, U11.1, U11.3, U13.VCC
RAW3: C61.2, D4.C, J15.1, J15.1B, U16.1, U16.3, U18.VCC
RAW4: C81.2, D5.C, J19.1, J19.1B, U21.1, U21.3, U23.VCC
RAW5: C101.2, D6.C, J23.1, J23.1B, U26.1, U26.3, U28.VCC
RAW6: C121.2, D7.C, J27.1, J27.1B, U31.1, U31.3, U33.VCC
RAW7: C141.2, D8.C, J31.1, J31.1B, U36.1, U36.3, U38.VCC
RAW8: C161.2, D9.C, J35.1, J35.1B, U41.1, U41.3, U43.VCC
RAW9: C181.2, D10.C, J39.1, J39.1B, U46.1, U46.3, U48.VCC
RAW10: C201.2, D11.C, J43.1, J43.1B, U51.1, U51.3, U53.VCC
RAW11: C221.2, D12.C, J47.1, J47.1B, U56.1, U56.3, U58.VCC
RAW12: C241.2, D13.C, J51.1, J51.1B, U61.1, U61.3, U63.VCC
RAW13: C261.2, D14.C, J55.1, J55.1B, U66.1, U66.3, U68.VCC
RAW14: C281.2, D15.C, J59.1, J59.1B, U71.1, U71.3, U73.VCC
RAW15: C301.2, D16.C, J63.1, J63.1B, U76.1, U76.3, U78.VCC
RAW16: C321.2, D17.C, J67.1, J67.1B, U81.1, U81.3, U83.VCC
RAW17: C341.2, D18.C, J71.1, J71.1B, U86.1, U86.3, U88.VCC
RAW18: C361.2, D19.C, J75.1, J75.1B, U91.1, U91.3, U93.VCC
RAW19: C381.2, D20.C, J79.1, J79.1B, U96.1, U96.3, U98.VCC
RAW20: C401.2, D21.C, J83.1, J83.1B, U101.1, U101.3, U103.VCC
RAW21: C421.2, D22.C, J87.1, J87.1B, U106.1, U106.3, U108.VCC
RAW22: C441.2, D23.C, J91.1, J91.1B, U111.1, U111.3, U113.VCC
RAW23: C461.2, D24.C, J95.1, J95.1B, U116.1, U116.3, U118.VCC
RP_D1+: R13.2, U2.52
RP_D1+1: R22.2, U9.52
RP_D1+2: R35.2, U14.52
RP_D1+3: R48.2, U19.52
RP_D1+4: R61.2, U24.52
RP_D1+5: R74.2, U29.52
RP_D1+6: R87.2, U34.52
RP_D1+7: R100.2, U39.52
RP_D1+8: R113.2, U44.52
RP_D1+9: R126.2, U49.52
RP_D1+10: R139.2, U54.52
RP_D1+11: R152.2, U59.52
RP_D1+12: R165.2, U64.52
RP_D1+13: R178.2, U69.52
RP_D1+14: R191.2, U74.52
RP_D1+15: R204.2, U79.52
RP_D1+16: R217.2, U84.52
RP_D1+17: R230.2, U89.52
RP_D1+18: R243.2, U94.52
RP_D1+19: R256.2, U99.52
RP_D1+20: R269.2, U104.52
RP_D1+21: R282.2, U109.52
RP_D1+22: R295.2, U114.52
RP_D1+23: R308.2, U119.52
RP_D1-: R12.2, U2.51
RP_D1-1: R21.2, U9.51
RP_D1-2: R34.2, U14.51
RP_D1-3: R47.2, U19.51
RP_D1-4: R60.2, U24.51
RP_D1-5: R73.2, U29.51
RP_D1-6: R86.2, U34.51
RP_D1-7: R99.2, U39.51
RP_D1-8: R112.2, U44.51
RP_D1-9: R125.2, U49.51
RP_D1-10: R138.2, U54.51
RP_D1-11: R151.2, U59.51
RP_D1-12: R164.2, U64.51
RP_D1-13: R177.2, U69.51
RP_D1-14: R190.2, U74.51
RP_D1-15: R203.2, U79.51
RP_D1-16: R216.2, U84.51
RP_D1-17: R229.2, U89.51
RP_D1-18: R242.2, U94.51
RP_D1-19: R255.2, U99.51
RP_D1-20: R268.2, U104.51
RP_D1-21: R281.2, U109.51
RP_D1-22: R294.2, U114.51
RP_D1-23: R307.2, U119.51
RP_D+: J5.A6, J5.B6, JP14.D+, R13.1
RP_D+1: J8.A6, J8.B6, JP7.D+, R22.1
RP_D+2: J12.A6, J12.B6, JP12.D+, R35.1
RP_D+3: J16.A6, J16.B6, JP18.D+, R48.1
RP_D+4: J20.A6, J20.B6, JP23.D+, R61.1
RP_D+5: J24.A6, J24.B6, JP28.D+, R74.1
RP_D+6: J28.A6, J28.B6, JP33.D+, R87.1
RP_D+7: J32.A6, J32.B6, JP38.D+, R100.1
RP_D+8: J36.A6, J36.B6, JP43.D+, R113.1
RP_D+9: J40.A6, J40.B6, JP48.D+, R126.1
RP_D+10: J44.A6, J44.B6, JP53.D+, R139.1
RP_D+11: J48.A6, J48.B6, JP58.D+, R152.1
RP_D+12: J52.A6, J52.B6, JP63.D+, R165.1
RP_D+13: J56.A6, J56.B6, JP68.D+, R178.1
RP_D+14: J60.A6, J60.B6, JP73.D+, R191.1
RP_D+15: J64.A6, J64.B6, JP78.D+, R204.1
RP_D+16: J68.A6, J68.B6, JP83.D+, R217.1
RP_D+17: J72.A6, J72.B6, JP88.D+, R230.1
RP_D+18: J76.A6, J76.B6, JP93.D+, R243.1
RP_D+19: J80.A6, J80.B6, JP98.D+, R256.1
RP_D+20: J84.A6, J84.B6, JP103.D+, R269.1
RP_D+21: J88.A6, J88.B6, JP108.D+, R282.1
RP_D+22: J92.A6, J92.B6, JP113.D+, R295.1
RP_D+23: J96.A6, J96.B6, JP118.D+, R308.1
RP_D-: J5.A7, J5.B7, JP14.D-, R12.1
RP_D-1: J8.A7, J8.B7, JP7.D-, R21.1
RP_D-2: J12.A7, J12.B7, JP12.D-, R34.1
RP_D-3: J16.A7, J16.B7, JP18.D-, R47.1
RP_D-4: J20.A7, J20.B7, JP23.D-, R60.1
RP_D-5: J24.A7, J24.B7, JP28.D-, R73.1
RP_D-6: J28.A7, J28.B7, JP33.D-, R86.1
RP_D-7: J32.A7, J32.B7, JP38.D-, R99.1
RP_D-8: J36.A7, J36.B7, JP43.D-, R112.1
RP_D-9: J40.A7, J40.B7, JP48.D-, R125.1
RP_D-10: J44.A7, J44.B7, JP53.D-, R138.1
RP_D-11: J48.A7, J48.B7, JP58.D-, R151.1
RP_D-12: J52.A7, J52.B7, JP63.D-, R164.1
RP_D-13: J56.A7, J56.B7, JP68.D-, R177.1
RP_D-14: J60.A7, J60.B7, JP73.D-, R190.1
RP_D-15: J64.A7, J64.B7, JP78.D-, R203.1
RP_D-16: J68.A7, J68.B7, JP83.D-, R216.1
RP_D-17: J72.A7, J72.B7, JP88.D-, R229.1
RP_D-18: J76.A7, J76.B7, JP93.D-, R242.1
RP_D-19: J80.A7, J80.B7, JP98.D-, R255.1
RP_D-20: J84.A7, J84.B7, JP103.D-, R268.1
RP_D-21: J88.A7, J88.B7, JP108.D-, R281.1
RP_D-22: J92.A7, J92.B7, JP113.D-, R294.1
RP_D-23: J96.A7, J96.B7, JP118.D-, R307.1
SHLD: J5.SHLD1, J5.SHLD2, J5.SHLD3, J5.SHLD4, SHLD.1
SHLD1: J8.SHLD1, J8.SHLD2, J8.SHLD3, J8.SHLD4, SHLD1.1
SHLD2: J12.SHLD1, J12.SHLD2, J12.SHLD3, J12.SHLD4, SHLD2.1
SHLD3: J16.SHLD1, J16.SHLD2, J16.SHLD3, J16.SHLD4, SHLD3.1
SHLD4: J20.SHLD1, J20.SHLD2, J20.SHLD3, J20.SHLD4, SHLD4.1
SHLD5: J24.SHLD1, J24.SHLD2, J24.SHLD3, J24.SHLD4, SHLD5.1
SHLD6: J28.SHLD1, J28.SHLD2, J28.SHLD3, J28.SHLD4, SHLD6.1
SHLD7: J32.SHLD1, J32.SHLD2, J32.SHLD3, J32.SHLD4, SHLD7.1
SHLD8: J36.SHLD1, J36.SHLD2, J36.SHLD3, J36.SHLD4, SHLD8.1
SHLD9: J40.SHLD1, J40.SHLD2, J40.SHLD3, J40.SHLD4, SHLD9.1
SHLD10: J44.SHLD1, J44.SHLD2, J44.SHLD3, J44.SHLD4, SHLD10.1
SHLD11: J48.SHLD1, J48.SHLD2, J48.SHLD3, J48.SHLD4, SHLD11.1
SHLD12: J52.SHLD1, J52.SHLD2, J52.SHLD3, J52.SHLD4, SHLD12.1
SHLD13: J56.SHLD1, J56.SHLD2, J56.SHLD3, J56.SHLD4, SHLD13.1
SHLD14: J60.SHLD1, J60.SHLD2, J60.SHLD3, J60.SHLD4, SHLD14.1
SHLD15: J64.SHLD1, J64.SHLD2, J64.SHLD3, J64.SHLD4, SHLD15.1
SHLD16: J68.SHLD1, J68.SHLD2, J68.SHLD3, J68.SHLD4, SHLD16.1
SHLD17: J72.SHLD1, J72.SHLD2, J72.SHLD3, J72.SHLD4, SHLD17.1
SHLD18: J76.SHLD1, J76.SHLD2, J76.SHLD3, J76.SHLD4, SHLD18.1
SHLD19: J80.SHLD1, J80.SHLD2, J80.SHLD3, J80.SHLD4, SHLD19.1
SHLD20: J84.SHLD1, J84.SHLD2, J84.SHLD3, J84.SHLD4, SHLD20.1
SHLD21: J88.SHLD1, J88.SHLD2, J88.SHLD3, J88.SHLD4, SHLD21.1
SHLD22: J92.SHLD1, J92.SHLD2, J92.SHLD3, J92.SHLD4, SHLD22.1
SHLD23: J96.SHLD1, J96.SHLD2, J96.SHLD3, J96.SHLD4, SHLD23.1
SWDCK: TP1.1, U2.24
SWDCK1: TP5.1, U9.24
SWDCK2: TP9.1, U14.24
SWDCK3: TP13.1, U19.24
SWDCK4: TP17.1, U24.24
SWDCK5: TP21.1, U29.24
SWDCK6: TP25.1, U34.24
SWDCK7: TP29.1, U39.24
SWDCK8: TP33.1, U44.24
SWDCK9: TP37.1, U49.24
SWDCK10: TP41.1, U54.24
SWDCK11: TP45.1, U59.24
SWDCK12: TP49.1, U64.24
SWDCK13: TP53.1, U69.24
SWDCK14: TP57.1, U74.24
SWDCK15: TP61.1, U79.24
SWDCK16: TP65.1, U84.24
SWDCK17: TP69.1, U89.24
SWDCK18: TP73.1, U94.24
SWDCK19: TP77.1, U99.24
SWDCK20: TP81.1, U104.24
SWDCK21: TP85.1, U109.24
SWDCK22: TP89.1, U114.24
SWDCK23: TP93.1, U119.24
SWDIO: TP2.1, U2.25
SWDIO1: TP6.1, U9.25
SWDIO2: TP10.1, U14.25
SWDIO3: TP14.1, U19.25
SWDIO4: TP18.1, U24.25
SWDIO5: TP22.1, U29.25
SWDIO6: TP26.1, U34.25
SWDIO7: TP30.1, U39.25
SWDIO8: TP34.1, U44.25
SWDIO9: TP38.1, U49.25
SWDIO10: TP42.1, U54.25
SWDIO11: TP46.1, U59.25
SWDIO12: TP50.1, U64.25
SWDIO13: TP54.1, U69.25
SWDIO14: TP58.1, U74.25
SWDIO15: TP62.1, U79.25
SWDIO16: TP66.1, U84.25
SWDIO17: TP70.1, U89.25
SWDIO18: TP74.1, U94.25
SWDIO19: TP78.1, U99.25
SWDIO20: TP82.1, U104.25
SWDIO21: TP86.1, U109.25
SWDIO22: TP90.1, U114.25
SWDIO23: TP94.1, U119.25
USB_RAW: D2.A, F1.2
USB_RAW1: D1.A, F2.2
USB_RAW2: D3.A, F3.2
USB_RAW3: D4.A, F4.2
USB_RAW4: D5.A, F5.2
USB_RAW5: D6.A, F6.2
USB_RAW6: D7.A, F7.2
USB_RAW7: D8.A, F8.2
USB_RAW8: D9.A, F9.2
USB_RAW9: D10.A, F10.2
USB_RAW10: D11.A, F11.2
USB_RAW11: D12.A, F12.2
USB_RAW12: D13.A, F13.2
USB_RAW13: D14.A, F14.2
USB_RAW14: D15.A, F15.2
USB_RAW15: D16.A, F16.2
USB_RAW16: D17.A, F17.2
USB_RAW17: D18.A, F18.2
USB_RAW18: D19.A, F19.2
USB_RAW19: D20.A, F20.2
USB_RAW20: D21.A, F21.2
USB_RAW21: D22.A, F22.2
USB_RAW22: D23.A, F23.2
USB_RAW23: D24.A, F24.2
VDDA: C22.1, R14.1, U2.44, U2.46
VDDA1: C35.1, R23.1, U9.44, U9.46
VDDA2: C55.1, R36.1, U14.44, U14.46
VDDA3: C75.1, R49.1, U19.44, U19.46
VDDA4: C95.1, R62.1, U24.44, U24.46
VDDA5: C115.1, R75.1, U29.44, U29.46
VDDA6: C135.1, R88.1, U34.44, U34.46
VDDA7: C155.1, R101.1, U39.44, U39.46
VDDA8: C175.1, R114.1, U44.44, U44.46
VDDA9: C195.1, R127.1, U49.44, U49.46
VDDA10: C215.1, R140.1, U54.44, U54.46
VDDA11: C235.1, R153.1, U59.44, U59.46
VDDA12: C255.1, R166.1, U64.44, U64.46
VDDA13: C275.1, R179.1, U69.44, U69.46
VDDA14: C295.1, R192.1, U74.44, U74.46
VDDA15: C315.1, R205.1, U79.44, U79.46
VDDA16: C335.1, R218.1, U84.44, U84.46
VDDA17: C355.1, R231.1, U89.44, U89.46
VDDA18: C375.1, R244.1, U94.44, U94.46
VDDA19: C395.1, R257.1, U99.44, U99.46
VDDA20: C415.1, R270.1, U104.44, U104.46
VDDA21: C435.1, R283.1, U109.44, U109.46
VDDA22: C455.1, R296.1, U114.44, U114.46
VDDA23: C475.1, R309.1, U119.44, U119.46
V_USB: F1.1, J5.VBUS1, J5.VBUS2, JP14.VBUS
V_USB1: F2.1, J8.VBUS1, J8.VBUS2, JP7.VBUS
V_USB2: F3.1, J12.VBUS1, J12.VBUS2, JP12.VBUS
V_USB3: F4.1, J16.VBUS1, J16.VBUS2, JP18.VBUS
V_USB4: F5.1, J20.VBUS1, J20.VBUS2, JP23.VBUS
V_USB5: F6.1, J24.VBUS1, J24.VBUS2, JP28.VBUS
V_USB6: F7.1, J28.VBUS1, J28.VBUS2, JP33.VBUS
V_USB7: F8.1, J32.VBUS1, J32.VBUS2, JP38.VBUS
V_USB8: F9.1, J36.VBUS1, J36.VBUS2, JP43.VBUS
V_USB9: F10.1, J40.VBUS1, J40.VBUS2, JP48.VBUS
V_USB10: F11.1, J44.VBUS1, J44.VBUS2, JP53.VBUS
V_USB11: F12.1, J48.VBUS1, J48.VBUS2, JP58.VBUS
V_USB12: F13.1, J52.VBUS1, J52.VBUS2, JP63.VBUS
V_USB13: F14.1, J56.VBUS1, J56.VBUS2, JP68.VBUS
V_USB14: F15.1, J60.VBUS1, J60.VBUS2, JP73.VBUS
V_USB15: F16.1, J64.VBUS1, J64.VBUS2, JP78.VBUS
V_USB16: F17.1, J68.VBUS1, J68.VBUS2, JP83.VBUS
V_USB17: F18.1, J72.VBUS1, J72.VBUS2, JP88.VBUS
V_USB18: F19.1, J76.VBUS1, J76.VBUS2, JP93.VBUS
V_USB19: F20.1, J80.VBUS1, J80.VBUS2, JP98.VBUS
V_USB20: F21.1, J84.VBUS1, J84.VBUS2, JP103.VBUS
V_USB21: F22.1, J88.VBUS1, J88.VBUS2, JP108.VBUS
V_USB22: F23.1, J92.VBUS1, J92.VBUS2, JP113.VBUS
V_USB23: F24.1, J96.VBUS1, J96.VBUS2, JP118.VBUS
WS2812-DO: TP3.1, U3.DO
WS2812-DO1: TP7.1, U8.DO
WS2812-DO2: TP11.1, U13.DO
WS2812-DO3: TP15.1, U18.DO
WS2812-DO4: TP19.1, U23.DO
WS2812-DO5: TP23.1, U28.DO
WS2812-DO6: TP27.1, U33.DO
WS2812-DO7: TP31.1, U38.DO
WS2812-DO8: TP35.1, U43.DO
WS2812-DO9: TP39.1, U48.DO
WS2812-DO10: TP43.1, U53.DO
WS2812-DO11: TP47.1, U58.DO
WS2812-DO12: TP51.1, U63.DO
WS2812-DO13: TP55.1, U68.DO
WS2812-DO14: TP59.1, U73.DO
WS2812-DO15: TP63.1, U78.DO
WS2812-DO16: TP67.1, U83.DO
WS2812-DO17: TP71.1, U88.DO
WS2812-DO18: TP75.1, U93.DO
WS2812-DO19: TP79.1, U98.DO
WS2812-DO20: TP83.1, U103.DO
WS2812-DO21: TP87.1, U108.DO
WS2812-DO22: TP91.1, U113.DO
WS2812-DO23: TP95.1, U118.DO
X1: C10.2, U9.21, Y2.P3
X1A: R10.2, U2.22
X1A1: R20.2, U9.22
X1A2: R33.2, U14.22
X1A3: R46.2, U19.22
X1A4: R59.2, U24.22
X1A5: R72.2, U29.22
X1A6: R85.2, U34.22
X1A7: R98.2, U39.22
X1A8: R111.2, U44.22
X1A9: R124.2, U49.22
X1A10: R137.2, U54.22
X1A11: R150.2, U59.22
X1A12: R163.2, U64.22
X1A13: R176.2, U69.22
X1A14: R189.2, U74.22
X1A15: R202.2, U79.22
X1A16: R215.2, U84.22
X1A17: R228.2, U89.22
X1A18: R241.2, U94.22
X1A19: R254.2, U99.22
X1A20: R267.2, U104.22
X1A21: R280.2, U109.22
X1A22: R293.2, U114.22
X1A23: R306.2, U119.22
X1B: C11.2, R10.1, Y1.P1
X1B1: C6.2, R20.1, Y2.P1
X1B2: C43.2, R33.1, Y3.P1
X1B3: C63.2, R46.1, Y4.P1
X1B4: C83.2, R59.1, Y5.P1
X1B5: C103.2, R72.1, Y6.P1
X1B6: C123.2, R85.1, Y7.P1
X1B7: C143.2, R98.1, Y8.P1
X1B8: C163.2, R111.1, Y9.P1
X1B9: C183.2, R124.1, Y10.P1
X1B10: C203.2, R137.1, Y11.P1
X1B11: C223.2, R150.1, Y12.P1
X1B12: C243.2, R163.1, Y13.P1
X1B13: C263.2, R176.1, Y14.P1
X1B14: C283.2, R189.1, Y15.P1
X1B15: C303.2, R202.1, Y16.P1
X1B16: C323.2, R215.1, Y17.P1
X1B17: C343.2, R228.1, Y18.P1
X1B18: C363.2, R241.1, Y19.P1
X1B19: C383.2, R254.1, Y20.P1
X1B20: C403.2, R267.1, Y21.P1
X1B21: C423.2, R280.1, Y22.P1
X1B22: C443.2, R293.1, Y23.P1
X1B23: C463.2, R306.1, Y24.P1
X2: C13.2, U2.21, Y1.P3
X3: C44.2, U14.21, Y3.P3
X4: C64.2, U19.21, Y4.P3
X5: C84.2, U24.21, Y5.P3
X6: C104.2, U29.21, Y6.P3
X7: C124.2, U34.21, Y7.P3
X8: C144.2, U39.21, Y8.P3
X9: C164.2, U44.21, Y9.P3
X10: C184.2, U49.21, Y10.P3
X11: C204.2, U54.21, Y11.P3
X12: C224.2, U59.21, Y12.P3
X13: C244.2, U64.21, Y13.P3
X14: C264.2, U69.21, Y14.P3
X15: C284.2, U74.21, Y15.P3
X16: C304.2, U79.21, Y16.P3
X17: C324.2, U84.21, Y17.P3
X18: C344.2, U89.21, Y18.P3
X19: C364.2, U94.21, Y19.P3
X20: C384.2, U99.21, Y20.P3
X21: C404.2, U104.21, Y21.P3
X22: C424.2, U109.21, Y22.P3
X23: C444.2, U114.21, Y23.P3
X24: C464.2, U119.21, Y24.P3
