sparkfun/SparkFun_Pro_Micro_RP2350/(commit log)

2024-01-08 Add initial design
    Based on ProMicro RP2040 design
    [SparkFun_ProMicro-RP2040.brd, SparkFun_ProMicro-RP2040.sch]
2024-01-08 Cleanup
    Rename design files
    Change version number to v01
    Update attributions
    Update silk name
    Update ordering instructions
    Update measures
    Update SPI data net names to POCI and PICO
    [SparkFun_ProMicro_RP2350.brd, SparkFun_ProMicro_RP2350.sch]
2024-01-08 Update board thickness
    [SparkFun_ProMicro_RP2350.brd]
2024-01-08 More cleanup
    Add test point for BOOT net
    Nudge a few traces and vias to improve copper pours
    Approve DRC errors
    Fix traces overlapping vias
    Fix acid traps
    [SparkFun_ProMicro_RP2350.brd, SparkFun_ProMicro_RP2350.sch]
2024-01-08 Change C20 and C21 from 2.2uF to 10uF
    Recommended by hardware guidelines
    [SparkFun_ProMicro_RP2350.brd, SparkFun_ProMicro_RP2350.sch]
2024-01-09 Design review updates
    Change regulator to RT9080
    Add USB shield jumper and polygon to connect USB shield pads
    Change PWR jumper silk to just be "P" and orient at 90 with silk polygon to connect it
    Remove C6
    [SparkFun_ProMicro_RP2350.brd, SparkFun_ProMicro_RP2350.sch]
2024-01-09 Clean up schematic
    Rearrange sections to use whole frame
    Update section titles
    Move power LED and Qwiic connector to their own sections
    Add text to jumpers indicating their functions
    Change power LED to new version and update resistor
    Swap VREG_AVDD and VREG_VIN pins on RP235 symbol to give more space for inductor in schematic
    [SparkFun_ProMicro_RP2350.brd, SparkFun_ProMicro_RP2350.sch]
2024-01-09 Update WS2812 symbol
    Use new version so Eagle stops complaining
    [SparkFun_ProMicro_RP2350.brd, SparkFun_ProMicro_RP2350.sch]
2024-01-09 Use correct 1.1V power symbol
    Remove dependence on RP2040 library
    [SparkFun_ProMicro_RP2350.sch]
2024-01-09 Use castellated pad device from SparkFun lib
    Remove dependency of "Castellated" lib
    [SparkFun_ProMicro_RP2350.brd, SparkFun_ProMicro_RP2350.sch]
2024-01-09 Add "Castellated Leads" to ordering instructions
    [SparkFun_ProMicro_RP2350.brd]
2024-01-10 Design review updates
    Change all text and labels in schematic to vector font
    Fix overlapping text with Qwiic connector in schematic
    Add part number to flash memory section title
    Fix acid trap on RAW pad
    Add more GND vias
    [SparkFun_ProMicro_RP2350.brd, SparkFun_ProMicro_RP2350.sch]
2024-01-10 DFM adjustments
    Nudge C1 away from C2
    Nudge C20 away from L1
    [SparkFun_ProMicro_RP2350.brd]
2024-01-10 Improve button silk
    Remove "B" silk label from boot button
    Increase size of "R" silk label for reset button
    Add "BOOT" and "RST" silk to bottom with button symbols
    Move Qwiic logo and test point labels up
    [SparkFun_ProMicro_RP2350.brd]
2024-01-10 Add v01 production files
    [SparkFun_ProMicro_RP2350-Panel.GBL, SparkFun_ProMicro_RP2350-Panel.GBO, SparkFun_ProMicro_RP2350-Panel.GBP, SparkFun_ProMicro_RP2350-Panel.GBS, SparkFun_ProMicro_RP2350-Panel.GKO, SparkFun_ProMicro_RP2350-Panel.GTL, SparkFun_ProMicro_RP2350-Panel.GTO, SparkFun_ProMicro_RP2350-Panel.GTP]
2024-01-15 Add PROD_ID for RP2350A
    [SparkFun_ProMicro_RP2350.brd, SparkFun_ProMicro_RP2350.sch]
2024-02-26 v10 updates
    Bump version number to v10
    Move bottom pin silk labels away from pads
    [SparkFun_ProMicro_RP2350.brd, SparkFun_ProMicro_RP2350.sch]
2024-02-28 Design review updates
    Re-enable layers that accidentally got turned off
    Nudge BOOT and RST silk to be better centered over button art
    Add better silk dot to crystal
    [SparkFun_ProMicro_RP2350.brd]
2024-02-28 Add v10 production files
    [SparkFun_ProMicro_RP2350-Panel.brd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]
2024-03-12 Add PSRAM
    [SparkFun_ProMicro_RP2350.brd, SparkFun_ProMicro_RP2350.sch]
2024-03-12 Change version number to v09
    [SparkFun_ProMicro_RP2350.brd, SparkFun_ProMicro_RP2350.sch]
2024-03-12 Add v09 panel files
    [SparkFun_ProMicro_RP2350-Panel.brd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]
2024-03-12 Move power components to bottom
    Gives more clearance between components to hopefully improve production yields
    [SparkFun_ProMicro_RP2350.brd]
2024-03-15 Design review updates
    Change version number to v02 instead of jumping to v09
    Add PROD_ID to PSRAM
    Nudge BOOT trace away from UART trace on adjacent layer
    Fix "2" silk on bottom
    Nudge C13 away from "6" silk on top
    Fix acid trap on pad 5 of U1
    [SparkFun_ProMicro_RP2350.brd, SparkFun_ProMicro_RP2350.sch]
2024-03-15 Add v02 panel files
    [SparkFun_ProMicro_RP2350-Panel.GBL, SparkFun_ProMicro_RP2350-Panel.GBO, SparkFun_ProMicro_RP2350-Panel.GBP, SparkFun_ProMicro_RP2350-Panel.GBS, SparkFun_ProMicro_RP2350-Panel.GTL, SparkFun_ProMicro_RP2350-Panel.GTO, SparkFun_ProMicro_RP2350-Panel.GTP, SparkFun_ProMicro_RP2350-Panel.GTS]
2024-06-04 Bump version number to v10
    [SparkFun_ProMicro_RP2350.brd, SparkFun_ProMicro_RP2350.sch]
2024-06-06 Design review updates
    Rotate BOOT flag to horizontal in schematic
    [SparkFun_ProMicro_RP2350.sch]
2024-06-06 Remove extra polarity indicator in silkscreen
    [SparkFun_ProMicro_RP2350-Panel.brd, SparkFun_ProMicro_RP2350.brd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]
2024-08-01 Docs update
    Adding assembly photos & updating assembly & software sections for camera demo example.
2024-08-08 Release update
    Updates for product release. Adding relevant component files & Raspberry Pi links for RP2350.
2024-08-17 Update README.md
    add link to sparkfun-pico repo in docs section
2024-08-19 Update micropython_examples.md
    Fixing LED example typo.
2024-08-29 Docs software update
    Adding updated MicroPython links and Arduino IDE section
2024-12-04 Adding CircuitPython
    Adding CircuitPython docs page w/updates to relevant pages.
